desanv01/Flight-Controller-V1/firmware/README.md

# V1 firmware status

No demonstrated final firmware build for the published custom board is available in the inspected package. The historical resource matrix/parser work is in docs/development/records/03-interface-freeze and the development archive. It establishes candidate resource allocation, not a qualified executable firmware.

Use the final schematic/resource map for any board-specific port. V2 binaries and target files are not compatible substitutes. Runtime sensor, power/failsafe and motor-waveform qualification remain outstanding.
