desanv01/Flight-Controller-V1/docs/exports/README.md

# Readable design exports

Schematic, assembly and fabrication PDFs are generated from the exact neutral source. The physical-validation worksheet is blank and must be completed on actual hardware. CAD renders are not photographs.

- [Schematic](schematic.pdf)
- [Assembly](assembly.pdf)
- [Fabrication drawing](fabrication.pdf)
- [Physical worksheet](physical-validation.pdf)
