desanv01/Flight-Controller-V1/docs/overview.md

# Flight Controller V1

Custom STM32H743VIT6 controller developed through staged schematic capture, resource allocation, placement and a six-layer PCB routing rework. The repository preserves its engineering design, manufacturing data and development record.

Engineering prototype. Fabrication data is available; assembly sourcing, stack selection and physical validation remain outstanding. No final V1 firmware build is claimed.

[Contribution statement](../CONTRIBUTIONS.md) · [Source](../hardware/README.md) · [History](development/timeline.md).
