desanv01/Flight-Controller-V1/docs/portfolio/resume-bullets.md

# Resume-ready project wording

Project: **Flight Controller V1**. Contributor: Desan Vasu. Dates reflect technical records, not employment dates. Fabrication external. Select bullets for the intended role rather than using all of them.

- Designed and documented an STM32H743 flight-controller prototype through resource allocation, schematic capture and six-layer PCB implementation.
- Reworked a constrained placement/routing study into an approximately 104 mm board, documenting reference-plane, DNP-isolation and schematic-parity corrections.
- Prepared source-associated manufacturing packages and reviewed native ERC/DRC results with explicit warning and DNP exceptions.

Do not add flight performance, deployment, production reliability or successful powered sensor tests without measured evidence. Original upstream and reference-library work remains separately credited.
