desanv01/Flight-Controller-V1/fabrication/jlcpcb/fabrication/drill-report.txt

Drill report for FC_REV_A.kicad_pcb
Created on 2026-10-14T18:23:01

Copper Layer Stackup:
    =============================================================
    L1 :  F.Cu                      front
    L2 :  GND                       in1
    L3 :  SIGNAL_1                  in2
    L4 :  SIGNAL_2                  in3
    L5 :  POWER                     in4
    L6 :  B.Cu                      back

Drill file 'FC_REV_A-PTH.drl' contains
    plated through holes:
    =============================================================
    T1  0.200mm  0.0079"  (7 holes))
    T2  0.250mm  0.0098"  (524 holes))
    T3  0.600mm  0.0236"  (4 holes)  (with 4 slots)
    T4  1.020mm  0.0402"  (4 holes))

    Total plated holes count 539

Drill file 'FC_REV_A-NPTH.drl' contains
    unplated through holes:
    =============================================================
    T1  0.650mm  0.0256"  (2 holes))
    T2  0.950mm  0.0374"  (2 holes))
    T3  1.020mm  0.0402"  (2 holes))
    T4  2.200mm  0.0866"  (4 holes))
    T5  3.000mm  0.1181"  (1 hole)

    Total unplated holes count 11
