desanv01/Flight-Controller-V1/docs/development/milestones/09-schematic-review.md

# Schematic, footprint and BOM review

Version: V1. Historical evidence period: 2026-09-10. Imported: 14 October 2026.

This milestone preserves technical records. Exact source recovery is recorded separately; document dates do not establish employment dates or physical test completion.

- [FC_REV_A_STAGE_08_CONTROL_REVIEW_2026-09-10.md](../records/09-schematic-review/FC_REV_A_STAGE_08_CONTROL_REVIEW_2026-09-10.md)
- [FC_REV_A_STAGE_08_SCHEMATIC_REVIEW_SYMBOLS_FOOTPRINTS_2026-09-10.md](../records/09-schematic-review/FC_REV_A_STAGE_08_SCHEMATIC_REVIEW_SYMBOLS_FOOTPRINTS_2026-09-10.md)
