desanv01/Flight-Controller-V1/CONTRIBUTIONS.md

# Contributions

**Desan Vasu** ([desanv01](https://github.com/desanv01)) confirmed on 14 October 2026 that the project activities, except physical fabrication, were performed by him. This includes requirements, design/adaptation, CAD review, firmware-related work, build activity, integration preparation, soldering and test activity. Original upstream authorship remains credited separately.

Documented development period: 26 August–14 September 2026. These dates are based on technical records and are not a confirmed employment period or job title.

The repository documents available artifacts and saved/repeated checks. Personal activity confirmation does not establish a particular measured test passed: powered-board, sensor, thermal and flight qualification remain unestablished in the provided evidence. Fabrication was external and is not claimed as personal manufacture.

V1 is the staged custom-controller project; third-party symbols, footprint geometry and source references retain their attribution.
