desanv01/Flight-Controller-V1/docs/development/timeline.md

# Development timeline

Historical dates below come from project records; new import commits use the actual publication date.

| Period | Milestone | Source status | Tag |
|---|---|---|---|
| 2026-08-26 to 2026-08-27 | [Research and architecture baseline](milestones/01-research.md) | Technical records; native fragment archive | `v1-01-research` |
| 2026-08-28 to 2026-09-07 | [Circuit selection and subsystem boundaries](milestones/02-selection.md) | Technical records; native fragment archive | `v1-02-selection` |
| 2026-09-07 | [MCU resource and interface freeze](milestones/03-interface-freeze.md) | Technical records; native fragment archive | `v1-03-interface-freeze` |
| 2026-09-07 | [KiCad foundation](milestones/04-foundation.md) | Technical records; native fragment archive | `v1-04-foundation` |
| 2026-09-07 to 2026-09-08 | [STM32H743 core capture](milestones/05-mcu-core.md) | Technical records; native fragment archive | `v1-05-mcu-core` |
| 2026-09-08 to 2026-09-09 | [Power tree and correction sequence](milestones/06-power.md) | Technical records; native fragment archive | `v1-06-power` |
| 2026-09-09 | [IMU and barometer capture](milestones/07-sensors.md) | Technical records; native fragment archive | `v1-07-sensors` |
| 2026-09-09 to 2026-09-10 | [External interfaces and correction closeout](milestones/08-interfaces.md) | Technical records; native fragment archive | `v1-08-interfaces` |
| 2026-09-10 | [Schematic, footprint and BOM review](milestones/09-schematic-review.md) | Technical records; native fragment archive | `v1-09-schematic-review` |
| 2026-09-10 | [Four-layer placement study](milestones/10-placement.md) | Technical records; native fragment archive | `v1-10-placement` |
| 2026-09-10 to 2026-09-11 | [Initial routing and blockers](milestones/11-routing.md) | Technical records; native fragment archive | `v1-11-routing` |

## Later milestones

V1 continues through six-layer floorplan/routing rework, plane-order and DNP corrections, required-link closeout, final Y2/parity correction and engineering vendor packages. See rework records and v1-parity-closeout.

Neutral naming, metadata reconciliation, source checks, regenerated exports and portfolio presentation are publication work on 14 October 2026. Original exact names/paths remain in private provenance; public hashes describe the transformed source. [Archive](../../archive/README.md).
