desanv01/Flight-Controller-V1/docs/development/records/01-research/FC_REV_A_DECISION_BASELINE_2026-08-27.md

> Historical technical record. Names and private workstation/session references were neutralized for publication. Dates and assertions describe the recorded stage, not current physical qualification. See the current validation-status page for later checks.

# Flight Controller Rev A — Decision Baseline and Interface Contract

Date: 2026-08-27

Revision note: this revision adds the Pixhawk-style modular connectivity decision and the external-port contract. The current addendum also fixes the companion-computer definition to Raspberry Pi Compute Module 5 (CM5), and adds the ESC, motor, LiPo/power, lidar and camera integration boundary.

## Authority and scope

The current user message is the controlling instruction set. The earlier research report is background/reference material; its section numbering, recommendations, and preliminary BOM are not fabrication instructions. This is a student prototype plan, not an aircraft-certification or ready-to-fly approval.

## Decisions now treated as fixed

- The flight controller must be a custom PCB containing a bare MCU chip and the surrounding components. No ready-made MCU/FC development board is the final flight controller.
- The first design should clone/adapt a proven open DIY/reference design wherever practical, because the implementation window is less than one month.
- The FC, ESC/motor board, transmitter/receiver, camera attachment, and lidar attachment are separate team workstreams and must be joined through an explicit interface contract.
- Raspberry Pi Compute Module 5 (CM5) is the optional companion computer. A standard Raspberry Pi 5 SBC is not the selected airborne form factor. CM5 must be mounted on a separate CM5IO/custom carrier board; it must not be soldered directly onto the FC PCB and must not be required for the FC's basic stabilization or RC-loss response.
- The FC shall use a Pixhawk-style, system-level modular architecture: ESCs, receiver, telemetry, CM5 carrier, GNSS/compass, CAN peripherals, and applicable lidar/auxiliary sensors connect through keyed external ports rather than being permanently soldered to the FC assembly.
- Rev A shall use a hybrid sensor boundary: the primary high-rate IMU and barometer stay on the FC PCB; the compass/GNSS and other replaceable or noise-sensitive peripherals are external. A remote IMU/barometer is a future sensor-node option, not a raw long-cable Rev A connection.
- The FC is a logic-and-sensing board, not the propulsion power-distribution board: the FC receives regulated 5 V and measurement signals, while battery current, motor phases, ESC switching heat and high-current copper remain on the separate ESC/power assembly.
- The preferred low-current external connector family is a keyed/latching JST-GH 1.25 mm family or an electrically equivalent locking family. This is a project-level recommendation; the board is called Pixhawk-inspired until the exact Pixhawk standard revision and pinout are deliberately followed and verified.
- The perception split is fixed for Rev A: camera data and scanning/3-D lidar data are processed on CM5; only validated, time-bounded results or high-level setpoints cross to the FC. A downward scalar rangefinder may connect directly to the FC when its voltage/protocol/driver are verified.
- The first flight milestone is a controlled bench/rig demonstration. Propeller-off tests, current limiting, inspection, and instructor/team approval are required before any powered flight test.

## Working hardware baseline — provisional until parts are frozen

Use the H7/Shirley architecture as the closest starting point, with OpenFC and Betaflight layout rules as cross-checks:

- STM32H743VIT6, bare LQFP MCU, with USB, SWD, boot/reset, debug test points, and enough UART/SPI/I2C/CAN resources.
- ICM-42688-P as the primary high-rate IMU on SPI, with its own low-noise sensor supply and a dedicated chip-select/interrupt connection.
- BMP390 on I2C; external magnetometer/GNSS preferred so the magnetic sensor is physically separated from switching power and motor wiring.
- Four motor outputs required for the quad; reserve a clean eight-output-capable timer map only if it does not compromise the first board.
- Regulated 5 V input from the power/ESC side for Rev A, USB-C as a protected bench/debug input, and separate digital/sensor regulation. Do not route motor current through the FC.
- External flash or microSD logging only if it can be implemented without delaying the minimum FC bring-up.

These parts remain recommendations, not purchase authorization. Exact MPN, package, footprint, availability, voltage, current, and firmware support must be checked before the schematic is released.

## Modularity decision

### What “Pixhawk-style modular” means for this project

The project should copy the *system principle* of Pixhawk: a small real-time flight-control core with standardized, labeled, replaceable external interfaces. It does not mean that every sensor IC must be physically outside the FC, and it does not automatically make the custom board electrically compatible with a Pixhawk. The official Pixhawk standards cover pinouts, architecture, PCB guidance, and connector specifications; exact compatibility requires following the selected standard revision rather than merely using the same connector family.

The practical Rev A boundary is:

```text
ON THE FC PCB                         EXTERNAL / REPLACEABLE MODULES
----------------                      -----------------------------
STM32H743 + power                    ESC / motor board
Primary ICM-42688-P IMU              RC receiver
BMP390 barometer                     GNSS + external compass
USB-C / SWD / boot                   Telemetry radio
CAN transceiver(s)                   Raspberry Pi CM5 + carrier
ADC protection                       Downward or simple lidar
                                     Scanning lidar and camera via CM5
```

This is “externally modular, internally deterministic.” It satisfies the team’s modular connection requirement while keeping the sensor data used by the fastest stabilization loop on short, controlled PCB traces.

### Architecture options considered

| Option | FC-board contents | Advantages | Main risks/costs | Rev A decision |
|---|---|---|---|---|
| Fully modular raw-sensor FC | MCU and power only; IMU, barometer, compass, GNSS and other sensors are all external | Maximum replaceability, easy physical separation, very visible modularity | Remote SPI/I2C wiring, cable capacitance/EMI, connector failure, extra latency and timestamp uncertainty, sensor-frame/alignment work, more firmware, no local sensor for reliable boot/bring-up | **Reject for Rev A** |
| Hybrid Pixhawk-style FC | MCU, primary IMU and barometer on board; ESC, receiver, GNSS/compass, CM5, telemetry, CAN and suitable lidar external | Good control-loop integrity, external compass placement, serviceable team interfaces, realistic firmware and PCB scope | More connectors and protection than a compact FPV FC; still requires precise port and firmware definition | **Adopt for Rev A** |
| Mostly onboard FC | MCU and most sensors on board; only ESC, receiver and CM5 external | Lowest connector count and simplest harness | Compass is closer to switching/motor fields; less serviceable; conflicts with the separate sensor workstreams | **Not the selected architecture** |

### Why the primary IMU stays onboard

The rate loop depends on frequent, time-consistent gyro/accelerometer samples. A local SPI IMU gives short traces, a controlled return path, a known mechanical relationship to the FC, and a predictable interrupt/timestamp path. A remote IMU is possible, but it should be a complete smart sensor node with its own MCU, timestamping, calibration and CAN/DroneCAN interface. It should not be a bare IMU hanging from a long unbuffered SPI or I2C cable.

The onboard IMU is therefore a reliability and schedule decision, not a rejection of modular design. A future Rev B may add a second onboard IMU or a remote CAN IMU node if the firmware and validation plan justify it.

### Why the barometer stays onboard for Rev A

The BMP390 is low-rate compared with the IMU, but an onboard device avoids a second remote sensor protocol and connector. It must be placed under a protected vent, away from direct prop wash and pressure disturbances. If the airframe requires a physically remote pressure location, use a dedicated external sensor node with a documented pressure inlet and CAN/UART interface; do not simply extend a raw I2C cable without checking bus capacitance and rise time.

### Why the compass/GNSS is external

The compass benefits from being physically separated from battery conductors, motor phases, ESC switching currents, inductors and ferromagnetic hardware. GNSS also needs antenna placement and sky visibility that the FC PCB cannot guarantee. The preferred module is an external GPS/compass unit connected by UART plus I2C, or by DroneCAN where a compatible node is available. Its mounting orientation and position relative to the FC must be documented for firmware calibration and frame transforms.

## Modular bus and connector strategy

### Bus selection

| Bus/interface | Rev A use | Cable rule | Design decision |
|---|---|---|---|
| SPI | Primary onboard IMU, memory, SD, and other local devices | Keep on the PCB or on a very short, mechanically retained daughterboard; route over a continuous return path | Do not expose the high-rate IMU SPI bus as a general long harness |
| I2C | Onboard BMP390 and short external compass/low-speed accessory port | Treat as a short, low-speed bus; calculate total pull-up/cable/connector capacitance; make pull-ups selectable | Suitable for GPS/compass only when the cable and loading are verified |
| UART | RC receiver, GNSS, telemetry radio, simple lidar, and FC↔CM5 MAVLink/data link | Point-to-point; signal level must be compatible; include a ground return | Use dedicated labeled UART ports rather than one ambiguous expansion header |
| CAN / DroneCAN | Remote sensor nodes, external GNSS/compass, lidar nodes, and CAN-capable ESC/power modules | Differential pair, line topology, short stubs, 120 Ω termination only at the two bus ends | Preferred robust path for future smart external sensors |
| PWM/DShot | FC to the external ESC board | One defined signal and ground return per output; no motor current on this harness | Four outputs required; bidirectional DShot telemetry only if the selected firmware/ESC path supports it |
| USB/CSI-2/Ethernet | Camera and high-volume data on CM5 | Camera stays on CM5; do not route camera frames through the FC | FC gets only trigger/status or processed measurements when required |

NXP’s I2C specification treats wire, connector and pin capacitance as part of the bus capacitance and gives a 400 pF limit for the common Standard/Fast modes. TI’s long-cable guidance describes buffers/extenders for cases that exceed the normal bus loading. This is why an external compass on a short harness is reasonable, while a remote raw IMU on an arbitrary cable is not a good Rev A assumption. CAN is better suited to remote nodes: the CAN in Automation guidance calls for a line topology and 120 Ω termination at the two bus ends.

### Proposed logical port map

The names below are the design contract. The final connector family, pin order and MPN remain to be frozen after the ESC, receiver, GNSS/compass, lidar and power-board teams provide their exact requirements.

| Port label | Signals | Intended module | Important boundary |
|---|---|---|---|
| `POWER1` | Regulated 5 V, GND, scaled battery-voltage sense, protected current-sense input; optional power-status signal | ESC/power board or external power module | Logic/measurement only; motor and battery current paths do not pass through the FC PCB |
| `ESC_OUT` | `M1..M4` signal, signal grounds; optional telemetry returns or CANH/CANL on a separate CAN port | External ESC board | Use the exact PWM/DShot/CAN choice agreed with the ESC workstream; define reset/disable state |
| `RC_IN` | Module supply, GND, receiver UART RX; optional TX/telemetry | External transmitter/receiver assembly | Protocol and voltage must be frozen; FC owns RC timeout and arming/failsafe response |
| `GPS1` | Module supply, GND, GNSS UART TX/RX, PPS; optional I2C SDA/SCL for compass | External GNSS + compass module | A Pixhawk-compatible GPS port requires the exact selected Pixhawk pinout, not just a JST-GH connector |
| `GPS2/AUX_I2C` | Supply, GND, SDA/SCL, optional interrupt | Second GNSS/compass or short low-speed accessory | Pull-ups must be selectable; no assumption of unlimited cable length or hot-plugging |
| `CAN1`, `CAN2` | Supply, GND, CANH, CANL; optional shield/drain strategy | DroneCAN GPS/compass, lidar, power node or CAN ESC | Add switchable 120 Ω termination; use a bus backbone, not an uncontrolled star |
| `TELEM1` | UART TX/RX/GND; optional CTS/RTS | Ground telemetry radio or serial peripheral | 3.3 V logic; protect external signals; no high-current supply requirement |
| `COMPANION` | UART TX/RX/GND and optional CTS/RTS; optional Ethernet/USB only if separately designed | Raspberry Pi CM5 on a separate carrier | Data connector is not the CM5 power source; the carrier gets a separate filtered 5 V supply sized for the CM5 workload |
| `LIDAR_FC` | UART, I2C or CAN as selected, supply and GND | Downward scalar rangefinder or low-latency lidar | Direct FC connection is preferred for altitude/landing data when the flight stack supports the sensor |
| `AUX_UART` | UART TX/RX/GND, optional interrupt/status | Future rangefinder or sensor | One logical function per labeled port; do not silently share with receiver/GNSS |
| `AUX_SPI` | Short local SPI plus chip-select/interrupt/GND | Engineering daughterboard or future local sensor | Not a general long flight harness; use a local smart node for remote high-rate sensors |
| `SWD/DEBUG` | SWDIO, SWCLK, NRST, 3V3 reference, GND; BOOT0 test access | ST-LINK/debugger | Keep accessible even when all external modules are connected |
| `USB-C` | USB D+/D−, VBUS sensing/protected input, GND | Bench flashing/configuration/logging | USB power mux/protection must not create an uncontrolled back-power path |

### Connector rules

1. Use keyed, locking, vibration-tolerant connectors with a documented mating cable. Do not use loose Dupont jumpers for the flight harness.
2. Put at least one ground return beside fast or noise-sensitive signal groups. Keep CANH/CANL as a differential pair and keep their untwisted connector section short.
3. Print the port name, pin 1/index and signal names on the silkscreen or in an accompanying wiring drawing. “UART1” alone is not enough; label the function as `RC_IN`, `GPS1`, `COMPANION`, etc.
4. Separate power pins from signal groups and specify each port’s allowed voltage/current. A port’s accessory supply is not automatically a safe source for another team’s board.
5. Add ESD/overvoltage protection where the risk justifies it, especially on long external UART, CAN, USB and exposed power inputs. Keep protection placement close to the connector and verify its capacitance against the signal rate.
6. Make external-module power switching/current limiting a deliberate decision. Rev A does not assume safe hot-plugging; power down before changing a module unless that port is specifically designed and tested for hot-swap.
7. Use a continuous ground plane and controlled return paths on the FC. Use twisted/shielded wiring and physical separation from motor phases and battery leads where the harness is exposed to switching noise.
8. Put selectable I2C pull-ups and CAN termination on the appropriate side of the interface. Avoid duplicate strong pull-ups or duplicate CAN termination from multiple modules.
9. Give every external sensor a documented voltage level, protocol, address/node ID, orientation, position relative to the FC, cable length and maximum update rate.
10. Provide test points and a bench loopback/test cable for each critical external interface. The modular design must be testable without attaching the complete vehicle.
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
