desanv01/Flight-Controller-V1/docs/development/records/01-research/FC_REV_A_MASTER_RESEARCH_AND_DECISION_RECORD_2026-08-27.md

> Historical technical record. Names and private workstation/session references were neutralized for publication. Dates and assertions describe the recorded stage, not current physical qualification. See the current validation-status page for later checks.

# Flight Controller Rev A — Master Research, Architecture, Interface & Implementation Record
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
