desanv01/Flight-Controller-V1/fabrication/jlcpcb/assembly/FC_REV_A-BOM.csv

Refs | Value | Footprint | MPN | Manufacturer | LCSC | Description | Status | Specification | Datasheet | Qty | DNP
C1-C5,C9,C11,C13,C14 | 100n | FC_REV_A_Local:Capacitor_SMD__C_0603_1608Metric |  |  |  |  | DECISION - generic capacitor; production MPN OPEN | Ceramic 100 nF; one per VDD/VSS pair; voltage >=6.3 V; effective capacitance review Stage 08,Ceramic; local decoupling; >=6.3 V; production MPN/footprint OPEN,NRST protection 100 nF; rely on internal pull-up; no button/supervisor |  | 9
C6 | 4.7u | FC_REV_A_Local:Capacitor_SMD__C_0603_1608Metric |  |  |  |  | DECISION - generic capacitor; production MPN OPEN | Ceramic; effective package bulk >=4.7 uF at 3.3 V; voltage >=6.3 V |  | 1
C7,C8 | 2.2u | FC_REV_A_Local:Capacitor_SMD__C_0603_1608Metric |  |  |  |  | DECISION - generic capacitor; production MPN OPEN | Ceramic; 2.2 uF effective +/-20%; ESR <100 mOhm; >=6.3 V; place at pin 48,Ceramic; 2.2 uF effective +/-20%; ESR <100 mOhm; >=6.3 V; place at pin 73 |  | 2
C10,C12 | 1u | FC_REV_A_Local:Capacitor_SMD__C_0603_1608Metric |  |  |  |  | DECISION - generic capacitor; production MPN OPEN | Ceramic; local decoupling; >=6.3 V; production MPN/footprint OPEN |  | 2
C15,C16 | 24p | FC_REV_A_Local:Capacitor_SMD__C_0603_1608Metric |  |  |  |  | RECOMMENDATION - calculated HSE load | RECOMMENDATION C0G/NP0 1%; C=2*(18pF-6pF)=24pF; Cs=6pF ASSUMPTION, 5..7pF bound; verify layout/startup/drive |  | 2
C17,C18 | TBD DNP | FC_REV_A_Local:Capacitor_SMD__C_0603_1608Metric |  |  |  |  | DNP - value OPEN |  |  | 2 | DNP
C19,C20,C27-C29,C38,C42 | 100n | FC_REV_A_Local:Capacitor_SMD__C_1206_3216Metric | C1206C104J5GACTU | KEMET |  |  | RECOMMENDATION - R18; OPEN UNTESTED | 50V C0G 5%; +/-6% total timing/edge budget | http[LOCAL_SOURCE] | 7
C21,C23-C25,C30-C34,C40,C41,C47-C50,C100 | 22u | FC_REV_A_Local:Capacitor_SMD__C_1210_3225Metric | GRM32ER71E226KE15L | Murata |  |  | RECOMMENDATION - R18; OPEN UNTESTED,RECOMMENDATION - Stage07; OPEN UNTESTED | 25V X7R 10%; assumed effective 10..28u at <=5.5V incl bias/temp/aging; verify lot/model | http[LOCAL_SOURCE] | 16
C22,C26,C35,C39,C43-C46,C51,C54-C57,C62-C99,C101 | 100n | FC_REV_A_Local:Capacitor_SMD__C_0603_1608Metric | GRM188R71H104KA93D | Murata |  |  | RECOMMENDATION - R18; OPEN UNTESTED,RECOMMENDATION - Stage06; OPEN UNTESTED,RECOMMENDATION - Stage07; OPEN UNTESTED | 50V X7R +/-10%; bypass,50V X7R 10%; noncritical local bypass | http[LOCAL_SOURCE] | 52 | DNP
C36,C52 | 2.2u | FC_REV_A_Local:Capacitor_SMD__C_1206_3216Metric | GRM31CR71H225KA88L | Murata |  |  | RECOMMENDATION - R18; OPEN UNTESTED,RECOMMENDATION - Stage06; OPEN UNTESTED | 50V X7R +/-10%; effective 1.5..2.7u assumption, validate bias/temp/aging,50V X7R 10%; effective compensation 1.5..2.7u ASSUMPTION | http[LOCAL_SOURCE] | 2
C37 | 4.7n | FC_REV_A_Local:Capacitor_SMD__C_0603_1608Metric | C0603C472J5GACTU | KEMET |  |  | RECOMMENDATION - R18; OPEN UNTESTED | 50V C0G 5%; +/-6% total | http[LOCAL_SOURCE] | 1
C53 | 10n | FC_REV_A_Local:Capacitor_SMD__C_0603_1608Metric | GRM188R71H103KA01D | Murata |  |  | RECOMMENDATION - Stage06; OPEN UNTESTED | 50V X7R +/-10%; TDK VDDIO bypass | http[LOCAL_SOURCE] | 1
C58,C60,C61 | 1u | FC_REV_A_Local:Capacitor_SMD__C_1206_3216Metric | GRM31CR71H105KA61L | Murata |  |  | RECOMMENDATION - Stage06; OPEN UNTESTED | 50V X7R +/-10%; effective 0.5..1.2u assumption | http[LOCAL_SOURCE] | 3
C59 | 22n | FC_REV_A_Local:Capacitor_SMD__C_1206_3216Metric | C1206C223J5GACTU | KEMET |  |  | RECOMMENDATION - Stage06; OPEN UNTESTED | 50V C0G +/-5%; slew timing; total +/-6% engineering allowance | http[LOCAL_SOURCE] | 1
D1 | GREEN optional | FC_REV_A_Local:LED_SMD__LED_0603_1608Metric | APT1608LZGCK | Kingbright |  |  | RECOMMENDATION - Stage07; OPEN UNTESTED | DNP prototype option; verify Vf/bin at later BOM gate | http[LOCAL_SOURCE] | 1 | DNP
FB1 | 600R@100MHz | FC_REV_A_Local:Inductor_SMD__L_0603_1608Metric | BLM18AG601SN1D | Murata |  |  | RECOMMENDATION - R18; OPEN UNTESTED | 600Ohm at100MHz; 0.38Ohm max DCR; 500mA; ANA50mA; damping/layout validation OPEN | http[LOCAL_SOURCE] | 1
J1 | ESC BENCH: positions 1/4 ABSENT |  | ESC_SPARSE_BENCH | Controlled custom bench interposer |  |  | RECOMMENDATION - Stage07; OPEN UNTESTED | Exact physical contact contract in Stage07 handoff; footprint recommendation only | Controlled Stage01 interposer drawing; OpenESC commit 1da7dbd046760160639fb9c3f470702250b4b2cb | 1
J2 | CURR contact J1-3: DNP |  | DNP_SERVICE_CONTACT |  |  |  | RECOMMENDATION - Stage07; OPEN UNTESTED | Single optional service termination; no one-position GH product claimed | Controlled optional CURR bench termination; not a catalogue connector | 1 | DNP
J3 | RC_IN | FC_REV_A_Local:Connector_JST__JST_GH_BM04B-GHS-TBT_1x04-1MP_P1.25mm_Vertical | BM04B-GHS-TBT(LF)(SN) | JST |  |  | RECOMMENDATION - Stage07; OPEN UNTESTED | Logical pin numbering from FC connector mating face; verify mechanical drawing before PCB | http[LOCAL_SOURCE] | 1
J4 | GPS1 | FC_REV_A_Local:Connector_JST__JST_GH_BM08B-GHS-TBT_1x08-1MP_P1.25mm_Vertical | BM08B-GHS-TBT(LF)(SN) | JST |  |  | RECOMMENDATION - Stage07; OPEN UNTESTED | Logical pin numbering from FC connector mating face; verify mechanical drawing before PCB | http[LOCAL_SOURCE] | 1
J5 | TELEM1 | FC_REV_A_Local:Connector_JST__JST_GH_BM06B-GHS-TBT_1x06-1MP_P1.25mm_Vertical | BM06B-GHS-TBT(LF)(SN) | JST |  |  | RECOMMENDATION - Stage07; OPEN UNTESTED | Logical pin numbering from FC connector mating face; verify mechanical drawing before PCB | http[LOCAL_SOURCE] | 1
J6 | COMPANION | FC_REV_A_Local:Connector_JST__JST_GH_BM06B-GHS-TBT_1x06-1MP_P1.25mm_Vertical | BM06B-GHS-TBT(LF)(SN) | JST |  |  | RECOMMENDATION - Stage07; OPEN UNTESTED | Logical pin numbering from FC connector mating face; verify mechanical drawing before PCB | http[LOCAL_SOURCE] | 1
J7 | CAN1 | FC_REV_A_Local:Connector_JST__JST_GH_BM04B-GHS-TBT_1x04-1MP_P1.25mm_Vertical | BM04B-GHS-TBT(LF)(SN) | JST |  |  | RECOMMENDATION - Stage07; OPEN UNTESTED | Logical pin numbering from FC connector mating face; verify mechanical drawing before PCB | http[LOCAL_SOURCE] | 1
J8 | CAN2_EVAL | FC_REV_A_Local:Connector_JST__JST_GH_BM04B-GHS-TBT_1x04-1MP_P1.25mm_Vertical | BM04B-GHS-TBT(LF)(SN) | JST |  |  | RECOMMENDATION - Stage07; OPEN UNTESTED | Logical pin numbering from FC connector mating face; verify mechanical drawing before PCB | http[LOCAL_SOURCE] | 1 | DNP
J9 | USB-C GCT USB4105 | FC_REV_A_Local:GCT_USB4105_GF_A_095_S1_S4 | USB4105-GF-A | GCT |  |  | RECOMMENDATION - Stage07; OPEN UNTESTED | Exact physical contact contract in Stage07 handoff; footprint recommendation only | http[LOCAL_SOURCE] | 1
J10 | SWD probe / target powered | FC_REV_A_Local:Connector_JST__JST_GH_BM06B-GHS-TBT_1x06-1MP_P1.25mm_Vertical | BM06B-GHS-TBT(LF)(SN) | JST |  |  | RECOMMENDATION - Stage07; OPEN UNTESTED | Logical pin numbering from FC connector mating face; verify mechanical drawing before PCB | http[LOCAL_SOURCE] | 1
J11 | BOOT service shunt DNP | FC_REV_A_Local:Connector_JST__JST_GH_BM02B-GHS-TBT_1x02-1MP_P1.25mm_Vertical | BM02B-GHS-TBT(LF)(SN) | JST |  |  | RECOMMENDATION - Stage07; OPEN UNTESTED | Logical pin numbering from FC connector mating face; verify mechanical drawing before PCB | http[LOCAL_SOURCE] | 1 | DNP
J12 | microSD GCT MEM2075 | FC_REV_A_Local:GCT_MEM2075_00_140_01_A | MEM2075-00-140-01-A | GCT |  |  | RECOMMENDATION - Stage07; OPEN UNTESTED | Exact physical contact contract in Stage07 handoff; footprint recommendation only | http[LOCAL_SOURCE] | 1
J_ESC_FC? | SM05B-SRSS-TB | FC_REV_A_Local:ESC_JST_SH_SM05B_SRSS_TB | SM05B-SRSS-TB | JST |  |  | RECOMMENDATION - Stage10; OPEN UNTESTED |  | http[LOCAL_SOURCE] | 1
J_POWER1 | 43045-0600 | FC_REV_A_Local:POWER1_Molex_43045_0600_4Electrical_2NPTH | 43045-0600 | Molex |  |  | RECOMMENDATION - Stage10; OPEN UNTESTED |  | http[LOCAL_SOURCE] | 1
L1 | 2.2u | FC_REV_A_Local:Inductor_SMD__L_Coilcraft_XAL4020-XXX | XAL4020-222MEC | Coilcraft |  |  | RECOMMENDATION - R18; OPEN UNTESTED | 2.2u +/-20%; DCR max38.7mOhm at25C; Isat5.6A (30% drop); Irms4A/20C rise | http[LOCAL_SOURCE] | 1
L2 | 6.8u | FC_REV_A_Local:Inductor_SMD__L_Coilcraft_XAL7070-XXX | XAL7070-682MEC | Coilcraft |  |  | RECOMMENDATION - R18; OPEN UNTESTED | 6.8u +/-20%; DCR max19.62mOhm; Isat12.8A at30% drop; Irms6.8A/20C rise; fault pulse qualification OPEN | http[LOCAL_SOURCE] | 1
R1 | 10k | FC_REV_A_Local:Resistor_SMD__R_0603_1608Metric |  |  |  |  | DECISION - topology/value; MPN/footprint OPEN | BOOT0 pulldown; generic resistor; 1% recommended |  | 1
R2 | 28.7k | FC_REV_A_Local:Resistor_SMD__R_0603_1608Metric | RT0603BRD0728K7L | Yageo |  |  | RECOMMENDATION - R18; OPEN UNTESTED | Thin film 0.1%, 25ppm/C; +/-0.5% TOTAL design budget; 0.1W; 50% power derating | http[LOCAL_SOURCE] | 1
R3,R5,R9,R12,R13,R15,R20,R22,R25,R32,R34,R37 | 10k | FC_REV_A_Local:Resistor_SMD__R_0603_1608Metric | RT0603BRD0710KL | Yageo |  |  | RECOMMENDATION - R18; OPEN UNTESTED | Thin film 0.1%, 25ppm/C; +/-0.5% TOTAL design budget; 0.1W; 50% power derating | http[LOCAL_SOURCE] | 12
R4 | 37.4k | FC_REV_A_Local:Resistor_SMD__R_0603_1608Metric | RT0603BRD0737K4L | Yageo |  |  | RECOMMENDATION - R18; OPEN UNTESTED | Thin film 0.1%, 25ppm/C; +/-0.5% TOTAL design budget; 0.1W; 50% power derating | http[LOCAL_SOURCE] | 1
R6 | 732 | FC_REV_A_Local:Resistor_SMD__R_0603_1608Metric | RT0603BRD07732RL | Yageo |  |  | RECOMMENDATION - R18; OPEN UNTESTED | Thin film 0.1%, 25ppm/C; +/-0.5% TOTAL design budget; 0.1W; 50% power derating | http[LOCAL_SOURCE] | 1
R7 | 100 | FC_REV_A_Local:Resistor_SMD__R_0603_1608Metric | RT0603BRD07100RL | Yageo |  |  | RECOMMENDATION - R18; OPEN UNTESTED | Thin film 0.1%, 25ppm/C; +/-0.5% TOTAL design budget; 0.1W; 50% power derating | http[LOCAL_SOURCE] | 1
R8,R10,R28,R31,R33,R36 | 100k | FC_REV_A_Local:Resistor_SMD__R_0603_1608Metric | RT0603BRD07100KL | Yageo |  |  | RECOMMENDATION - R18; OPEN UNTESTED | Thin film 0.1%, 25ppm/C; +/-0.5% TOTAL design budget; 0.1W; 50% power derating | http[LOCAL_SOURCE] | 6
R11 | 31.2k | FC_REV_A_Local:Resistor_SMD__R_0603_1608Metric | RT0603BRD0731K2L | Yageo |  |  | RECOMMENDATION - R18; OPEN UNTESTED | Thin film 0.1%, 25ppm/C; +/-0.5% TOTAL design budget; 0.1W; 50% power derating | http[LOCAL_SOURCE] | 1
R14 | 31.6k | FC_REV_A_Local:Resistor_SMD__R_0603_1608Metric | RT0603BRD0731K6L | Yageo |  |  | RECOMMENDATION - R18; OPEN UNTESTED | Thin film 0.1%, 25ppm/C; +/-0.5% TOTAL design budget; 0.1W; 50% power derating | http[LOCAL_SOURCE] | 1
R16,R30 | 49.9k | FC_REV_A_Local:Resistor_SMD__R_0603_1608Metric | RT0603BRD0749K9L | Yageo |  |  | RECOMMENDATION - R18; OPEN UNTESTED | Thin film 0.1%, 25ppm/C; +/-0.5% TOTAL design budget; 0.1W; 50% power derating | http[LOCAL_SOURCE] | 2
R17 | 680 | FC_REV_A_Local:Resistor_SMD__R_0603_1608Metric | RT0603BRD07680RL | Yageo |  |  | RECOMMENDATION - R18; OPEN UNTESTED | Thin film 0.1%, 25ppm/C; +/-0.5% TOTAL design budget; 0.1W; 50% power derating | http[LOCAL_SOURCE] | 1
R18 | 71.5k | FC_REV_A_Local:Resistor_SMD__R_0603_1608Metric | RT0603BRD0771K5L | Yageo |  |  | RECOMMENDATION - R18; OPEN UNTESTED | Thin film 0.1%, 25ppm/C; +/-0.5% TOTAL design budget; 0.1W; 50% power derating | http[LOCAL_SOURCE] | 1
R19,R24 | 34.8k | FC_REV_A_Local:Resistor_SMD__R_0603_1608Metric | RT0603BRD0734K8L | Yageo |  |  | RECOMMENDATION - R18; OPEN UNTESTED | Thin film 0.1%, 25ppm/C; +/-0.5% TOTAL design budget; 0.1W; 50% power derating | http[LOCAL_SOURCE] | 2
R21 | 45.3k | FC_REV_A_Local:Resistor_SMD__R_0603_1608Metric | RT0603BRD0745K3L | Yageo |  |  | RECOMMENDATION - R18; OPEN UNTESTED | Thin film 0.1%, 25ppm/C; +/-0.5% TOTAL design budget; 0.1W; 50% power derating | http[LOCAL_SOURCE] | 1
R23 | 1k | FC_REV_A_Local:Resistor_SMD__R_0603_1608Metric | RT0603BRD071KL | Yageo |  |  | RECOMMENDATION - R18; OPEN UNTESTED | Thin film 0.1%, 25ppm/C; +/-0.5% TOTAL design budget; 0.1W; 50% power derating | http[LOCAL_SOURCE] | 1
R26,R35 | 220k | FC_REV_A_Local:Resistor_SMD__R_0603_1608Metric | RT0603BRD07220KL | Yageo |  |  | RECOMMENDATION - R18; OPEN UNTESTED | Thin film 0.1%, 25ppm/C; +/-0.5% TOTAL design budget; 0.1W; 50% power derating | http[LOCAL_SOURCE] | 2
R27,R58,R61,R64,R67,R101,R102,R105,R106,R113,R114,R119,R121,R123,R125,R127 | 0 | FC_REV_A_Local:Resistor_SMD__R_0603_1608Metric | RC0603JR-070RL | Yageo |  |  | RECOMMENDATION - R18; OPEN UNTESTED,RECOMMENDATION - Stage07; OPEN UNTESTED | Thick film 1% (0R jumper 5% family); total +/-3% design allowance; 0.1W; 50% power derating,Thin film 0.1%, 25ppm/C; +/-0.5% TOTAL design budget; 0.1W; 50% power derating | http[LOCAL_SOURCE] | 16 | DNP
R29 | 137k | FC_REV_A_Local:Resistor_SMD__R_0603_1608Metric | RT0603BRD07137KL | Yageo |  |  | RECOMMENDATION - R18; OPEN UNTESTED | Thin film 0.1%, 25ppm/C; +/-0.5% TOTAL design budget; 0.1W; 50% power derating | http[LOCAL_SOURCE] | 1
R38,R42-R46,R48,R69 | 100k | FC_REV_A_Local:Resistor_SMD__R_0603_1608Metric | RC0603FR-07100KL | Yageo |  |  | RECOMMENDATION - Stage06; OPEN UNTESTED,RECOMMENDATION - Stage07; OPEN UNTESTED | Thick film 1% (0R jumper 5% family); total +/-3% design allowance; 0.1W; 50% power derating,Thick film 1%; total +/-3% design allowance incl temperature; 0.1W; 50% power derating | http[LOCAL_SOURCE] | 8 | DNP
R39,R40,R53 | 1.5M | FC_REV_A_Local:Resistor_SMD__R_0603_1608Metric | RC0603FR-071M5L | Yageo |  |  | RECOMMENDATION - Stage06; OPEN UNTESTED | Thick film 1%; total +/-3% design allowance incl temperature; 0.1W; 50% power derating | http[LOCAL_SOURCE] | 3
R41 | 300 | FC_REV_A_Local:Resistor_SMD__R_0603_1608Metric | RC0603FR-07300RL | Yageo |  |  | RECOMMENDATION - Stage06; OPEN UNTESTED | Thick film 1%; total +/-3% design allowance incl temperature; 0.1W; 50% power derating | http[LOCAL_SOURCE] | 1
R47,R117 | 680 | FC_REV_A_Local:Resistor_SMD__R_0603_1608Metric | RC0603FR-07680RL | Yageo |  |  | RECOMMENDATION - Stage06; OPEN UNTESTED,RECOMMENDATION - Stage07; OPEN UNTESTED | Thick film 1% (0R jumper 5% family); total +/-3% design allowance; 0.1W; 50% power derating,Thick film 1%; total +/-3% design allowance incl temperature; 0.1W; 50% power derating | http[LOCAL_SOURCE] | 2
R49 | 910 | FC_REV_A_Local:Resistor_SMD__R_0603_1608Metric | RC0603FR-07910RL | Yageo |  |  | RECOMMENDATION - Stage06; OPEN UNTESTED | Thick film 1%; total +/-3% design allowance incl temperature; 0.1W; 50% power derating | http[LOCAL_SOURCE] | 1
R50,R51 | 4.7k | FC_REV_A_Local:Resistor_SMD__R_0603_1608Metric | RC0603FR-074K7L | Yageo |  |  | RECOMMENDATION - Stage06; OPEN UNTESTED | Thick film 1%; total +/-3% design allowance incl temperature; 0.1W; 50% power derating | http[LOCAL_SOURCE] | 2
R52,R54-R56,R70,R75,R79,R83,R87,R91,R95,R98,R110 | 22k | FC_REV_A_Local:Resistor_SMD__R_0603_1608Metric | RC0603FR-0722KL | Yageo |  |  | RECOMMENDATION - Stage06; OPEN UNTESTED,RECOMMENDATION - Stage07; OPEN UNTESTED | Thick film 1% (0R jumper 5% family); total +/-3% design allowance; 0.1W; 50% power derating,Thick film 1%; total +/-3% design allowance incl temperature; 0.1W; 50% power derating | http[LOCAL_SOURCE] | 13 | DNP
R57,R59,R60,R62,R63,R65,R66,R68,R72,R74,R76,R78,R80,R82,R84,R86,R88,R90,R92,R94,R96,R97,R109,R120,R122,R124,R126,R128,R129 | 47k | FC_REV_A_Local:Resistor_SMD__R_0603_1608Metric | RC0603FR-0747KL | Yageo |  |  | RECOMMENDATION - Stage07; OPEN UNTESTED | Thick film 1% (0R jumper 5% family); total +/-3% design allowance; 0.1W; 50% power derating | http[LOCAL_SOURCE] | 29
R71,R108,R116,R130 | 1k | FC_REV_A_Local:Resistor_SMD__R_0603_1608Metric | RC0603FR-071KL | Yageo |  |  | RECOMMENDATION - Stage07; OPEN UNTESTED | Thick film 1% (0R jumper 5% family); total +/-3% design allowance; 0.1W; 50% power derating | http[LOCAL_SOURCE] | 4 | DNP
R73,R77,R81,R85,R89,R93 | 47 | FC_REV_A_Local:Resistor_SMD__R_0603_1608Metric | RC0603FR-0747RL | Yageo |  |  | RECOMMENDATION - Stage07; OPEN UNTESTED | Thick film 1% (0R jumper 5% family); total +/-3% design allowance; 0.1W; 50% power derating | http[LOCAL_SOURCE] | 6
R99,R115 | 3.3k | FC_REV_A_Local:Resistor_SMD__R_0603_1608Metric | RC0603FR-073K3L | Yageo |  |  | RECOMMENDATION - Stage07; OPEN UNTESTED | Thick film 1% (0R jumper 5% family); total +/-3% design allowance; 0.1W; 50% power derating | http[LOCAL_SOURCE] | 2
R100,R104 | 10k | FC_REV_A_Local:Resistor_SMD__R_0603_1608Metric | RC0603FR-0710KL | Yageo |  |  | RECOMMENDATION - Stage07; OPEN UNTESTED | Thick film 1% (0R jumper 5% family); total +/-3% design allowance; 0.1W; 50% power derating | http[LOCAL_SOURCE] | 2 | DNP
R103,R107 | 120 | FC_REV_A_Local:Resistor_SMD__R_2010_5025Metric | RC2010FK-07120RL | Yageo |  |  | RECOMMENDATION - Stage07; OPEN UNTESTED | 120R termination: 0.75W, 1%, 50% derating; <=5V differential design case | http[LOCAL_SOURCE] | 2 | DNP
R111,R112 | 5.1k | FC_REV_A_Local:Resistor_SMD__R_0603_1608Metric | RC0603FR-075K1L | Yageo |  |  | RECOMMENDATION - Stage07; OPEN UNTESTED | Thick film 1% (0R jumper 5% family); total +/-3% design allowance; 0.1W; 50% power derating | http[LOCAL_SOURCE] | 2
R118 | 22 | FC_REV_A_Local:Resistor_SMD__R_0603_1608Metric | RC0603FR-0722RL | Yageo |  |  | RECOMMENDATION - Stage07; OPEN UNTESTED | Thick film 1% (0R jumper 5% family); total +/-3% design allowance; 0.1W; 50% power derating | http[LOCAL_SOURCE] | 1
TP1 | NRST | FC_REV_A_Local:TestPoint__TestPoint_Pad_D1.0mm |  |  |  |  | DECISION - required access; pad/fixture geometry OPEN | Physical geometry/accessibility Stage 08/09 |  | 1
TP2 | BOOT0 | FC_REV_A_Local:TestPoint__TestPoint_Pad_D1.0mm |  |  |  |  | DECISION - required access; pad/fixture geometry OPEN | Physical geometry/accessibility Stage 08/09 |  | 1
TP3 | SWDIO | FC_REV_A_Local:TestPoint__TestPoint_Pad_D1.0mm |  |  |  |  | DECISION - required access; pad/fixture geometry OPEN | Physical geometry/accessibility Stage 08/09 |  | 1
TP4 | SWCLK | FC_REV_A_Local:TestPoint__TestPoint_Pad_D1.0mm |  |  |  |  | DECISION - required access; pad/fixture geometry OPEN | Physical geometry/accessibility Stage 08/09 |  | 1
TP5 | SWO | FC_REV_A_Local:TestPoint__TestPoint_Pad_D1.0mm |  |  |  |  | DNP - optional physical SWO access | Physical geometry/accessibility Stage 08/09 |  | 1 | DNP
TP6 | GND | FC_REV_A_Local:TestPoint__TestPoint_Pad_D1.0mm |  |  |  |  | DECISION - required access; pad/fixture geometry OPEN | Physical geometry/accessibility Stage 08/09 |  | 1
TP7 | 3V3_REF | FC_REV_A_Local:TestPoint__TestPoint_Pad_D1.0mm |  |  |  |  | DECISION - required access; pad/fixture geometry OPEN | Sense/reference only <=10 mA; no target power injection |  | 1
TP8 | 5V_FC_IN | FC_REV_A_Local:TestPoint__TestPoint_Pad_D1.0mm | PCB_TEST_PAD |  |  |  | RECOMMENDATION - R18; OPEN UNTESTED | Required rail access; pad/fixture geometry RECOMMENDATION Stage08/09 |  | 1
TP9 | 5V_FC_PROTECTED | FC_REV_A_Local:TestPoint__TestPoint_Pad_D1.0mm | PCB_TEST_PAD |  |  |  | RECOMMENDATION - R18; OPEN UNTESTED | Required rail access; pad/fixture geometry RECOMMENDATION Stage08/09 |  | 1
TP10 | 5V_AUX | FC_REV_A_Local:TestPoint__TestPoint_Pad_D1.0mm | PCB_TEST_PAD |  |  |  | RECOMMENDATION - R18; OPEN UNTESTED | Required rail access; pad/fixture geometry RECOMMENDATION Stage08/09 |  | 1
TP11 | 3V3_MAIN | FC_REV_A_Local:TestPoint__TestPoint_Pad_D1.0mm | PCB_TEST_PAD |  |  |  | RECOMMENDATION - R18; OPEN UNTESTED | Required rail access; pad/fixture geometry RECOMMENDATION Stage08/09 |  | 1
TP12 | 3V3_SENS | FC_REV_A_Local:TestPoint__TestPoint_Pad_D1.0mm | PCB_TEST_PAD |  |  |  | RECOMMENDATION - R18; OPEN UNTESTED | Required rail access; pad/fixture geometry RECOMMENDATION Stage08/09 |  | 1
TP13 | 3V3_ANA | FC_REV_A_Local:TestPoint__TestPoint_Pad_D1.0mm | PCB_TEST_PAD |  |  |  | RECOMMENDATION - R18; OPEN UNTESTED | Required rail access; pad/fixture geometry RECOMMENDATION Stage08/09 |  | 1
TP14 | PWR_STATUS | FC_REV_A_Local:TestPoint__TestPoint_Pad_D1.0mm | PCB_TEST_PAD |  |  |  | RECOMMENDATION - R18; OPEN UNTESTED | Required rail access; pad/fixture geometry RECOMMENDATION Stage08/09 |  | 1
TP15 | GND | FC_REV_A_Local:TestPoint__TestPoint_Pad_D1.0mm | PCB_TEST_PAD |  |  |  | RECOMMENDATION - R18; OPEN UNTESTED | Required rail access; pad/fixture geometry RECOMMENDATION Stage08/09 |  | 1
U1 | STM32H743VIT6 | FC_REV_A_Local:Package_QFP__LQFP-100_14x14mm_P0.5mm |  |  |  |  | DECISION - topology/value; MPN/footprint OPEN |  | http[LOCAL_SOURCE] | 1
U2 | TPS259470LRPWR | FC_REV_A_Local:TI_RPW0010_HotRod_2x2 | TPS259470LRPWR | Texas Instruments | C3662793 |  | RECOMMENDATION - R18; OPEN UNTESTED |  | http[LOCAL_SOURCE] | 1
U3,U11 | TPS3808G01DBVR | FC_REV_A_Local:Package_TO_SOT_SMD__SOT-23-6 | TPS3808G01DBVR | Texas Instruments | C19653 |  | RECOMMENDATION - R18; OPEN UNTESTED |  | http[LOCAL_SOURCE] | 2
U4 | TPS62130ARGTR | FC_REV_A_Local:Package_DFN_QFN__VQFN-16-1EP_3x3mm_P0.5mm_EP1.68x1.68mm | TPS62130ARGTR | Texas Instruments | C337502 |  | RECOMMENDATION - R18; OPEN UNTESTED |  | http[LOCAL_SOURCE] | 1
U5 | TPS552892RYQR | FC_REV_A_Local:TI_RYQ0021_HotRod_5x3 | TPS552892RYQR | Texas Instruments | C19272254 |  | RECOMMENDATION - R18; OPEN UNTESTED |  | http[LOCAL_SOURCE] | 1
U6 | TPS25940LRVCR | FC_REV_A_Local:Package_DFN_QFN__Texas_RVC0020A_WQFN-20-1EP_3x4mm_P0.5mm_EP1.6x2.6mm | TPS25940LRVCR | Texas Instruments | C2867756 |  | RECOMMENDATION - R18; OPEN UNTESTED |  | http[LOCAL_SOURCE] | 1
U7 | TPS73633DBVR | FC_REV_A_Local:Package_TO_SOT_SMD__SOT-23-5 | TPS73633DBVR | Texas Instruments | C28038 |  | RECOMMENDATION - R18; OPEN UNTESTED |  | http[LOCAL_SOURCE] | 1
U8 | SN74HCS11DR | FC_REV_A_Local:Package_SO__SOIC-14_3.9x8.7mm_P1.27mm | SN74HCS11DR | Texas Instruments | C2869822 |  | RECOMMENDATION - R18; OPEN UNTESTED |  | http[LOCAL_SOURCE] | 1
U9,U10 | TPS3700DDCR | FC_REV_A_Local:Package_TO_SOT_SMD__SOT-23-6 | TPS3700DDCR | Texas Instruments | C33002 |  | RECOMMENDATION - R18; OPEN UNTESTED |  | http[LOCAL_SOURCE] | 2
U12 | ICM-42688-P | FC_REV_A_Local:TDK_ICM42688P_LGA14_3x2.5 | ICM-42688-P | TDK InvenSense |  |  | RECOMMENDATION - Stage06; OPEN UNTESTED |  | http[LOCAL_SOURCE] | 1
U13,U19 | SN74AXC4T774PWR | FC_REV_A_Local:Package_SO__TSSOP-16_4.4x5mm_P0.65mm | SN74AXC4T774PWR | Texas Instruments |  |  | RECOMMENDATION - Stage06; OPEN UNTESTED |  | http[LOCAL_SOURCE] | 2
U14 | SN74AUP3G17DCUR | FC_REV_A_Local:Package_SO__VSSOP-8_2.3x2mm_P0.5mm | SN74AUP3G17DCUR | Texas Instruments |  |  | RECOMMENDATION - Stage06; OPEN UNTESTED |  | http[LOCAL_SOURCE] | 1
U15 | TPS22918DBVR | FC_REV_A_Local:Package_TO_SOT_SMD__SOT-23-6 | TPS22918DBVR | Texas Instruments |  |  | RECOMMENDATION - Stage06; OPEN UNTESTED |  | http[LOCAL_SOURCE] | 1
U16 | BMP390 | FC_REV_A_Local:Bosch_BMP390_LGA10_2x2 | BMP390 | Bosch Sensortec |  |  | RECOMMENDATION - Stage06; OPEN UNTESTED |  | http[LOCAL_SOURCE] | 1
U17 | TCA9416DDFR | FC_REV_A_Local:TI_DDF0008_SOT23THIN_8 | TCA9416DDFR | Texas Instruments |  |  | RECOMMENDATION - Stage06; OPEN UNTESTED |  | http[LOCAL_SOURCE] | 1
U18 | SN74AXC1T45DBVR | FC_REV_A_Local:Package_TO_SOT_SMD__SOT-23-6 | SN74AXC1T45DBVR | Texas Instruments |  |  | RECOMMENDATION - Stage06; OPEN UNTESTED |  | http[LOCAL_SOURCE] | 1
U20,U22,U42,U54,U57 | TMUX1511PWR | FC_REV_A_Local:Package_SO__TSSOP-14_4.4x5mm_P0.65mm | TMUX1511PWR | Texas Instruments | C2866750 |  | RECOMMENDATION - Stage07; OPEN UNTESTED |  | http[LOCAL_SOURCE] | 5 | DNP
U21,U23,U26,U29,U32,U35,U43,U53,U58,U61,U62 | TPD4E05U06DQAR | FC_REV_A_Local:Package_SON__USON-10_2.5x1.0mm_P0.5mm | TPD4E05U06DQAR | Texas Instruments | C138714 |  | RECOMMENDATION - Stage07; OPEN UNTESTED |  | http[LOCAL_SOURCE] | 11 | DNP
U24,U27,U30,U33 | SN74LVC2G07DBVR | FC_REV_A_Local:Package_TO_SOT_SMD__SOT-23-6 | SN74LVC2G07DBVR | Texas Instruments | C37708 |  | RECOMMENDATION - Stage07; OPEN UNTESTED |  | http[LOCAL_SOURCE] | 4
U25,U28,U31,U34,U44,U55 | SN74LVC2G34DBVR | FC_REV_A_Local:Package_TO_SOT_SMD__SOT-23-6 | SN74LVC2G34DBVR | Texas Instruments | C347589 |  | RECOMMENDATION - Stage07; OPEN UNTESTED |  | http[LOCAL_SOURCE] | 6 | DNP
U36-U38,U45,U48,U51,U59 | LM66100DCKR | FC_REV_A_Local:Package_TO_SOT_SMD__SOT-363_SC-70-6 | LM66100DCKR | Texas Instruments | C2869734 |  | RECOMMENDATION - Stage07; OPEN UNTESTED |  | http[LOCAL_SOURCE] | 7 | DNP
U39-U41,U46,U49,U52,U56,U60 | TPD1E05U06DYAR | FC_REV_A_Local:TI_DYA0002_SOD523 | TPD1E05U06DYAR | Texas Instruments |  |  | RECOMMENDATION - Stage07; OPEN UNTESTED |  | http[LOCAL_SOURCE] | 8 | DNP
U47,U50 | TCAN332DCNR | FC_REV_A_Local:Package_TO_SOT_SMD__SOT-23-8 | TCAN332DCNR | Texas Instruments | C544741 |  | RECOMMENDATION - Stage07; OPEN UNTESTED |  | http[LOCAL_SOURCE] | 2 | DNP
Y1 | 8.000MHz | FC_REV_A_Local:Crystal__Crystal_SMD_Abracon_ABM3B-4Pin_5.0x3.2mm |  |  |  |  | RECOMMENDATION - crystal and calculated load capacitors require review | CL=18 pF; ESR<=200 Ohm; C0<=7 pF; drive<=100 uW; -20 to +70 C; tolerance +/-20 ppm; stability +/-50 ppm | http[LOCAL_SOURCE] | 1
Y2 | 32.768kHz DNP | FC_REV_A_Local:Crystal_SMD_1610-2Pin_1.6x1.0mm |  |  |  |  | DNP - MPN/load capacitance OPEN; PC14/PC15 reserved |  |  | 1 | DNP
