desanv01/Flight-Controller-V1/fabrication/jlcpcb/exports/board.step

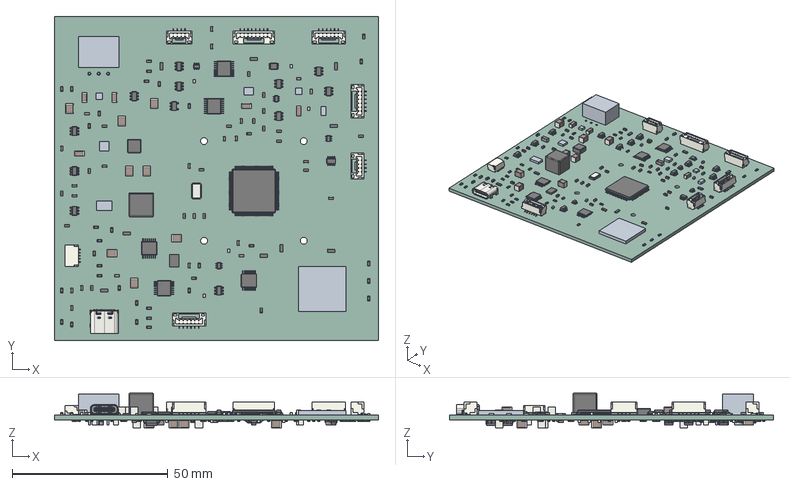
[picture p3: CAD file, 2026-10-14]
fabrication/jlcpcb/exports/board.step
104.0 x 104.0 x 11.2 mm
C_0603_1608Metric x 61
R_0603_1608Metric x 117
JST_BM06B_GHS_TBT x 3
VSSOP-8_2.3x2mm_P0.5mm
SOT-23-6 x 15
USON_10_25x10mm_Pitch05mm x 10
Crystal_SMD_Abracon_ABM3B-4Pin_5.0x3.2mm
C_1210_3225Metric x 16
C_1206_3216Metric x 13
SOT-363_SC-70-6 x 4
USB_C_Receptacle_16P_TopMnt_Horizontal_GCT_USB4105-xx-A
LQFP-100_14x14mm_P0.5mm
SOT-23-8
JST_SH_SM05B-SRSS-TB_1x05-1MP_P1.00mm_Horizontal
TSSOP-16_4.4x5mm_P0.65mm x 2
TSSOP-14_4.4x5mm_P0.65mm x 4
JST_BM08B_GHS_TBT
L_0603_1608Metric
JST_BM04B_GHS_TBT x 2
L_Coilcraft_XAL7070-XXX
Texas_RVC0020A_WQFN-20-1EP_3x4mm_P0.5mm_EP1.6x2.6mm
L_Coilcraft_XAL4020-XXX
SOT-23-5
SOIC-14_3.9x8.7mm_P1.27mm
FC_REV_A_PCB
