desanv01/Flight-Controller-V1/(list of files, cad)

Other CAD files:
fabrication/pcbway/exports/board.step
