desanv01/Flight-Controller-V1/fabrication/README.md

# Manufacturing data

Select [JLCPCB](jlcpcb/README.md) or [PCBWay](pcbway/README.md) as a coherent engineering package. Each includes exact public source, its source manifest, assembly files, fresh verification and export outputs. The original names were neutralized and descriptive metadata reconciled; new public hashes are authoritative for these downloads.

Both V1 vendor sources share the same final board geometry. Assembly part sourcing and stack selection remain outstanding.

No fabrication order is placed by this publication and physical qualification remains pending. Confirm supplier CAM/DFM, sourcing, rotations, dimensions and board quantities before manufacture. [Engineering downloads](https://github.com/desanv01/Flight-Controller-V1/releases/tag/v1-portfolio-publication).
