desanv01/Flight-Controller-V1/docs/manufacturing.md

# Manufacturing navigation

Use the [vendor-selection page](../fabrication/README.md) and its source-associated engineering downloads. Preserve source hashes and manifests with the files sent to a supplier. Never infer a package is current from the word FINAL alone.
