desanv01/Flight-Controller-V1/fabrication/jlcpcb/documents/CHANGE_MANIFEST.md

# FC FC_REV_A EVT1 change manifest

Status: **fabrication package completed after local prefab checks; assembly part selection and flight validation outstanding.**

<table class=""><tr><th>Area</th><th>EVT1 implementation</th></tr><tr><td>Floorplan</td><td>Rigid 1.60x scale of the Stage-09 arrangement; 65 x 65 mm to 104.05 x 104.05 mm. Component utilisation 95.3% -> 25.6% front.</td></tr><tr><td>Routing</td><td>Full re-route on six layers. 3974 track segments, 9134.5 mm, 531 through vias. Required open links 79 -> 0.</td></tr><tr><td>Stack</td><td>POWER and SIGNAL_2 exchanged so every signal layer is adjacent to a solid plane. Gerber .g3 is SIGNAL_2 and .g4 is POWER.</td></tr><tr><td>Layer names</td><td>Inner layers are GND, SIGNAL_1, SIGNAL_2, POWER - not the generic In1.Cu..In4.Cu.</td></tr><tr><td>Power delivery</td><td>GND and POWER are solid pours with zero signal tracks.</td></tr><tr><td>Via floor</td><td>min_via_diameter 0.45 -> 0.40 mm and min_through_hole_diameter 0.25 -> 0.20 mm. Seven vias use 0.40/0.20.</td></tr><tr><td>Section 4.5</td><td>72 copper items that had been routed onto nets whose pads are all do-not-populate were removed. 16 DNP-only islands are correctly left open.</td></tr><tr><td>Title block</td><td>Stamped revision A, dated, company set. The inherited schematic comment 'NOT FOR FABRICATION' was replaced.</td></tr><tr><td>Assembly data</td><td>BOM rebuilt from the PCB footprints, because the schematic symbols carry no MPN/LCSC fields.</td></tr></table>
