desanv01/Flight-Controller-V1/fabrication/jlcpcb/SHA256SUMS.csv

path | bytes | sha256
assembly/FC_REV_A-BOM-JLCPCB.csv | 5548 | b48f4202d0d21f3a595f05a9e6b1550d847db546a6cd7ab55838c92ffcb62cf0
assembly/FC_REV_A-BOM.csv | 25435 | cca19ad0d4fee0f988615aeab15c395e71a919a26cba8df1f69f95a4f0385e69
assembly/FC_REV_A-CPL-JLCPCB.csv | 18550 | 9cf3046384c46d54f4b64e86202ecd87468becf479a7af7c3f7a1101c99e081e
assembly/FC_REV_A-JLCPCB-TO-SELECT.csv | 2165 | b3476628996ee204a13ef32403977df0166828172b3b629f9a3f2b4d31d55ea4
assembly/reference/FC_REV_A-CPL-KiCad.csv | 23632 | 1129e720ecfcbdd76411e4f0523657e5e10cdd3950dbb111d5ad5dddbc058881
documents/CHANGE_MANIFEST.md | 1507 | 7b926f2e63dbd5ba5092f5093dd8db36cc46d72349ab49f916d78bf3bb0ae96e
documents/ESC_ADAPTER_CABLE.md | 4584 | 090aa915600ebfa86d010e9401da0f811ec939eb917ebd6349672cdc782d1939
documents/JLCPCB_IMPEDANCE_RECORD.md | 1489 | 8776e17e2b7932c827ce5ef3e9bba80c03003a35794040e530a78dd5e7bec33c
documents/JLCPCB_ORDER_SETTINGS.txt | 1634 | d9371e4cfb23137c4d6a514a0ea1b9932f276cf2157ba829caf9beb41752f398
documents/JLCPCB_UPLOAD_GUIDE.md | 13004 | e3124b7eb3f1ce81d9b1d66fbae94ae731815c97af2effbc65037d10374554ee
documents/MECHANICAL_RELEASE_NOTE.md | 1040 | 7a8a0d8338397d7f0b38f3ca6e289c8f59c16c186f0c6f20c0b71e97b5b25933
documents/PCBWAY_FALLBACK_NOTES.md | 748 | 0f8fca2e30e52dccd05f80340985ef3c1d3682ab129880990e504d59ef3502c9
exports/assembly.pdf | 312665 | 0f0866af76e08a7da6dc385ec6505d16dbb6ed1d5481b9f4a3c432b422a14669
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
source/hardware/libraries/FC_REV_A_Local.3dshapes/Connector_JST__JST_GH_BM06B-GHS-TBT_1x06-1MP_P1.25mm_Vertical.step | 404400 | 4b87523f1774db7043fc36653a9b4f34e35ab6821dfeec8b40f7d0056931b6b5
source/hardware/libraries/FC_REV_A_Local.3dshapes/Connector_JST__JST_GH_BM08B-GHS-TBT_1x08-1MP_P1.25mm_Vertical.step | 508924 | a7e6a89c3a8de9071102dbf65cb1a30536fd35925768a116de7c0cb76ae161e9
source/hardware/libraries/FC_REV_A_Local.3dshapes/Connector_USB__USB_C_Receptacle_GCT_USB4105-xx-A_16P_TopMnt_Horizontal.step | 1059856 | 6338ce740fa231c2d3dcc6384e0576994a47240a312a21413cb85d76990a69a0
source/hardware/libraries/FC_REV_A_Local.3dshapes/Crystal__Crystal_SMD_Abracon_ABM3B-4Pin_5.0x3.2mm.step | 102456 | 6ef4449fbb182987b6329eb0eead618ddedfb08a533d431f277596d9d4944e0b
source/hardware/libraries/FC_REV_A_Local.3dshapes/ESC_JST_SH_SM05B_SRSS_TB.step | 80559 | 4c29844e2d9b11ef1675df49f2721391945ba3764a3b04c72c2f20a5215c0e0c
source/hardware/libraries/FC_REV_A_Local.3dshapes/GCT_MEM2075_00_140_01_A_ENVELOPE.step | 15543 | 3875e22a6aaf0e8820f29c071ba07de64dc19dc1a2501ffdbed6e3ce439885bf
source/hardware/libraries/FC_REV_A_Local.3dshapes/Inductor_SMD__L_0603_1608Metric.step | 43450 | b0136ad7160588d2f5dac8c85da84a35646db656b5bc54bbb873b6b548eedbb3
source/hardware/libraries/FC_REV_A_Local.3dshapes/Inductor_SMD__L_Coilcraft_XAL4020-XXX.step | 32254 | ccccee60d1c700cb295b890024e8da4e4d7507b6b69039c751b6dcc3e91bd3ee
source/hardware/libraries/FC_REV_A_Local.3dshapes/Inductor_SMD__L_Coilcraft_XAL7070-XXX.step | 32143 | 5e7dc37afe061c360cdf2609f506edb1b16befaa5bfbcd9b75b26649c42d1df4
source/hardware/libraries/FC_REV_A_Local.3dshapes/LED_SMD__LED_0603_1608Metric.step | 77068 | 98343205ec260ec165026ba2d44329a23096779ac36c553ea84aa7b370242e6d
source/hardware/libraries/FC_REV_A_Local.3dshapes/Package_DFN_QFN__Texas_RVC0020A_WQFN-20-1EP_3x4mm_P0.5mm_EP1.6x2.6mm.step | 52822 | f257536c2c62c3b774a8d2e72792a5e607e79f19c56edb5e8211258bed260d6c
source/hardware/libraries/FC_REV_A_Local.3dshapes/Package_QFP__LQFP-100_14x14mm_P0.5mm.step | 1335919 | 51720097260ffba41c3062f85f67623721102fa535901c47cb555a1f444feeb3
source/hardware/libraries/FC_REV_A_Local.3dshapes/Package_SO__SOIC-14_3.9x8.7mm_P1.27mm.step | 199321 | 3b9a775da256c8afcc28dcddfbc2eb3f266107fe61ce8446d96f2c52b6f44a70
source/hardware/libraries/FC_REV_A_Local.3dshapes/Package_SO__TSSOP-14_4.4x5mm_P0.65mm.step | 198789 | 3ee5786aae56190997aa793ba3cfc003fd616782770e29719b4562f012982245
source/hardware/libraries/FC_REV_A_Local.3dshapes/Package_SO__TSSOP-16_4.4x5mm_P0.65mm.step | 210031 | 6ad5e98224d02a427d9a6b929a28dbc158b9925fba5adec12db05079f1016948
source/hardware/libraries/FC_REV_A_Local.3dshapes/Package_SO__VSSOP-8_2.3x2mm_P0.5mm.step | 124982 | 353552981eef35cb93635057d4aeb89aef22648c77af6fd095e328bfe6b834bd
source/hardware/libraries/FC_REV_A_Local.3dshapes/Package_SON__USON-10_2.5x1.0mm_P0.5mm.step | 112123 | d9d0628ead2ac2bab888344afbd0ef8b0f5a4ba37641ccc66dcbe300e3a74ac0
source/hardware/libraries/FC_REV_A_Local.3dshapes/Package_TO_SOT_SMD__SOT-23-5.step | 87532 | 720a6eab0024069bbee68e7cb4c3ff1149468a34611225cdc852662c5d0ec2b7
source/hardware/libraries/FC_REV_A_Local.3dshapes/Package_TO_SOT_SMD__SOT-23-6.step | 99639 | c9fe686b4d1b56927a41fa84a9bc1efb61d8a45a123a3db43bcaa05c2891d635
source/hardware/libraries/FC_REV_A_Local.3dshapes/Package_TO_SOT_SMD__SOT-23-8.step | 125704 | b9dc5b435d49868df7491668d5322debfe5d699dbb41c2ad93a41518ec9b5007
source/hardware/libraries/FC_REV_A_Local.3dshapes/Package_TO_SOT_SMD__SOT-363_SC-70-6.step | 101545 | 045cc95e18ee7a13d1623c3ce6604fc833049bdb4f952f68c26e3c5767d122e4
source/hardware/libraries/FC_REV_A_Local.3dshapes/POWER1_Molex_43045_0600_4Electrical_2NPTH.step | 112672 | 7d1da332a32f75ab1edbfa244d0c98cb391409f39de2c6db2fdfb0008169fd59
source/hardware/libraries/FC_REV_A_Local.3dshapes/Resistor_SMD__R_0603_1608Metric.step | 40618 | 1875571c326d0d9e96f36b4efeb8094068ef7619f0a449c781caf0b49c2e5861
source/hardware/libraries/FC_REV_A_Local.3dshapes/Resistor_SMD__R_2010_5025Metric.step | 40345 | 6f990878f55f2458c0263e55075c72360fd33db78dbf5aa5c5ba731c9bca560b
source/hardware/libraries/FC_REV_A_Local.3dshapes/TDK_ICM42688P_LGA14_3x2.5_ENVELOPE.step | 15505 | 2fa1fc010da23bf7cdd428c71bd069473247f4c6a03876595cb2f5ac9c47843d
source/hardware/libraries/FC_REV_A_Local.3dshapes/TI_DDF0008_SOT23THIN_8_ENVELOPE.step | 15496 | ed2b08183e877b0336cd2726da1e40193fcf18d3c65231ec6fc9222018398975
source/hardware/libraries/FC_REV_A_Local.3dshapes/TI_DYA0002_SOD523_ENVELOPE.step | 15483 | 2a096f945444a7b1b0d836dc44fe9cf6f5c37e73b39c5c6faac0f2050d58b146
source/hardware/libraries/FC_REV_A_Local.3dshapes/TI_RGT0016_3x3_ENVELOPE.step | 15449 | f429e773585556a09b5da8de5acb20a373390ef3facf5579dc8ded3ed22d58a2
source/hardware/libraries/FC_REV_A_Local.3dshapes/TI_RPW0010_HotRod_2x2_ENVELOPE.step | 15397 | 2fc7031eda10b527cf4439ba5ec65130599c17911dd3735be9afd798a91cf336
source/hardware/libraries/FC_REV_A_Local.3dshapes/TI_RYQ0021_HotRod_5x3_ENVELOPE.step | 15449 | 09e23facb5c5fe3f66c036304bace1eedf2a7ecd6677046034149bdd89e3d92a
source/hardware/libraries/FC_REV_A_Local.kicad_sym | 136005 | d2cf9d264a9feb385385a7f3c977451cea8e1f06ffd565f541b6f2f6b2f43f6f
source/hardware/libraries/FC_REV_A_Local.pretty/Bosch_BMP390_LGA10_2x2.kicad_mod | 2123 | a47494b9c135c3fde7788800b05d02844b7a00f416f099db626aa2613e84481b
source/hardware/libraries/FC_REV_A_Local.pretty/Capacitor_SMD__C_0603_1608Metric.kicad_mod | 1958 | f663e82ee466c7a977578dad71e3d34062784fca0d08b2b3f28fb2d420c6a573
source/hardware/libraries/FC_REV_A_Local.pretty/Capacitor_SMD__C_1206_3216Metric.kicad_mod | 1968 | e2e68d1ada87aadfd13c9e646af02ad5ef567e2e188fd0833631810f3d4a95fb
source/hardware/libraries/FC_REV_A_Local.pretty/Capacitor_SMD__C_1210_3225Metric.kicad_mod | 1966 | 2582eab4e22271b5d7afbf5f9115d281cf62116c2dab1f8082b42c901424161d
source/hardware/libraries/FC_REV_A_Local.pretty/Connector_JST__JST_GH_BM02B-GHS-TBT_1x02-1MP_P1.25mm_Vertical.kicad_mod | 5248 | e1031512dfec7d2490158d8e7b183bbf6398c1ad801fb58da4060907b10231c8
source/hardware/libraries/FC_REV_A_Local.pretty/Connector_JST__JST_GH_BM04B-GHS-TBT_1x04-1MP_P1.25mm_Vertical.kicad_mod | 5751 | a4de9162911d36483e3abcaafed448b21b46b29b5b5674ca7560eb7e9c471cfe
source/hardware/libraries/FC_REV_A_Local.pretty/Connector_JST__JST_GH_BM06B-GHS-TBT_1x06-1MP_P1.25mm_Vertical.kicad_mod | 6254 | e3cf33e48b085e80ec4bf75461a272406daf8eb1fe3d09403f3d758231afe7c4
source/hardware/libraries/FC_REV_A_Local.pretty/Connector_JST__JST_GH_BM08B-GHS-TBT_1x08-1MP_P1.25mm_Vertical.kicad_mod | 6757 | c214c78ff3100c56bdb3a6c1a5c86a30064b02d67227560be4b1e7eeb25069f8
source/hardware/libraries/FC_REV_A_Local.pretty/Crystal__Crystal_SMD_Abracon_ABM3B-4Pin_5.0x3.2mm.kicad_mod | 2786 | cb6af2e5e51a52fc9b5298a5634e9722abff0975fbf698313104eac421778f10
source/hardware/libraries/FC_REV_A_Local.pretty/Crystal_SMD_1610-2Pin_1.6x1.0mm.kicad_mod | 2347 | 770b7f6fd8a9e71ef4c2a41e218ff5007963280eed20abe5f7d6ab9a11d6f709
source/hardware/libraries/FC_REV_A_Local.pretty/ESC_JST_SH_SM05B_SRSS_TB.kicad_mod | 7480 | a64614b512551c24e4f4a345783e81b0f2e772192f946654c025c9a40cd684cf
source/hardware/libraries/FC_REV_A_Local.pretty/GCT_MEM2075_00_140_01_A.kicad_mod | 2670 | 526541d89c5ef99143159167a48a2c89e3a7f0912d38eaaadfbef052858f5cb8
source/hardware/libraries/FC_REV_A_Local.pretty/GCT_USB4105_GF_A_095_S1_S4.kicad_mod | 6846 | a3ba7837901da9b3afd16bebc872581def6868b629dc9801d9603eac6555293a
source/hardware/libraries/FC_REV_A_Local.pretty/Inductor_SMD__L_0603_1608Metric.kicad_mod | 1925 | 852842112bfc4c569a814dec5825d6209f128790395e2575eefdedfc5283adfd
source/hardware/libraries/FC_REV_A_Local.pretty/Inductor_SMD__L_Coilcraft_XAL4020-XXX.kicad_mod | 2097 | a3493e3d018b7afee3d565b2d7c5b334076565b2224bc5d1765b6139587acc7c
source/hardware/libraries/FC_REV_A_Local.pretty/Inductor_SMD__L_Coilcraft_XAL7070-XXX.kicad_mod | 2101 | 00d2990127fba7444d914c2ce8d824dee66fbdc03cb252e6042f3e148dc19301
source/hardware/libraries/FC_REV_A_Local.pretty/LED_SMD__LED_0603_1608Metric.kicad_mod | 2461 | f55251c3343d031ac4e82f1133e27d23b92c7ed40082e8c4e02c6f7bcf848e0f
source/hardware/libraries/FC_REV_A_Local.pretty/Package_DFN_QFN__Texas_RVC0020A_WQFN-20-1EP_3x4mm_P0.5mm_EP1.6x2.6mm.kicad_mod | 10714 | 6f4daa0fe397104db21f1d655cef495d86ede386f27affedcfe277b04d3aa10f
source/hardware/libraries/FC_REV_A_Local.pretty/Package_DFN_QFN__VQFN-16-1EP_3x3mm_P0.5mm_EP1.68x1.68mm.kicad_mod | 10405 | 629ff5a8feceaa30dae1e5b084c14c383bef5e8675041f5ef63bbc9f5bb3eb09
source/hardware/libraries/FC_REV_A_Local.pretty/Package_QFP__LQFP-100_14x14mm_P0.5mm.kicad_mod | 17184 | 6cb5563707083007888d9917c0c3ac6ce74e664faeae10b9bcf4ca20e0dcda76
source/hardware/libraries/FC_REV_A_Local.pretty/Package_SO__SOIC-14_3.9x8.7mm_P1.27mm.kicad_mod | 5383 | c2e21284c96fcd991da88ed8055667880694f2c7cce2ed1f292540582069ffab
source/hardware/libraries/FC_REV_A_Local.pretty/Package_SO__TSSOP-14_4.4x5mm_P0.65mm.kicad_mod | 5407 | ac2b16270a65b026db112b6b5c745610c7d7eb2190ad7b83cfab4319eae69bc0
source/hardware/libraries/FC_REV_A_Local.pretty/Package_SO__TSSOP-16_4.4x5mm_P0.65mm.kicad_mod | 5295 | 857d37f3c5d93d6c1f0f5132cc68fd7802c97acad452ce4211accf721c2e8a4d
source/hardware/libraries/FC_REV_A_Local.pretty/Package_SO__VSSOP-8_2.3x2mm_P0.5mm.kicad_mod | 4106 | b066540b537231e86fa5d7091dc4dba61637d07030a8e4eaebb223af4ffffb86
source/hardware/libraries/FC_REV_A_Local.pretty/Package_SON__USON-10_2.5x1.0mm_P0.5mm.kicad_mod | 5311 | 64711fe778f4725dd0651f19c40d5313a211f08ac059e652cb8254ac891ccad8
source/hardware/libraries/FC_REV_A_Local.pretty/Package_TO_SOT_SMD__SOT-23-5.kicad_mod | 4780 | 140c604de358e0a1f81f52c90235b8080e69571a314cb861f5c3c2443eb66bb8
source/hardware/libraries/FC_REV_A_Local.pretty/Package_TO_SOT_SMD__SOT-23-6.kicad_mod | 4315 | 5d7d8e858f59bc89f2c32a7e12d031af4d9d84a15b9d224c0aeb411db57aced6
source/hardware/libraries/FC_REV_A_Local.pretty/Package_TO_SOT_SMD__SOT-23-8.kicad_mod | 4608 | 0987de8e4d8b3293f344d7f22b41f9dac6e8c984e6144227f30f6f77d181a7e5
source/hardware/libraries/FC_REV_A_Local.pretty/Package_TO_SOT_SMD__SOT-363_SC-70-6.kicad_mod | 4485 | 330f6bd82862c23d1afc1d5a3e73a4c72d84d6c9a123dc6a1682e9e809a72207
source/hardware/libraries/FC_REV_A_Local.pretty/POWER1_Molex_43045_0600_4Electrical_2NPTH.kicad_mod | 6602 | 897b72c1f3abff465983ec6e63c68a7d9629605045ce101535406c48923dc172
source/hardware/libraries/FC_REV_A_Local.pretty/Resistor_SMD__R_0603_1608Metric.kicad_mod | 1972 | 569b41843bd592c834078c3319df87b487ea8d332237d2e4f80878acf02ce537
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
verification/publication-corrections.json | 247 | 276ae7b1c06b9d0c70c67fcf61435797cc1e8f92a915473a5ae739c494482498
verification/summary.json | 3673 | 9bd62052ec99757b0b0d4136350dde8f2440fa31efc3f9e5a403b0d8d0b0ceca
