desanv01/Flight-Controller-V1/verification/README.md

# Verification evidence

`latest` contains fresh KiCad reports and exact-source correction/geometry assertions. Historical records are in the development/archive material and are not silently promoted to current results. Vendor source checks are in their corresponding fabrication directories. See docs/validation-status.md.
