desanv01/Flight-Controller-V1/CHANGELOG.md

# Changelog

## 14 October 2026 â€” public engineering archive

- Imported documented stages with actual publication-date commits and historical-date timeline.
- Recovered source snapshots and indexed unique CAD experiments/scripts.
- Applied neutral identity to public source, paths, documentation and derived assets.
- Reconciled schematic/PCB descriptive metadata with geometry assertions.
- Repeated native source checks with warnings, ignored-check settings and DNP exceptions visible.
- Prepared coherent vendor packages and portfolio documentation.
- Physical qualification remains pending; fabrication was external.

See the [development timeline](docs/development/timeline.md) for original engineering milestones and source tags.

## 14 October 2026 — publication naming correction

Removed former reference-project identifiers from public documents, historical source paths and records, target comments and downloadable archives. Historical milestone chronology is retained; imported Git objects and one baseline tag were renamed. Updated source-associated PDF/hash manifests without changing current electrical geometry or built FCV2 firmware behavior.
