desanv01/Flight-Controller-V1/docs/exports/assembly.pdf

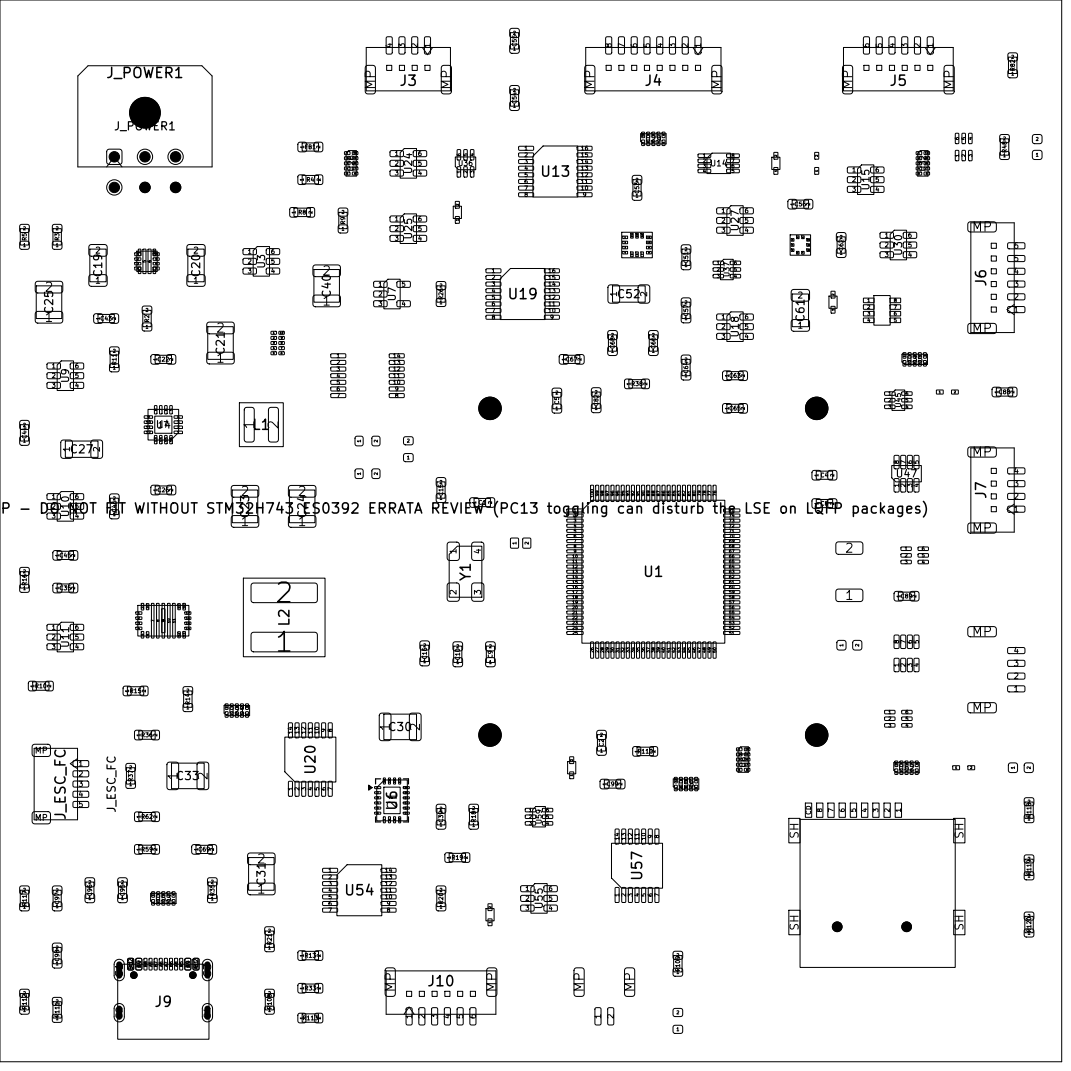
[picture p4: page 1]

Y2 LSE DNP - DO NOT FIT WITHOUT STM32H743 ES0392 ERRATA REVIEW (PC13 toggling can disturb the LSE on LQFP packages)

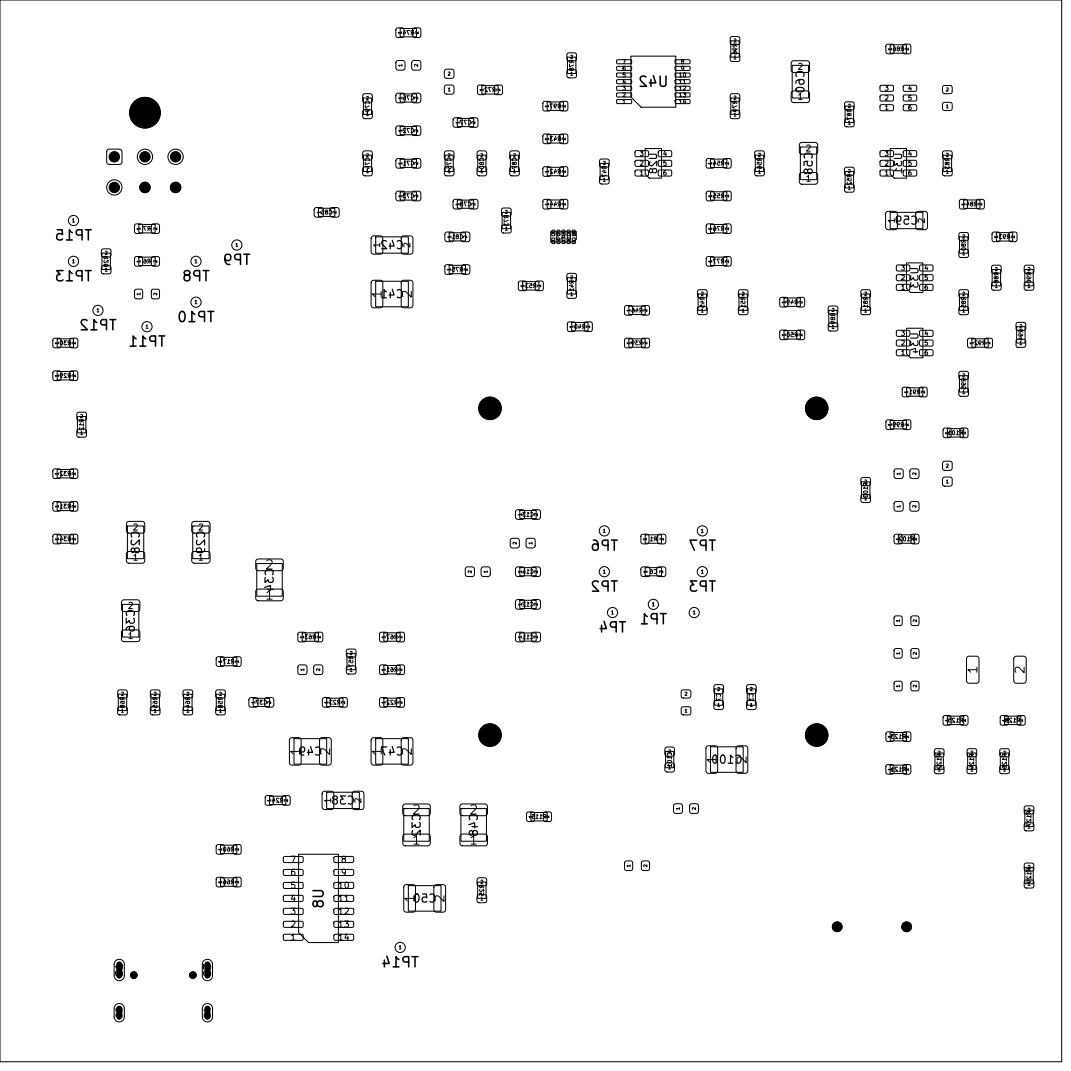
[picture p5: page 2]
