desanv01/Flight-Controller-V1/docs/exports/schematic.pdf

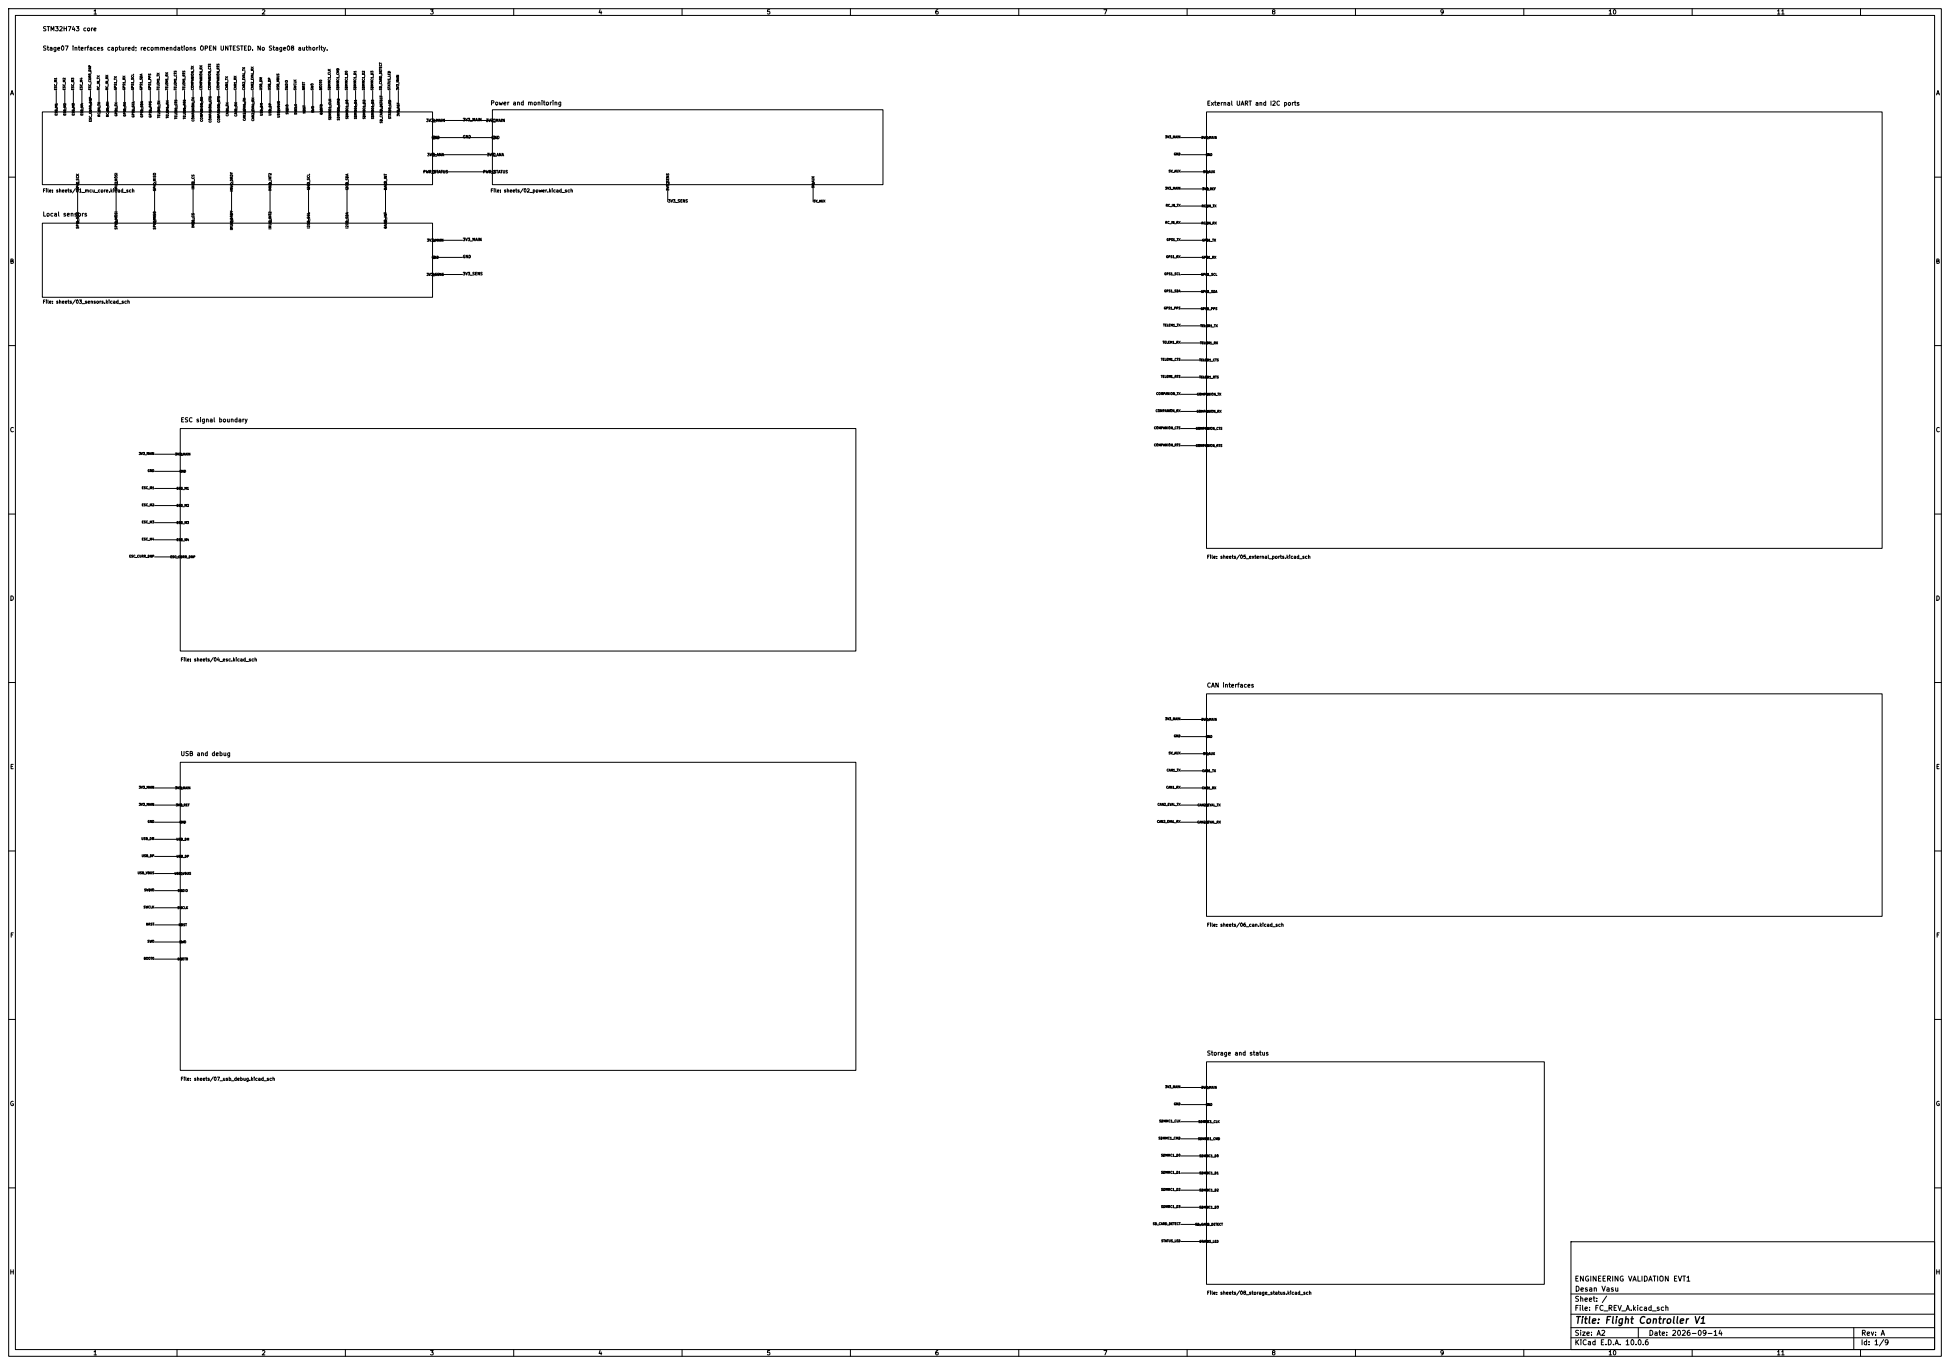
[picture p6: page 1]

GND Stage07 interfaces captured; recommendations OPEN UNTESTED. No Stage08 authority.

External UART and I2C ports

Size: A2 | Rev: A
KiCad E.D.A. 10.0.6 | Id: 1/9

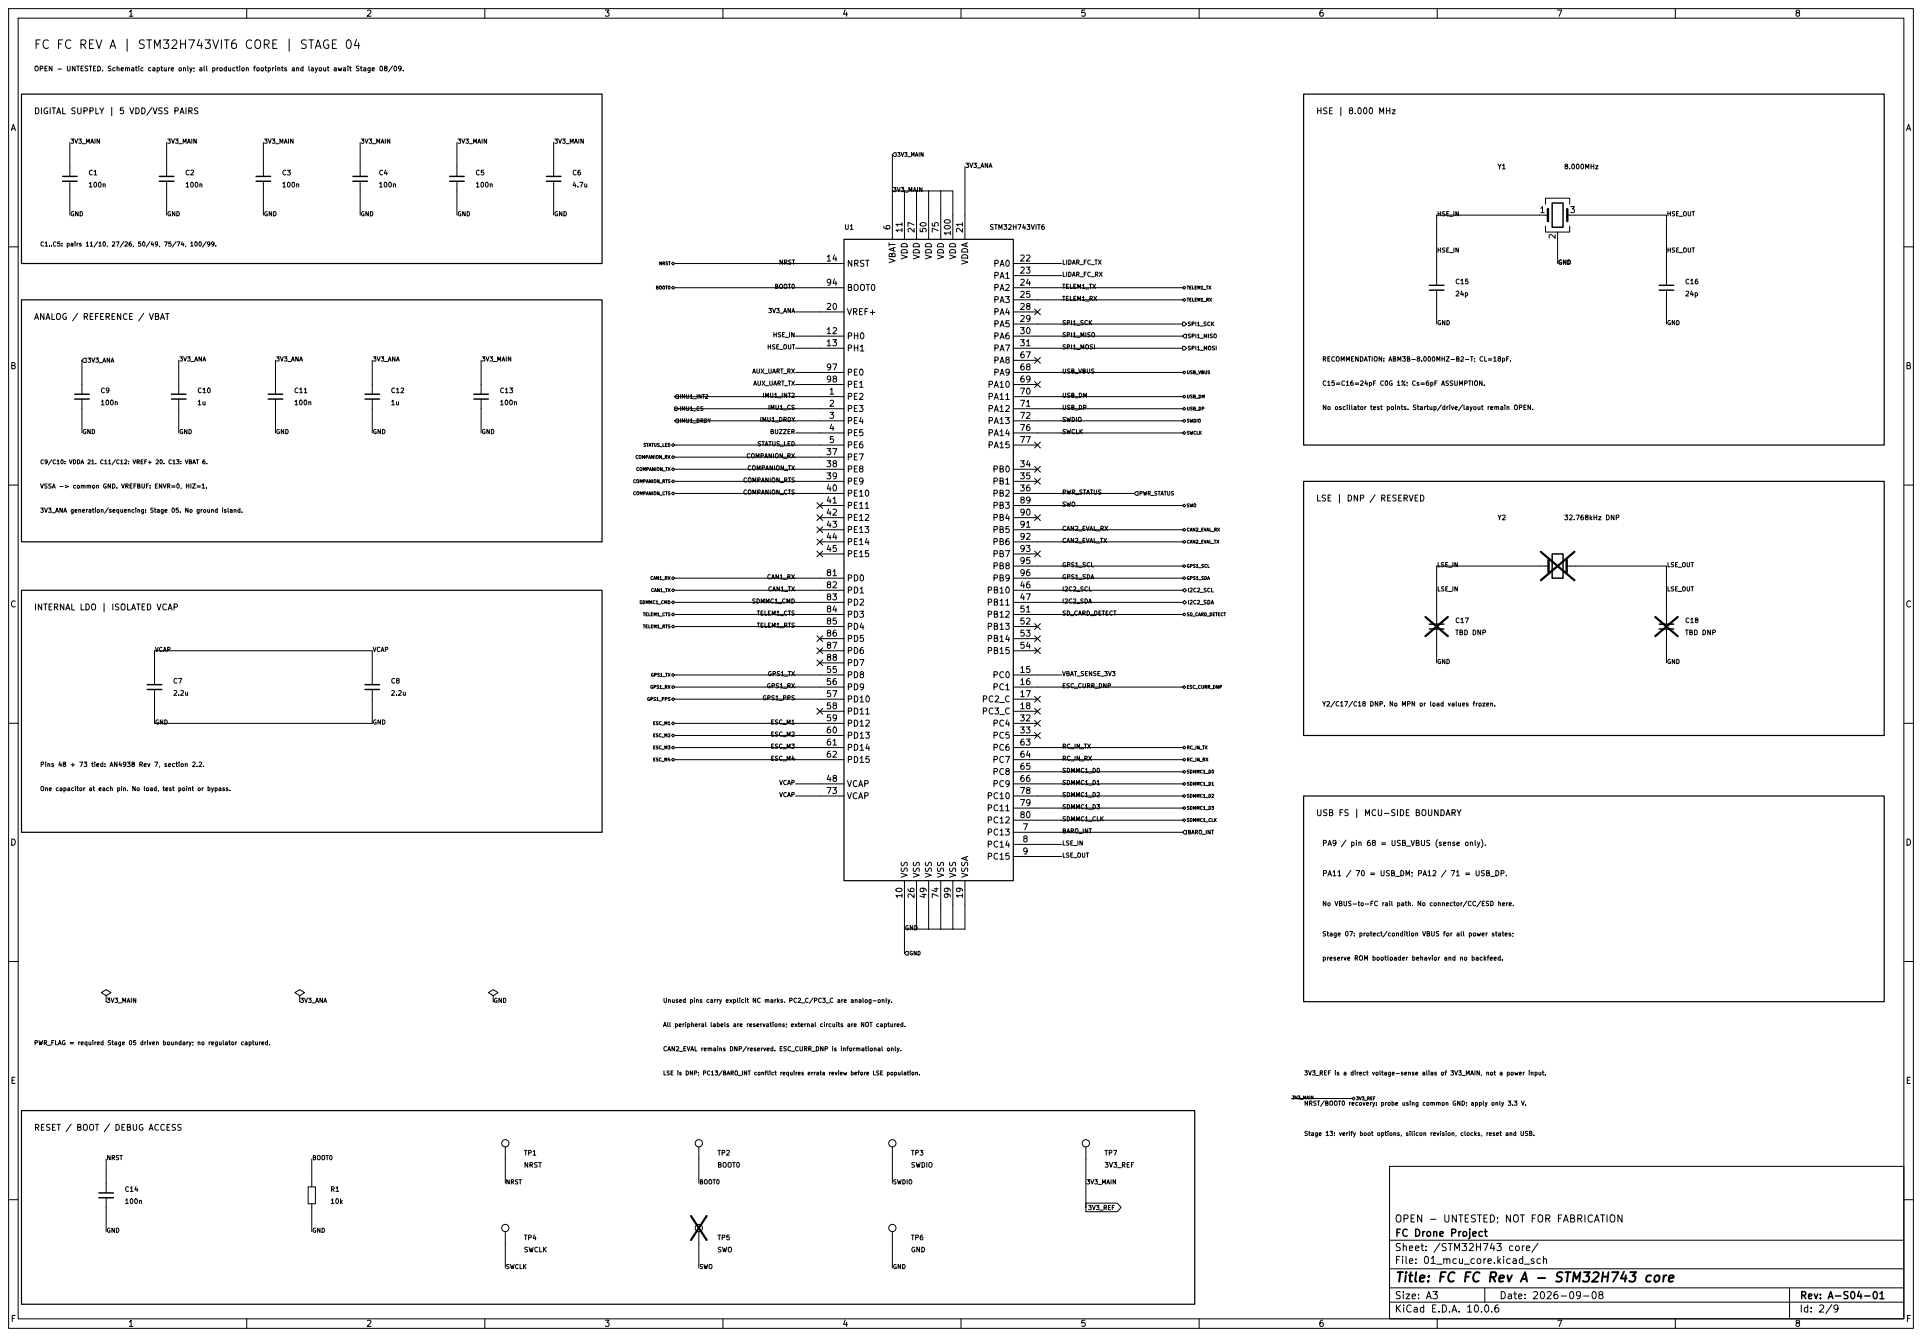
[picture p7: page 2]

HSE_IN No oscillator test points. Startup/drive/layout remain OPEN. LSE | DNP / RESERVED FC FC REV A | STM32H743VIT6 CORE | STAGE 04

OPEN - UNTESTED. Schematic capture only; all production footprints and layout await Stage 08/09.

DIGITAL SUPPLY | 5 VDD/VSS PAIRS

3V3_ANA generation/sequencing: Stage 05. No ground island. VSSA -> common GND. VREFBUF: ENVR=0, HIZ=1. C9/C10: VDDA 21. C11/C12: VREF+ 20. C13: VBAT 6.

preserve ROM bootloader behavior and no backfeed. Pins 48 + 73 tied: AN4938 Rev 7, section 2.2. INTERNAL LDO | ISOLATED VCAP

Y2/C17/C18 DNP. No MPN or load values frozen. USB FS | MCU-SIDE BOUNDARY PA9 / pin 68 = USB_VBUS (sense only). PA11 / 70 = USB_DM; PA12 / 71 = USB_DP.

PWR_FLAG = required Stage 05 driven boundary; no regulator captured. One capacitor at each pin. No load, test point or bypass.

No VBUS-to-FC rail path. No connector/CC/ESD here. NRST/BOOT0 recovery: probe using common GND; apply only 3.3 V.

Stage 07: protect/condition VBUS for all power states; All peripheral labels are reservations; external circuits are NOT captured.

Unused pins carry explicit NC marks. PC2_C/PC3_C are analog-only.

RESET / BOOT / DEBUG ACCESS

Stage 13: verify boot options, silicon revision, clocks, reset and USB.

OPEN - UNTESTED; NOT FOR FABRICATION
FC Drone Project
Sheet: /STM32H743 core/
File: 01_mcu_core.kicad_sch
Title: FC FC Rev A - STM32H743 core

Size: A3 | Rev: A-S04-01 | F Date: 2026-09-08

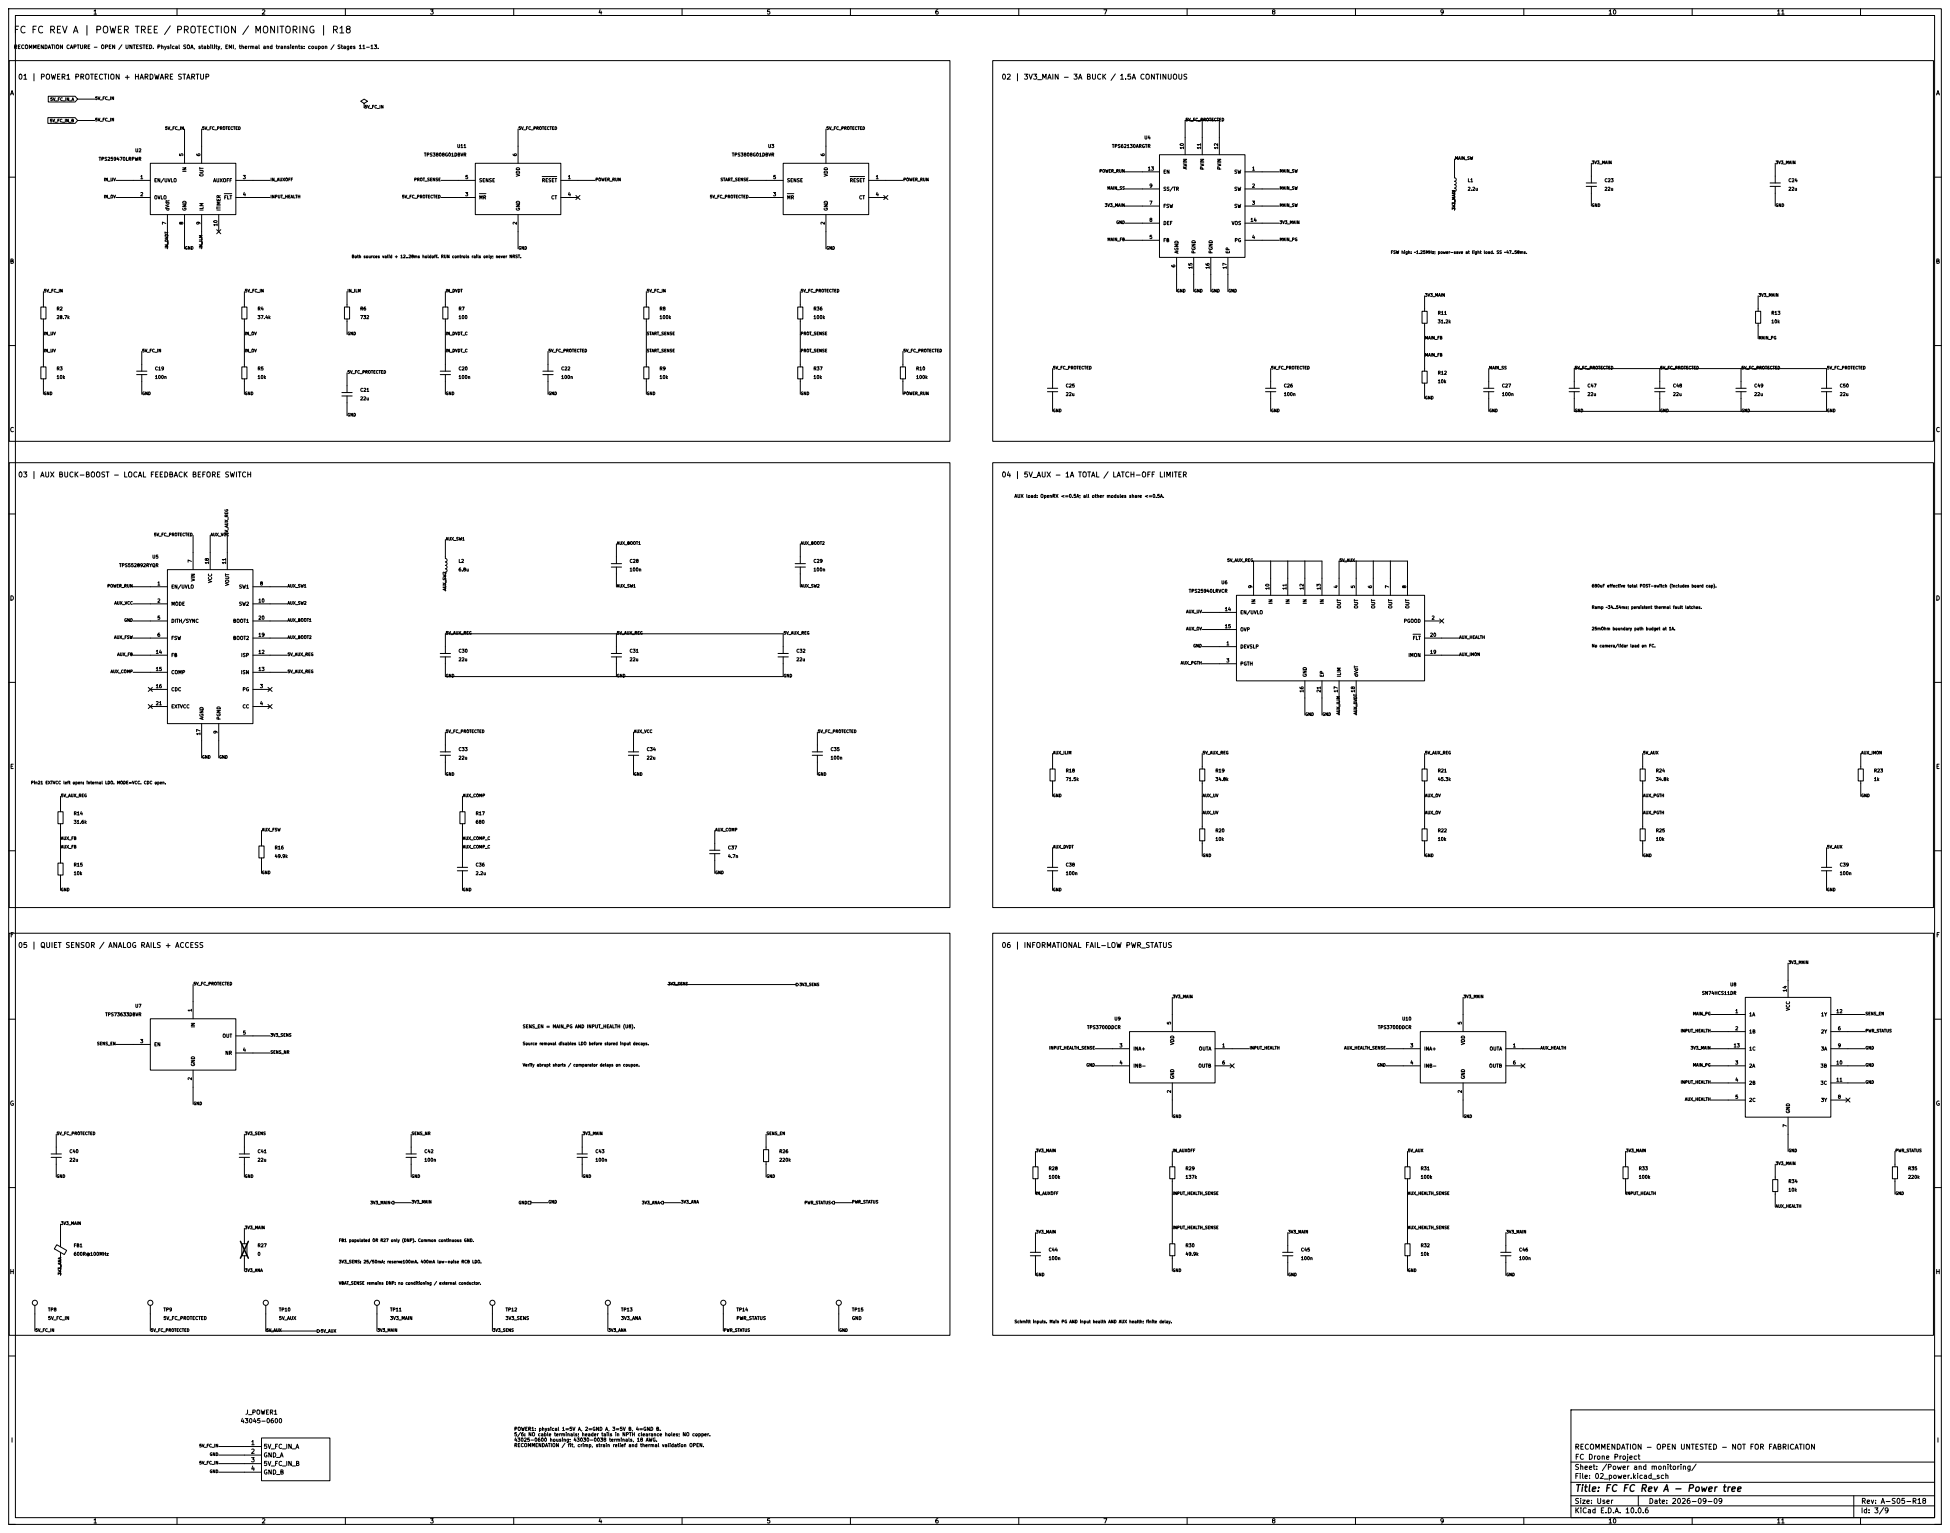
[picture p8: page 3]

FC FC REV A | POWER TREE / PROTECTION / MONITORING | R18

RECOMMENDATION CAPTURE - OPEN / UNTESTED. Physical SOA, stability, EMI, thermal and transients: coupon / Stages 11-13.

FSW high: ~1.25MHz; power-save at light load. SS ~47..58ms. 03 | AUX BUCK-BOOST - LOCAL FEEDBACK BEFORE SWITCH

Both sources valid + 12..28ms holdoff. RUN controls rails only; never NRST.

04 | 5V_AUX - 1A TOTAL / LATCH-OFF LIMITER

Pin21 EXTVCC left open: internal LDO. MODE=VCC. CDC open.

FGH
05 | QUIET SENSOR / ANALOG RAILS + ACCESS

VBAT_SENSE remains DNP: no conditioning / external conductor.

POWER1: physical 1=5V A, 2=GND A, 3=5V B, 4=GND B. 5/6: NO cable terminals; header tails in NPTH clearance holes; NO copper. 43025-0600 housing; 43030-0038 terminals, 18 AWG. RECOMMENDATION / fit, crimp, strain relief and thermal validation OPEN.

RECOMMENDATION - OPEN UNTESTED - NOT FOR FABRICATION
FC Drone Project

Sheet: /Power and monitoring/
File: 02_power.kicad_sch
Title: FC FC Rev A - Power tree

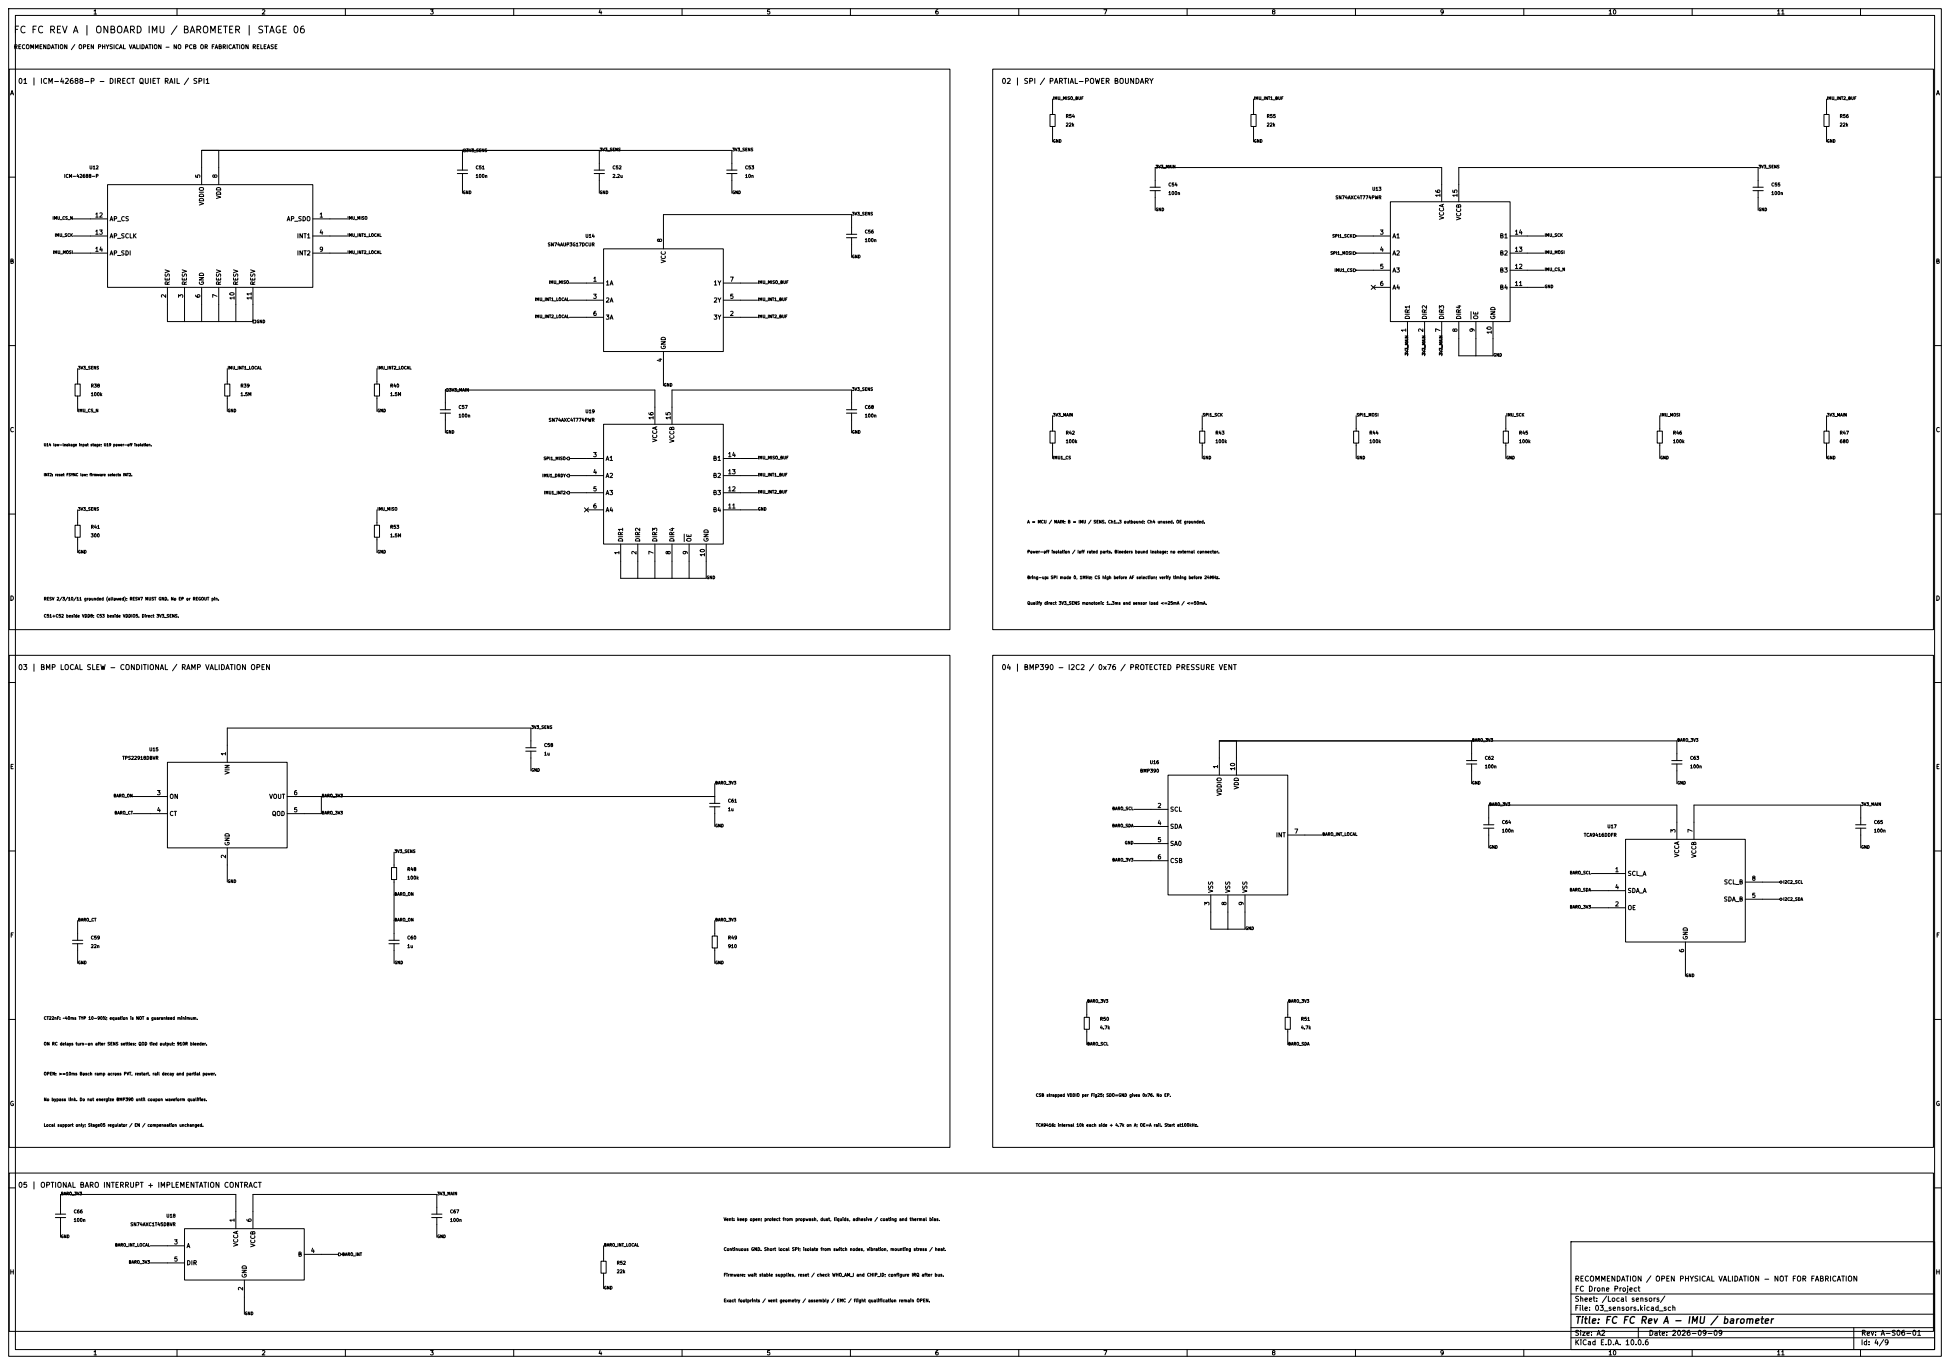
[picture p9: page 4]

FC FC REV A | ONBOARD IMU / BAROMETER | STAGE 06

RECOMMENDATION / OPEN PHYSICAL VALIDATION - NO PCB OR FABRICATION RELEASE 01 | ICM-42688-P - DIRECT QUIET RAIL / SPI1

02 | SPI / PARTIAL-POWER BOUNDARY

8 OE 9 GND 10 B4 11 B3 12 B2 13 B1 14 VCCB 15 VCCA 16U19

U14 low-leakage input stage; U19 power-off isolation.

INT2: reset FSYNC low; firmware selects INT2.

03 | BMP LOCAL SLEW - CONDITIONAL / RAMP VALIDATION OPEN

CSB strapped VDDIO per Fig25; SDO=GND gives 0x76. No EP.

TCA9416: internal 10k each side + 4.7k on A; OE=A rail. Start at100kHz.

05 | OPTIONAL BARO INTERRUPT + IMPLEMENTATION CONTRACT

Vent: keep open; protect from propwash, dust, liquids, adhesive / coating and thermal bias. Continuous GND. Short local SPI; isolate from switch nodes, vibration, mounting stress / heat. Firmware: wait stable supplies, reset / check WHO_AM_I and CHIP_ID; configure IRQ after bus.

RECOMMENDATION / OPEN PHYSICAL VALIDATION - NOT FOR FABRICATION

Sheet: /Local sensors/
File: 03_sensors.kicad_sch
Title: FC FC Rev A - IMU / barometer

AB

C

D

AB

C

D

R60
47k R61
0 | GND
2 | M1
5 | M2
6 | M3
7 | M4

8

J1

ESC BENCH: positions 1/4 ABSENT R62

# 47k SEL1

C69

100n | R57
47k R59

47k

# J2CURR contact J1-3: DNPSEL1

1

S1 2 | D1 | 3 SEL2

4

S2 5 | D2 | 6 GND

7 D3 8

S3 9 | SEL3 10 | D4 | 11 S4 12 | SEL4 13 | VDD 14

U20

TMUX1511PWR

R58

0 | R67
0R68

47k R63
47k R64

0R65

47k | R66
| 47k

D1+

1 | D1-
2 | GND

3 D2+

4 D2-

5 NC

6 NC

7 GND

8 NC

9 NC

10

U21

TPD4E05U06DQAR | GND
1 | M1
2 | M2
3 | M3
4 | M4
5

## J_ESC_FC SM05B-SRSS-TB

# ESC_M1_PORT ESC_M1_PORT

ESC_M1_PORT 3V3_MAIN

ESC_M2_ISO

GND

ESC_M2 | GND

ESC_M4

GND

GND

ESC_M1

ESC_M2_PORT

GND

GND

GND

GND

ESC_M1_ISO

ESC_M2_PORT

GND

ESC_M1

# ESC_M3 GND

ESC_M2

ESC_M3_ISO

ESC_M3_PORT 3V3_MAIN

GND

ESC_M3_PORT ESC_M3 | GND

ESC_M4

ESC_M4_ISO

ESC_M4_PORT ESC_M4_PORT | ESC_M2_PORT ESC_M1_ISO | ESC_M3_PORT ESC_M4_PORT ESC_M3_ISO

GND

ESC_M1_PORT ESC_M2_PORT ESC_M3_PORT ESC_M4_PORT ESC_M2_ISO

ESC_M1_PORT ESC_M2_PORT ESC_M3_PORT ESC_M4_PORT

ESC_M4_ISO

GND

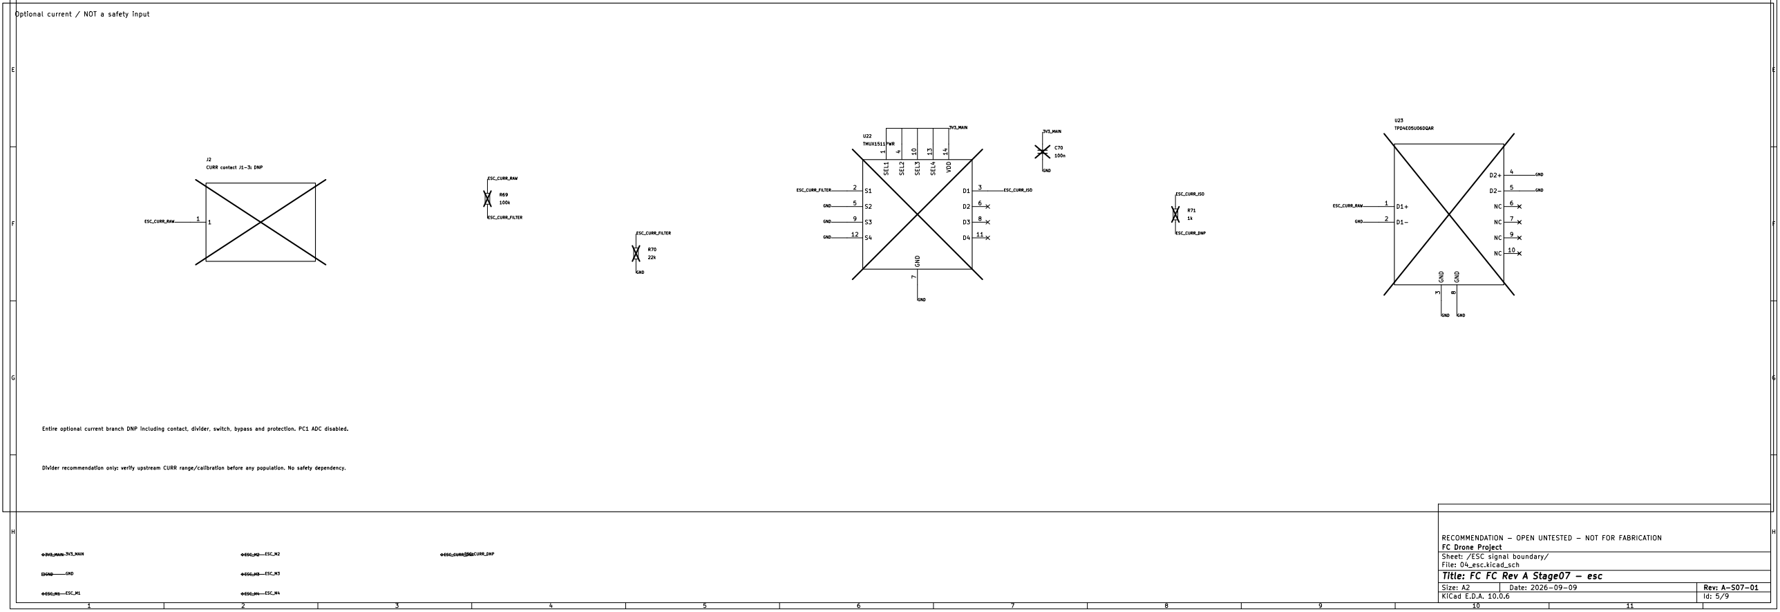
[picture p10: figure]
FGH; FGH Date: 2026-09-09; Size: A2; Rev: A-S07-01; Title: FC FC Rev A Stage07 - esc; File: 04_esc.kicad_sch; Sheet: /ESC signal boundary/; 3 SEL2; 6 GND; SEL3 10; SEL4 13; VDD 14; TMUX1511PWR; GND; 7 GND; TPD4E05U06DQAR; ESC_CURR_DNP; ESC_M4; 3V3_MAIN; ESC_M3; ESC_M2; ESC_M1; ESC_CURR_RAW; ESC_CURR_FILTER; ESC_CURR_ISO

Entire optional current branch DNP including contact, divider, switch, bypass and protection. PC1 ADC disabled.

# ESC: sparse bench boundary - Stage07 recommendation / OPEN UNTESTED

Physical FC connector: 1=GND, 2=M1, 3=M2, 4=M3, 5=M4. Sparse logical J1 retained; J2 current-sense remains DNP / footprintless. NO ESC battery, power or current-sense conductor on this harness. RECOMMENDATION / unpowered continuity and powered bench validation OPEN. 0R series default; evaluate 22R only after bidirectional waveform test. Both sides 47k low. ESC firmware FT pulls OFF. J1 has ONLY 2,5,6,7,8. No 1/4 pins, pads, wires or nets. Controlled interposer <=150mm; flight harness OPEN. Optional current / NOT a safety input

## Motor signals / bidirectional DShot

Divider recommendation only: verify upstream CURR range/calibration before any population. No safety dependency.

3.3V logic. No external 5V direct to MCU. No PCB / footprint release / fabrication authority.

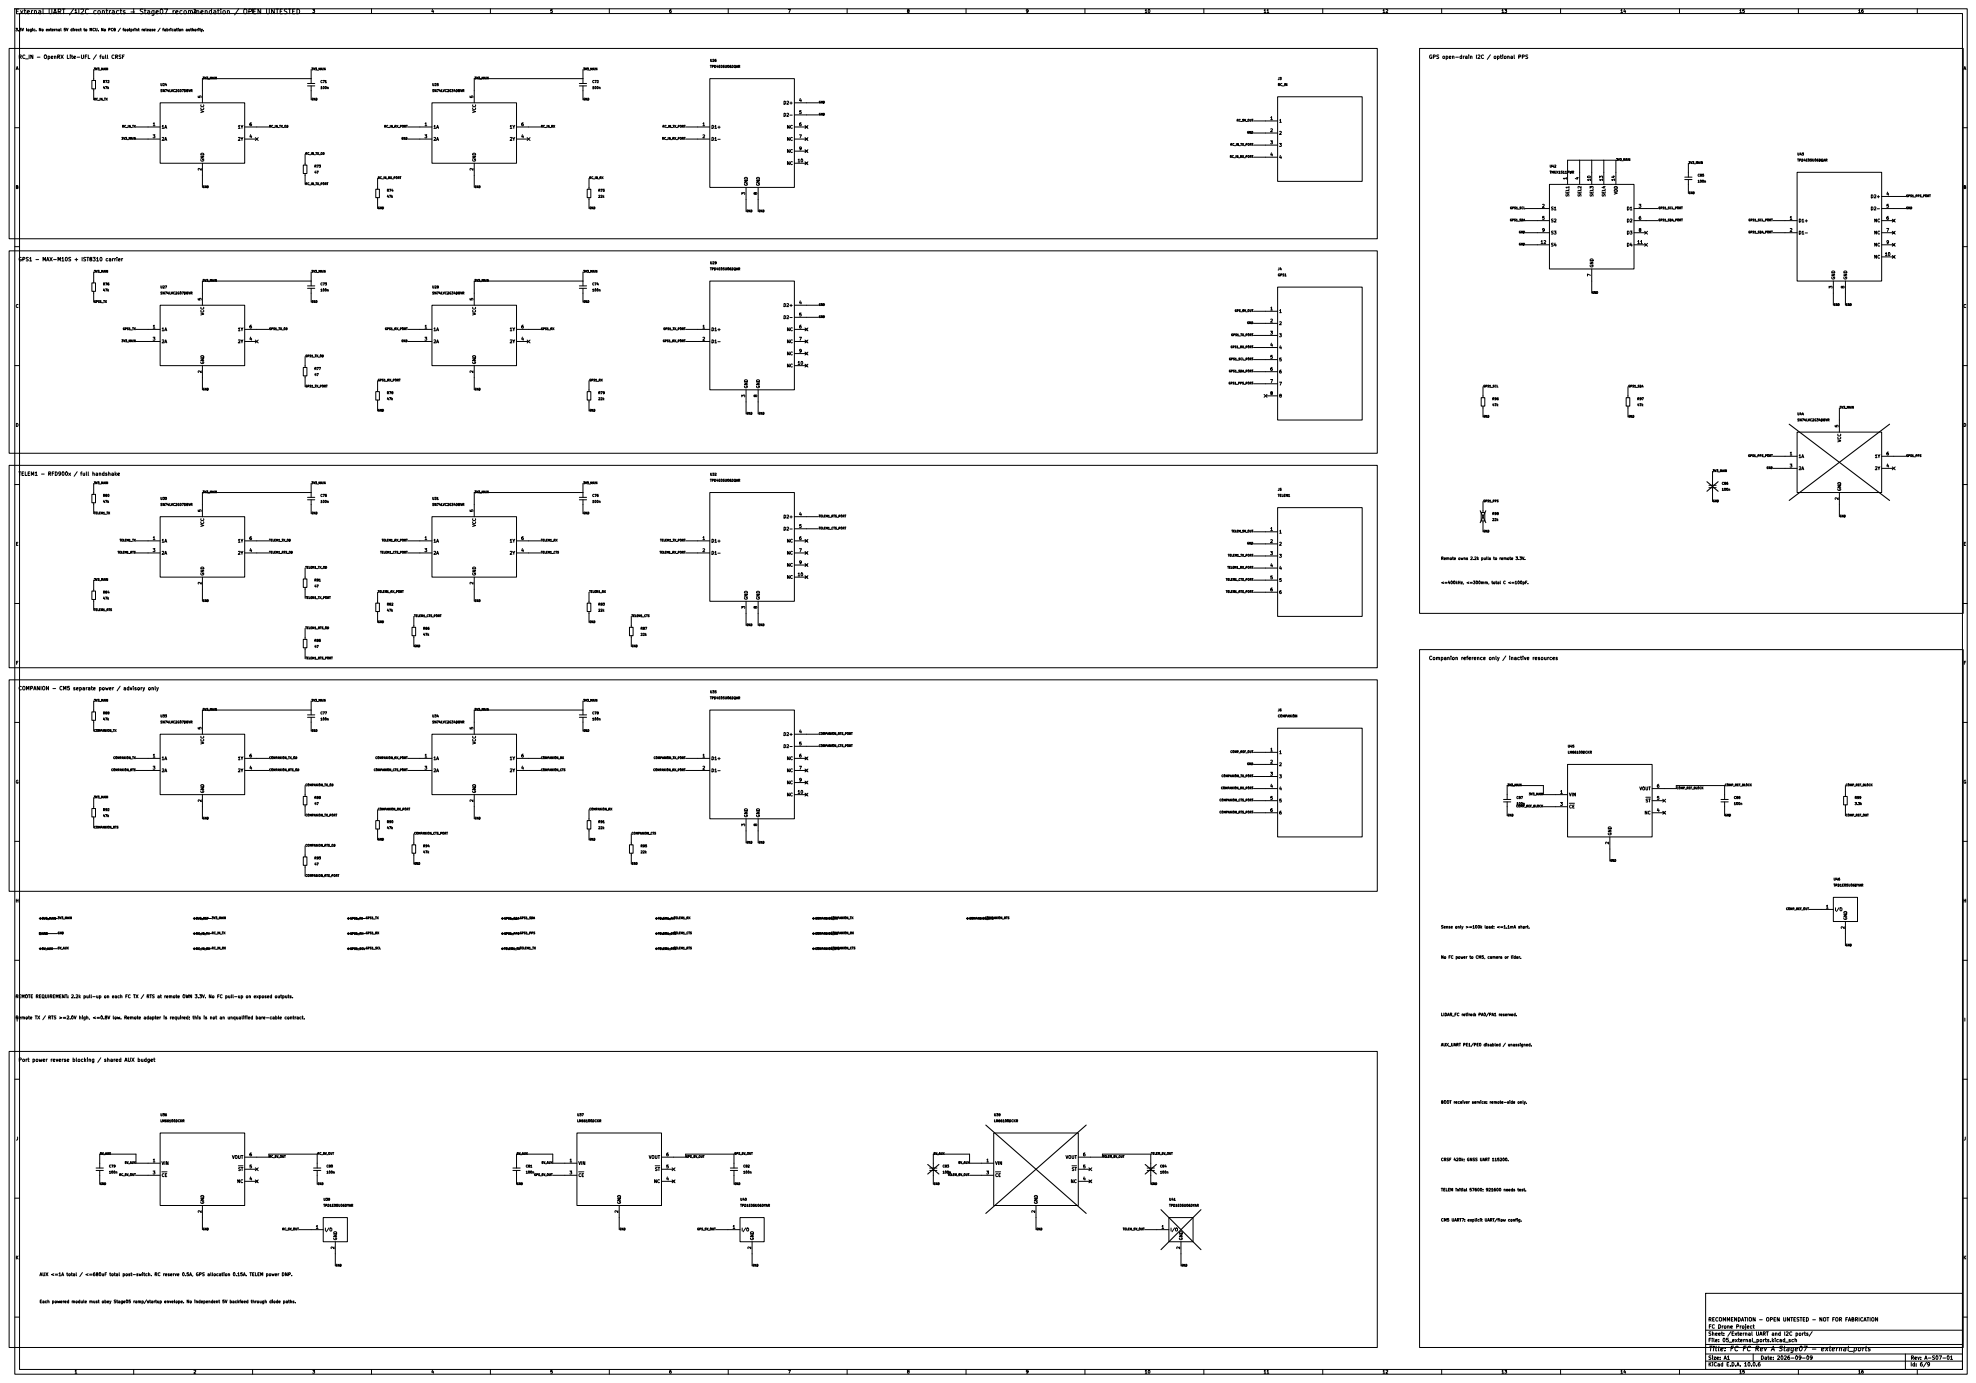
[picture p11: page 6]

External UART / I2C contracts - Stage07 recommendation / OPEN UNTESTED

RC_IN - OpenRX Lite-UFL / full CRSF

GPS open-drain I2C / optional PPS

Remote owns 2.2k pulls to remote 3.3V. <=400kHz, <=300mm, total C <=100pF.

Companion reference only / inactive resources

COMPANION - CM5 separate power / advisory only

Sense only >=100k load; <=1.1mA short.

REMOTE REQUIREMENT: 2.2k pull-up on each FC TX / RTS at remote OWN 3.3V. No FC pull-up on exposed outputs. Remote TX / RTS >=2.0V high, <=0.8V low. Remote adapter is required; this is not an unqualified bare-cable contract.

Port power reverse blocking / shared AUX budget AUX <=1A total / <=680uF total post-switch. RC reserve 0.5A, GPS allocation 0.15A. TELEM power DNP.

Sheet: /External UART and I2C ports/
File: 05_external_ports.kicad_sch
Title: FC FC Rev A Stage07 - external_ports

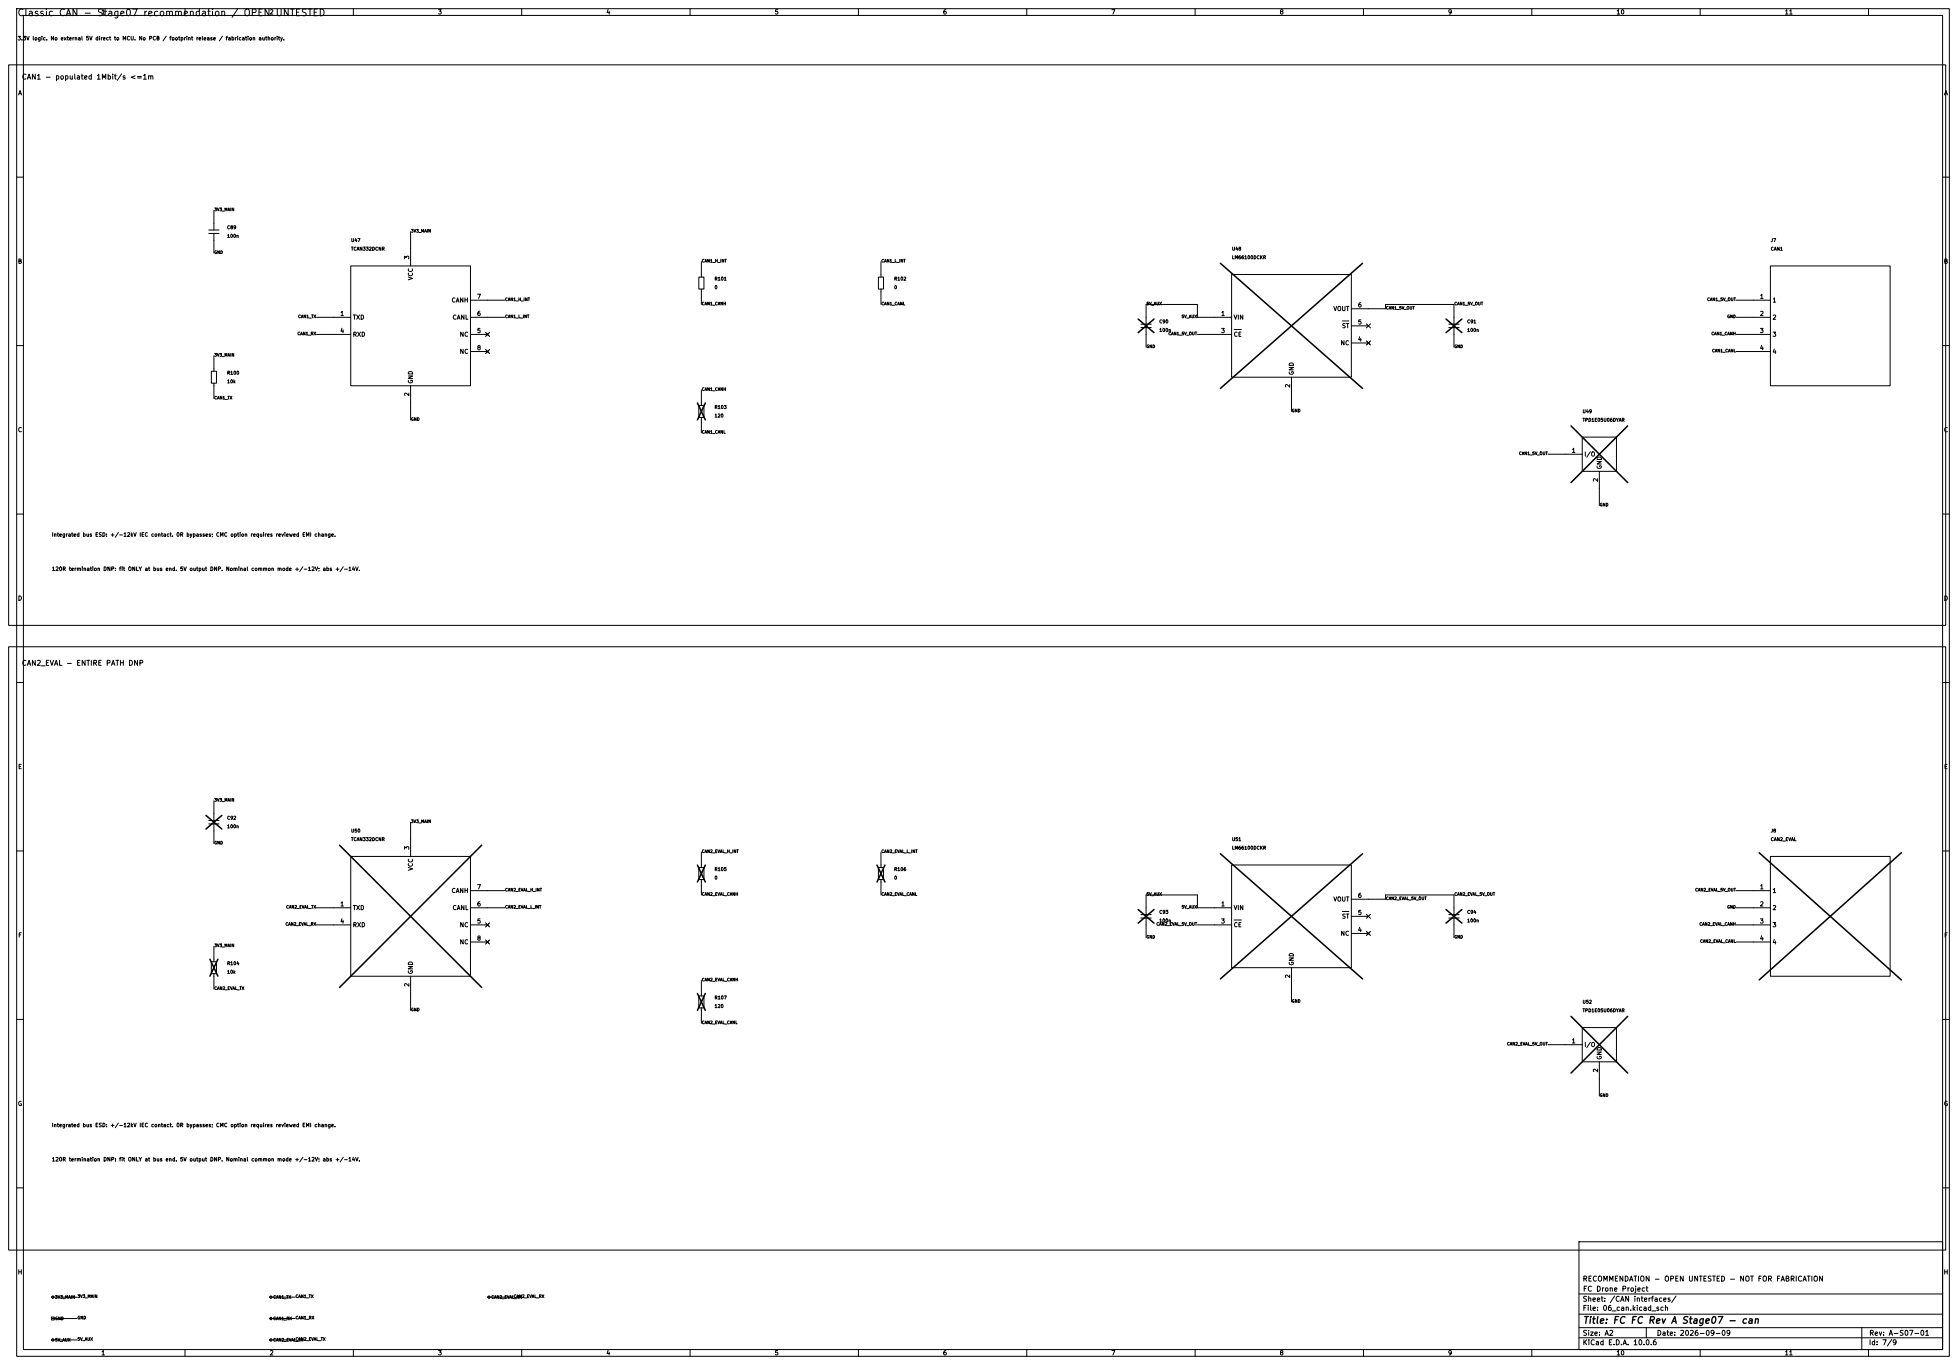
[picture p12: page 7]

Classic CAN - Stage07 recommendation / OPEN UNTESTED

3 RXD 4 NC 5 CANL 6 CANH 7 NC 8

Integrated bus ESD: +/-12kV IEC contact. 0R bypasses; CMC option requires reviewed EMI change.

120R termination DNP: fit ONLY at bus end. 5V output DNP. Nominal common mode +/-12V; abs +/-14V.

CAN2_EVAL_5V_OUT 120R termination DNP: fit ONLY at bus end. 5V output DNP. Nominal common mode +/-12V; abs +/-14V.

Sheet: /CAN interfaces/
File: 06_can.kicad_sch
Title: FC FC Rev A Stage07 - can

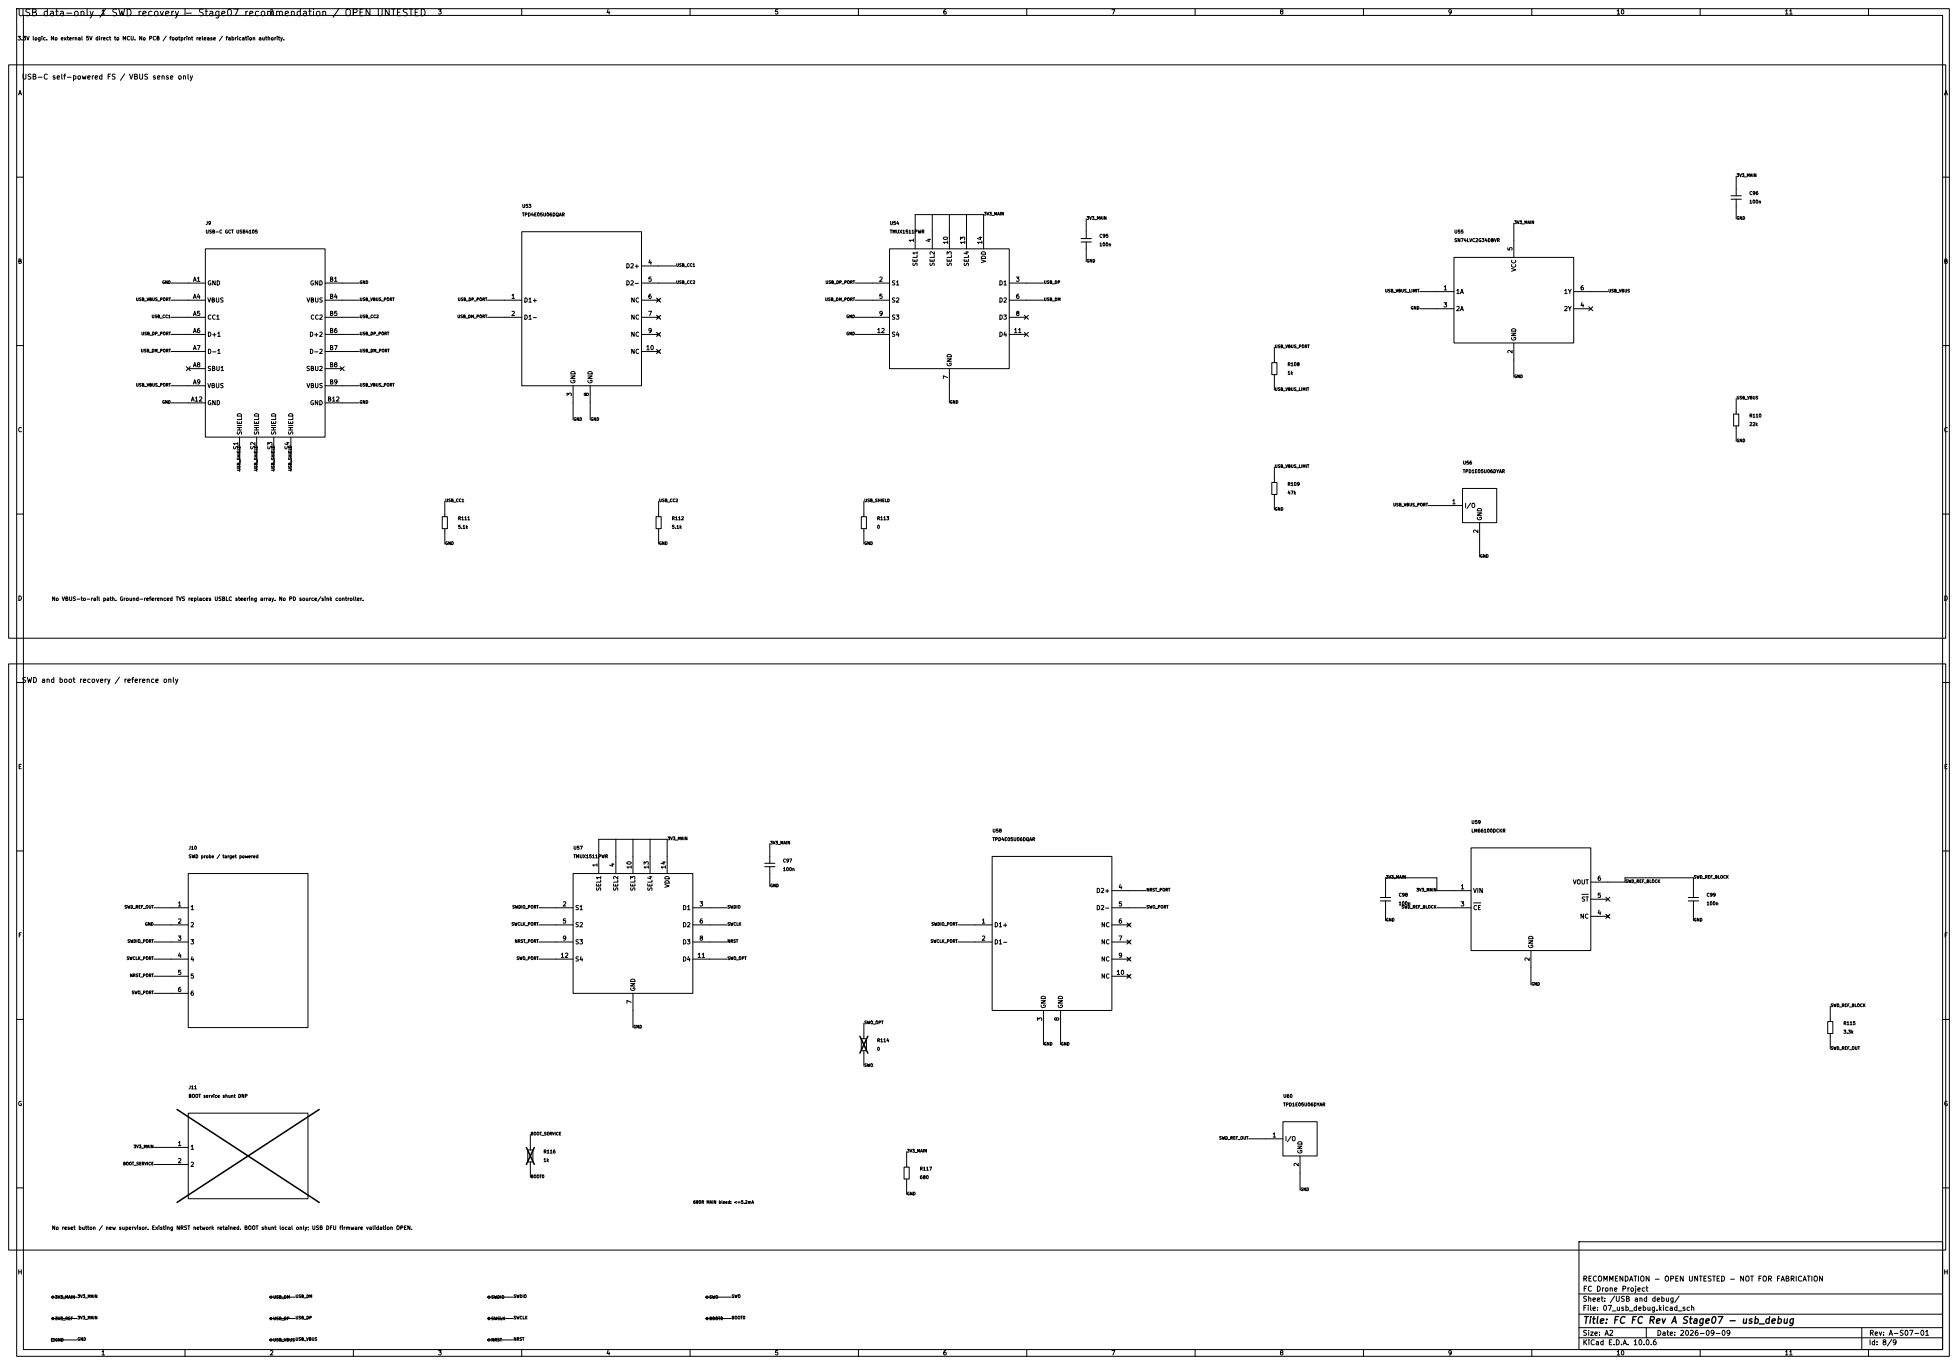
[picture p13: page 8]

USB-C self-powered FS / VBUS sense only

No VBUS-to-rail path. Ground-referenced TVS replaces USBLC steering array. No PD source/sink controller.

SWD probe / target powered

J11 BOOT service shunt DNP

No reset button / new supervisor. Existing NRST network retained. BOOT shunt local only; USB DFU firmware validation OPEN.

Sheet: /USB and debug/
File: 07_usb_debug.kicad_sch
Title: FC FC Rev A Stage07 - usb_debug

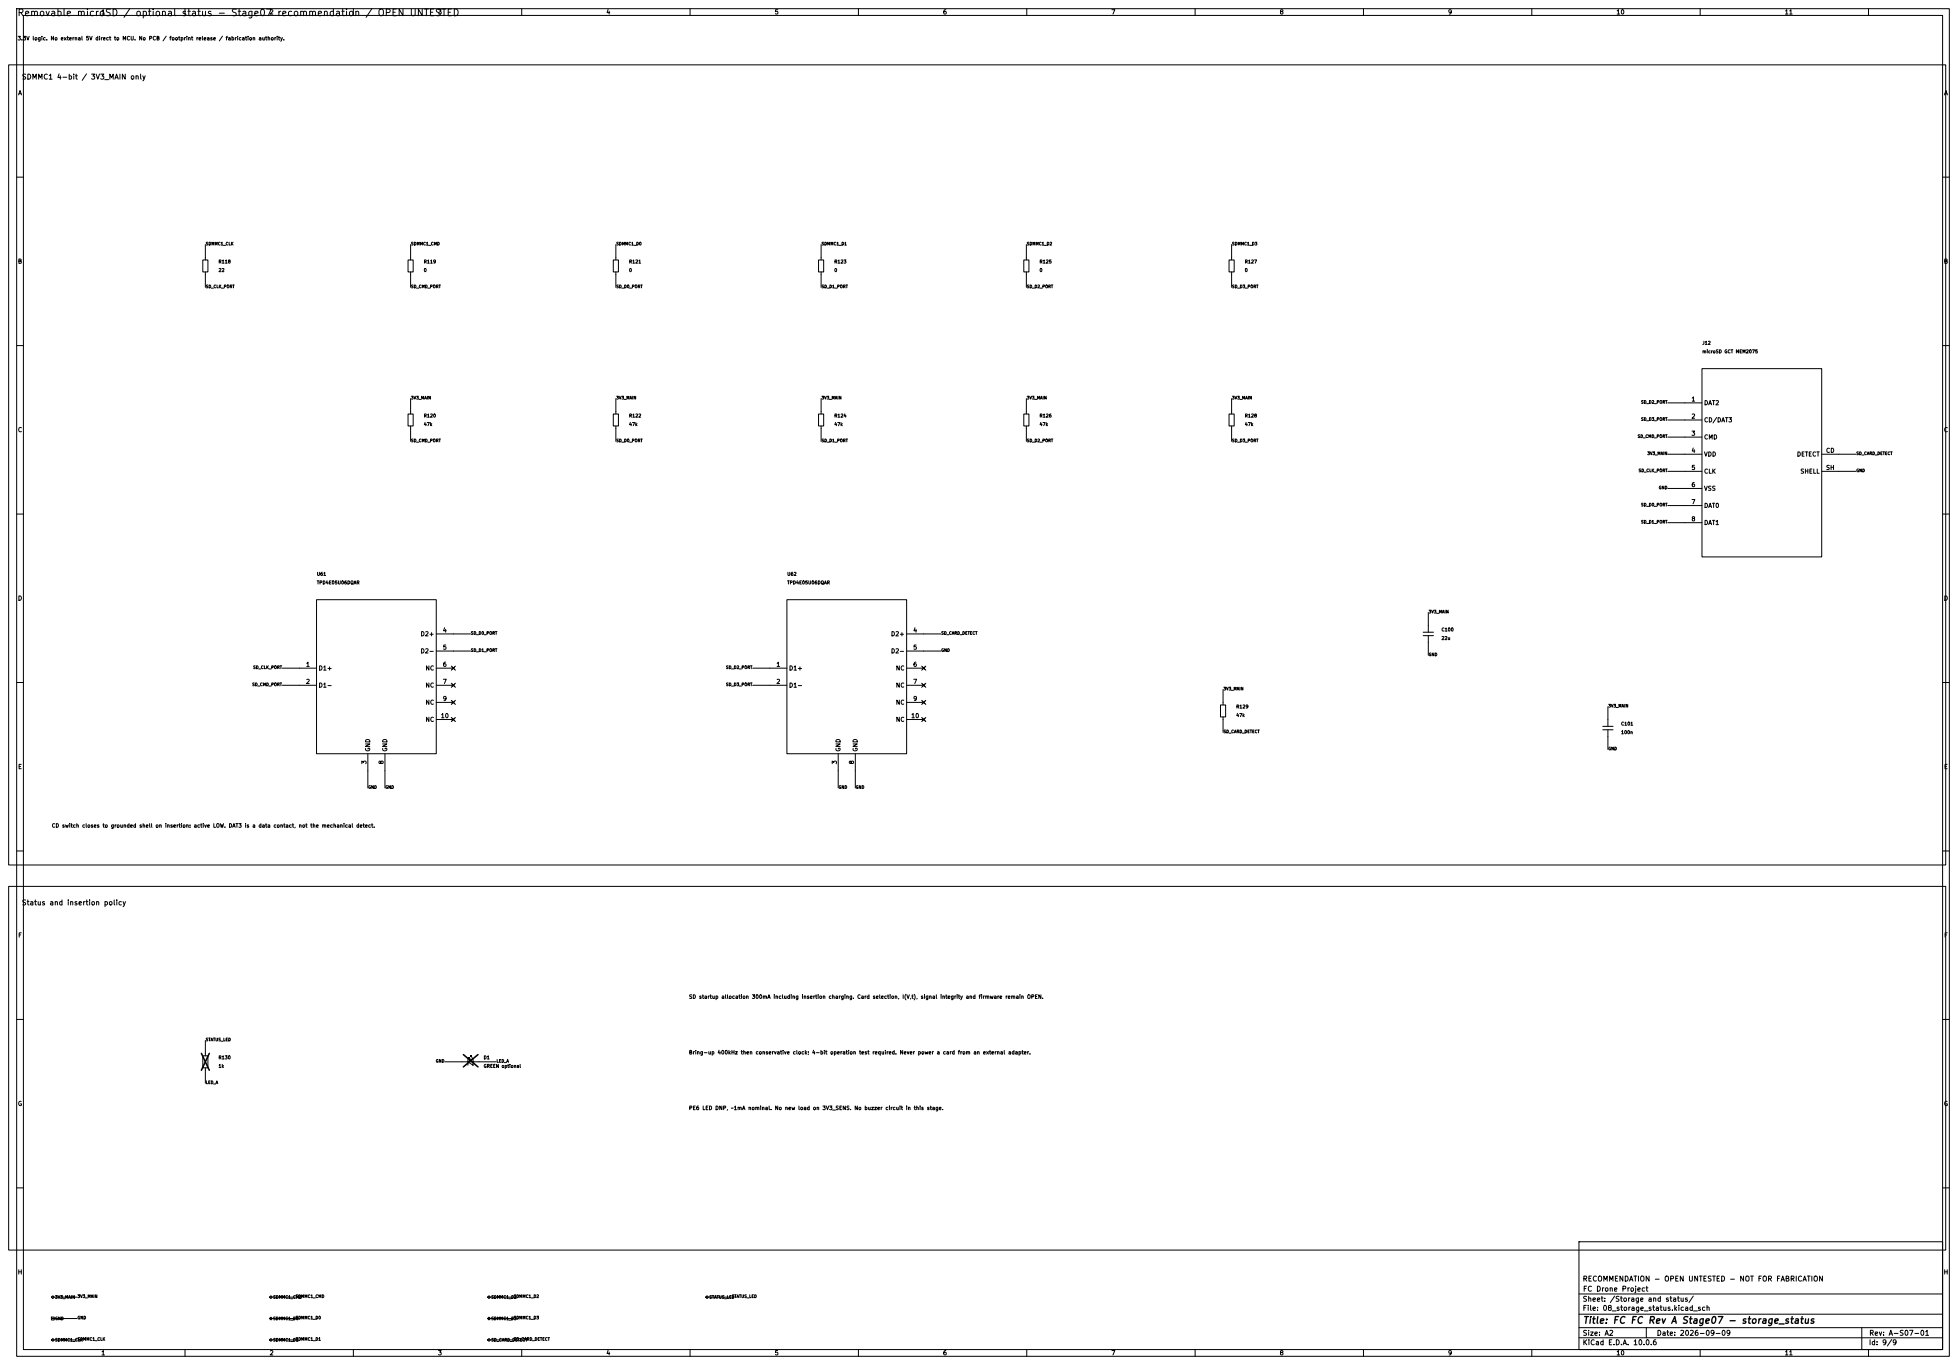
[picture p14: page 9]

Removable microSD / optional status - Stage07 recommendation / OPEN UNTESTED

CD switch closes to grounded shell on insertion: active LOW. DAT3 is a data contact, not the mechanical detect.

Status and insertion policy

SD startup allocation 300mA including insertion charging. Card selection, I(V,t), signal integrity and firmware remain OPEN. Bring-up 400kHz then conservative clock; 4-bit operation test required. Never power a card from an external adapter. PE6 LED DNP, ~1mA nominal. No new load on 3V3_SENS. No buzzer circuit in this stage.

Sheet: /Storage and status/
File: 08_storage_status.kicad_sch
Title: FC FC Rev A Stage07 - storage_status
