desanv01/Flight-Controller-V1/fabrication/jlcpcb/source/hardware/FC_REV_A.kicad_pcb

## KiCad design fabrication/jlcpcb/source/hardware/FC_REV_A.kicad_pcb (2026-10-14)

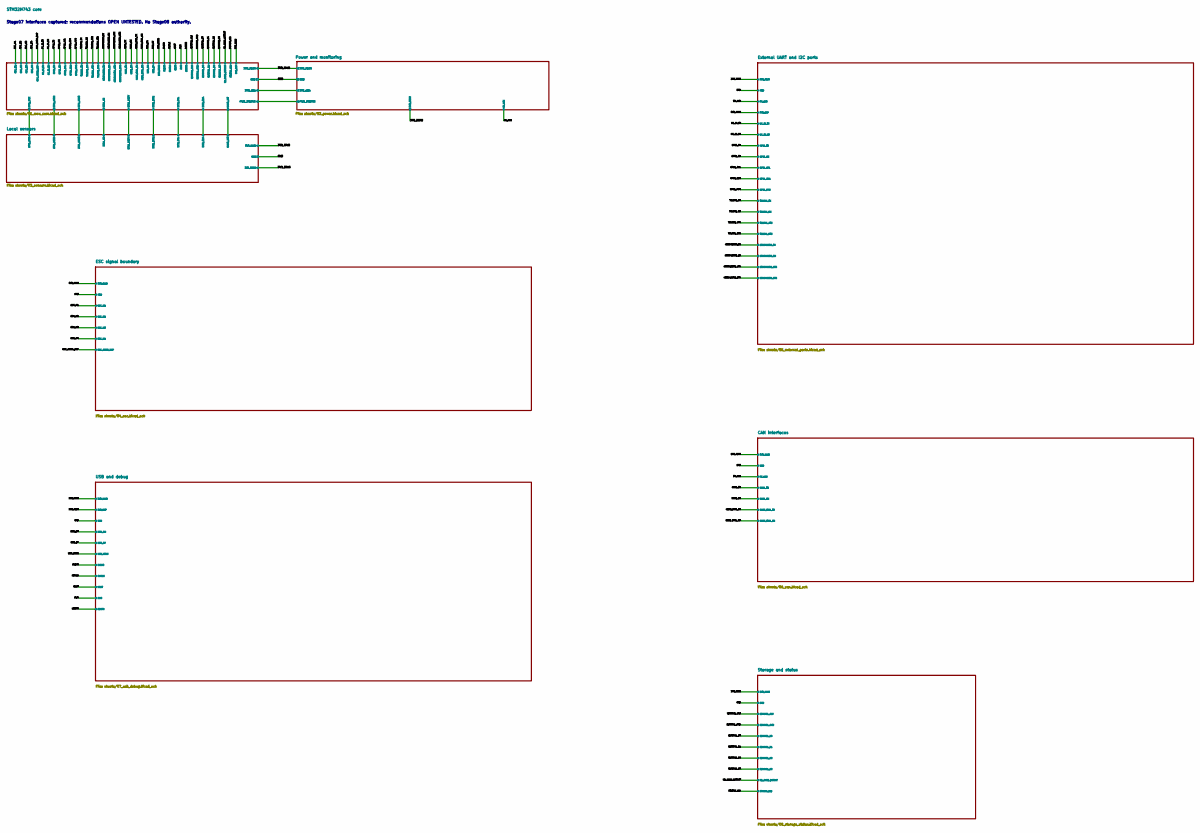
[picture p15: schematic FC_REV_A.kicad_sch, Flight Controller V1]

Notes on the sheet:
Stage07 interfaces captured; recommendations OPEN UNTESTED. No Stage08 authority.

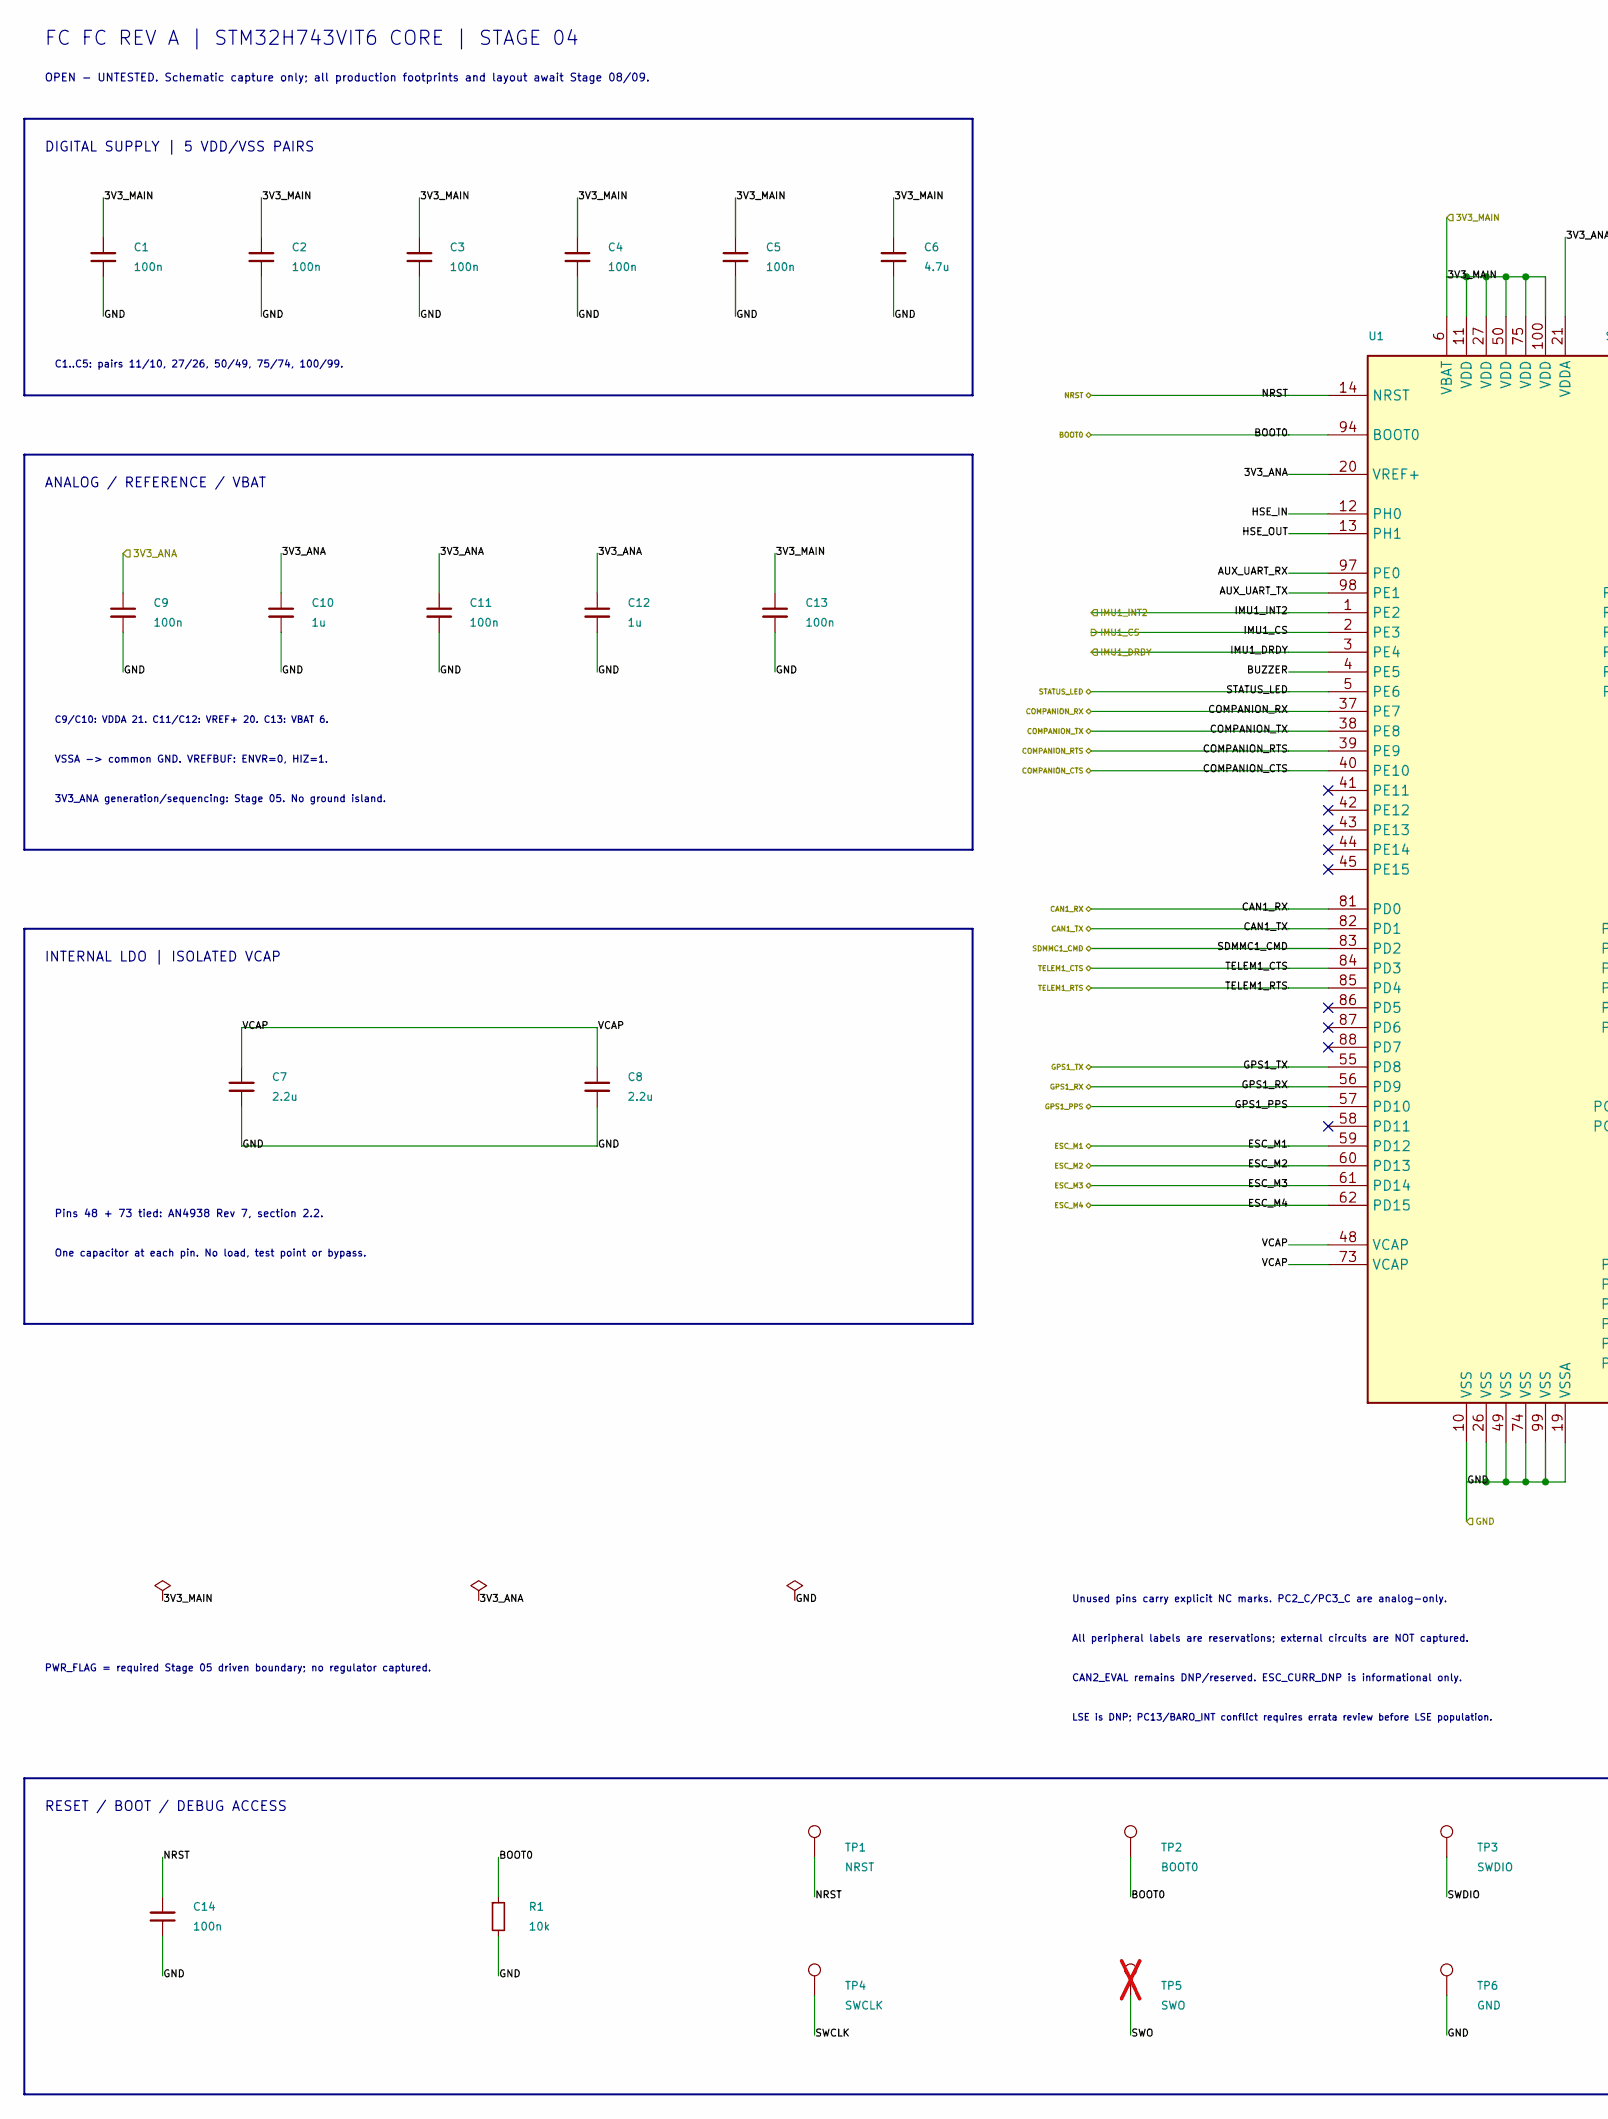
[picture p16: schematic 01_mcu_core.kicad_sch, FC FC Rev A - STM32H743 core, part in row 1, column 1]

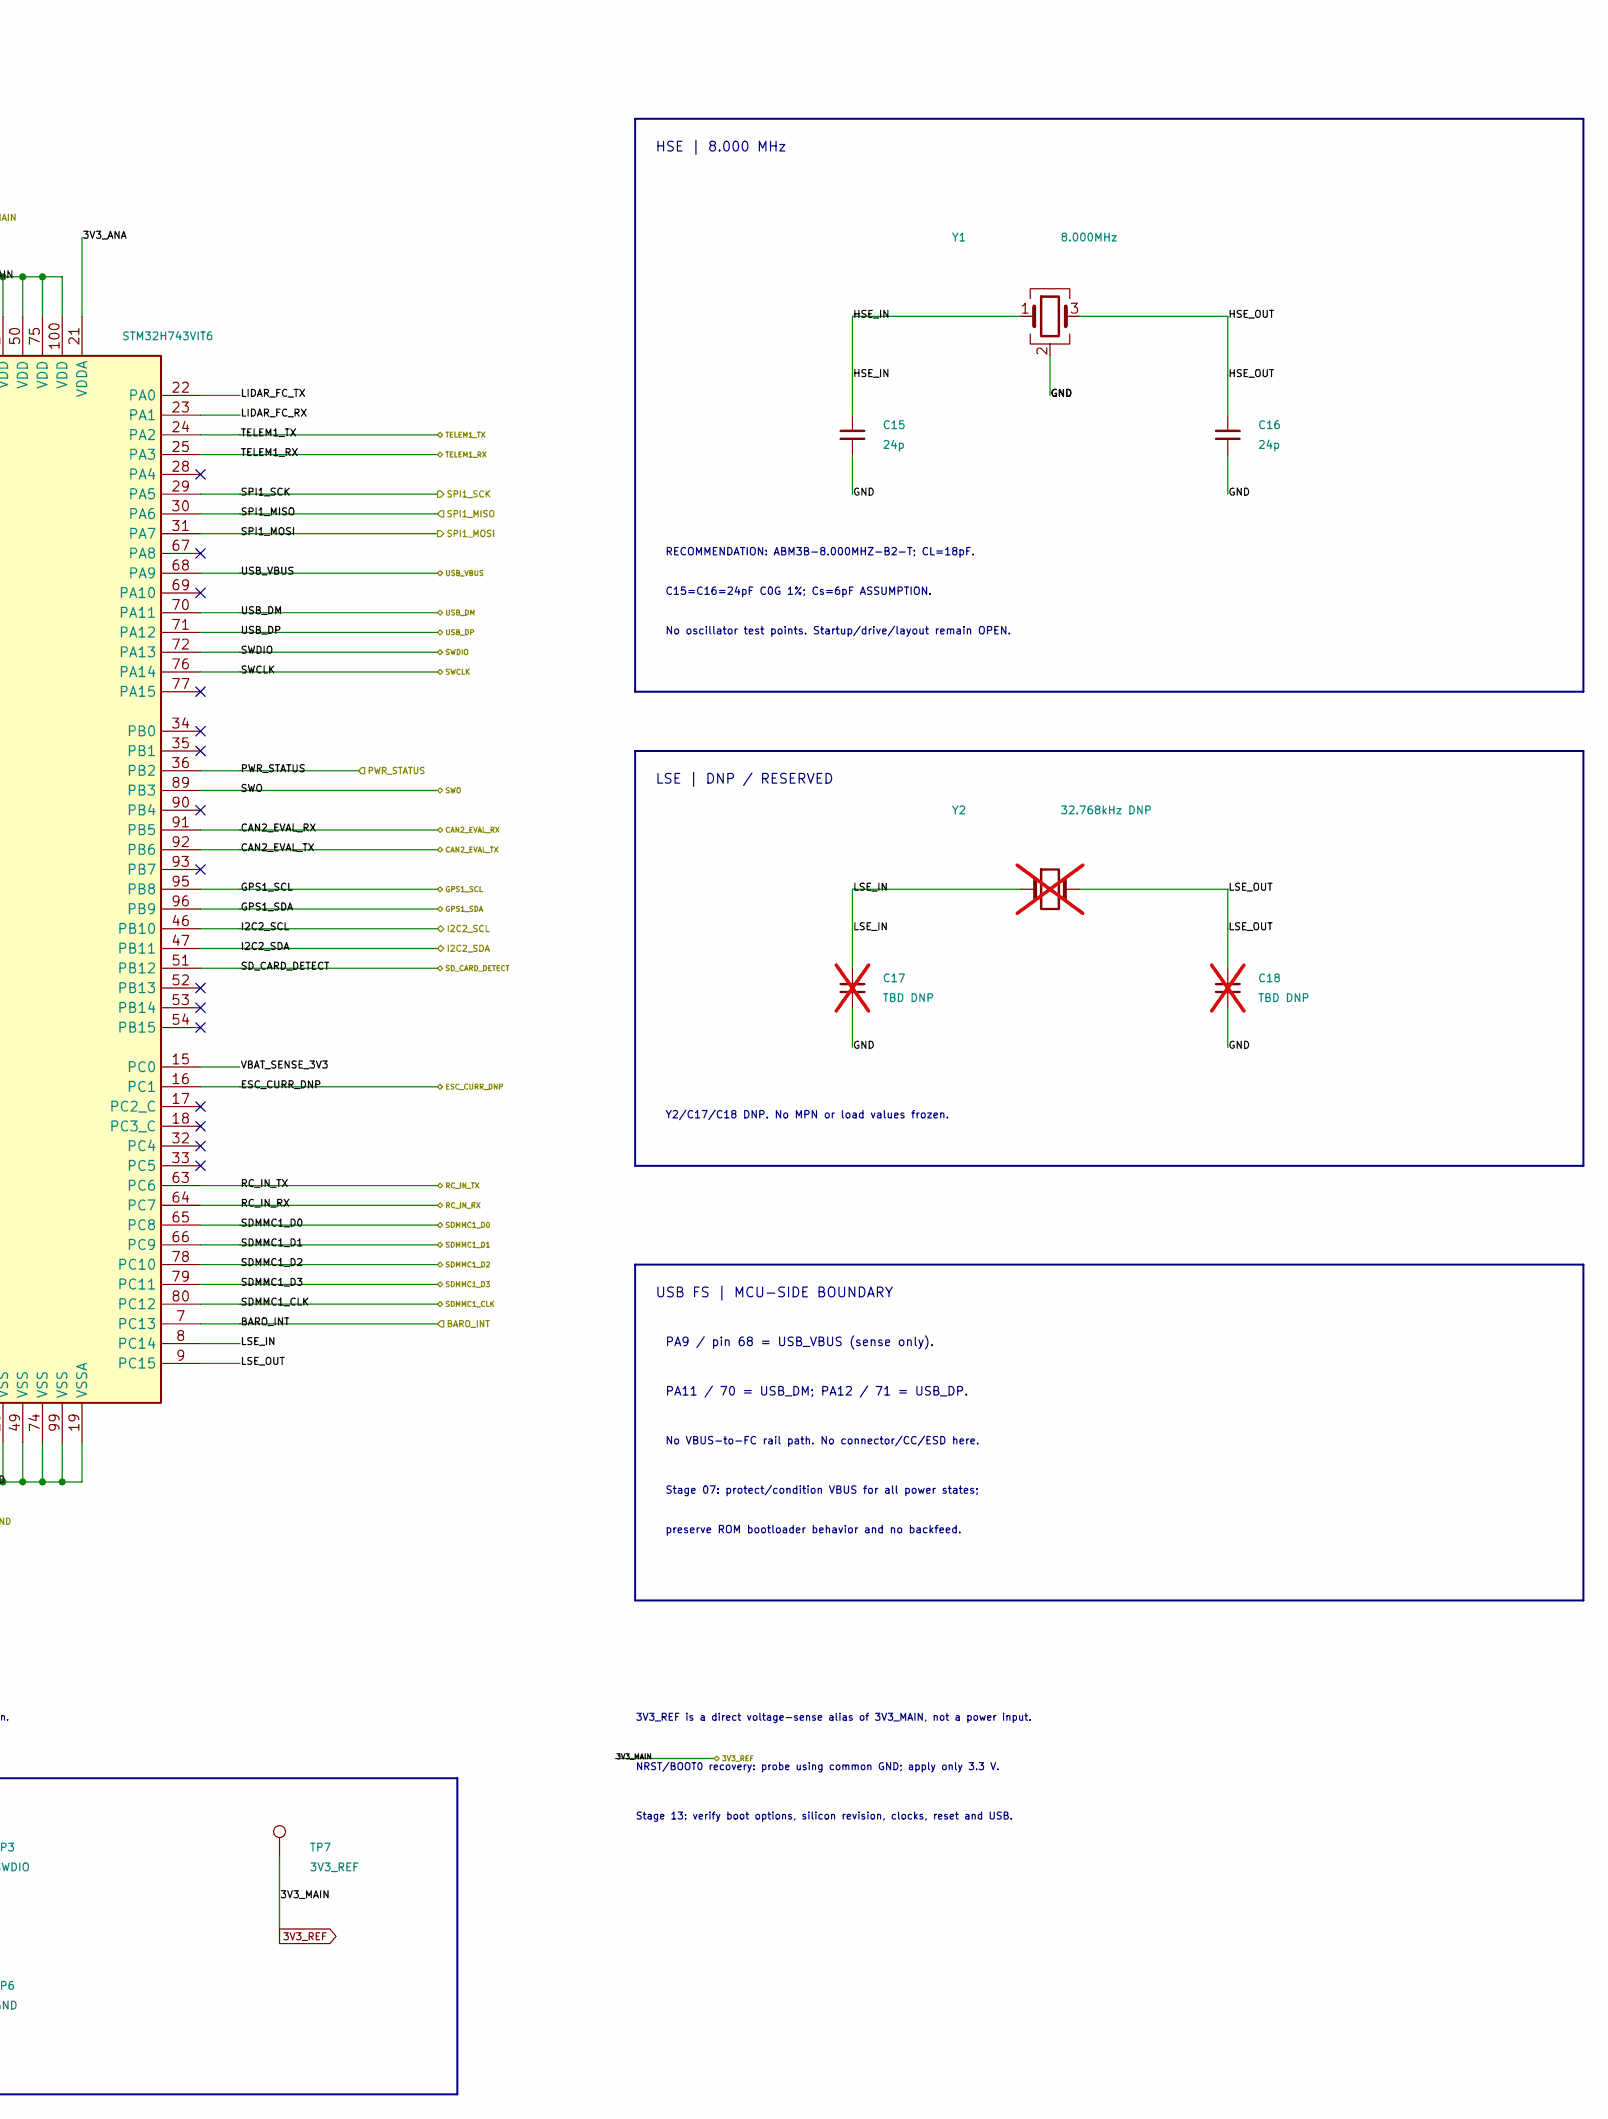
[picture p17: schematic 01_mcu_core.kicad_sch, FC FC Rev A - STM32H743 core, part in row 1, column 2]

Parts:
C1, C2, C3, C4, C5, C9, C11, C13, C14: 100n; Capacitor_SMD__C_0603_1608Metric
C6: 4.7u; Capacitor_SMD__C_0603_1608Metric
C7, C8: 2.2u; Capacitor_SMD__C_0603_1608Metric
C10, C12: 1u; Capacitor_SMD__C_0603_1608Metric
C15, C16: 24p; Capacitor_SMD__C_0603_1608Metric
C17, C18: TBD DNP; Capacitor_SMD__C_0603_1608Metric; not fitted
R1: 10k; Resistor_SMD__R_0603_1608Metric
TP1: NRST; TestPoint__TestPoint_Pad_D1.0mm
TP2: BOOT0; TestPoint__TestPoint_Pad_D1.0mm
TP3: SWDIO; TestPoint__TestPoint_Pad_D1.0mm
TP4: SWCLK; TestPoint__TestPoint_Pad_D1.0mm
TP5: SWO; TestPoint__TestPoint_Pad_D1.0mm; not fitted
TP6: GND; TestPoint__TestPoint_Pad_D1.0mm
TP7: 3V3_REF; TestPoint__TestPoint_Pad_D1.0mm
U1: STM32H743VIT6; Package_QFP__LQFP-100_14x14mm_P0.5mm
Y1: 8.000MHz; Crystal__Crystal_SMD_Abracon_ABM3B-4Pin_5.0x3.2mm
Y2: 32.768kHz DNP; Crystal_SMD_1610-2Pin_1.6x1.0mm; not fitted

Connections:
3V3_REF: C1.1, C2.1, C3.1, C4.1, C5.1, C6.1, C13.1, TP7.1, U1.6 (VBAT), U1.11 (VDD), U1.27 (VDD), U1.50 (VDD), U1.75 (VDD), U1.100 (VDD); also elsewhere on the board
/BOOT0: R1.1, TP2.1, U1.94 (BOOT0); also elsewhere on the board
/CAN1_RX: U1.81 (PD0); also elsewhere on the board
/CAN1_TX: U1.82 (PD1); also elsewhere on the board
/CAN2_EVAL_RX: U1.91 (PB5); also elsewhere on the board
/CAN2_EVAL_TX: U1.92 (PB6); also elsewhere on the board
/COMPANION_CTS: U1.40 (PE10); also elsewhere on the board
/COMPANION_RTS: U1.39 (PE9); also elsewhere on the board
/COMPANION_RX: U1.37 (PE7); also elsewhere on the board
/COMPANION_TX: U1.38 (PE8); also elsewhere on the board
/ESC_CURR_DNP: U1.16 (PC1); also elsewhere on the board
/ESC_M1: U1.59 (PD12); also elsewhere on the board
/ESC_M2: U1.60 (PD13); also elsewhere on the board
/ESC_M3: U1.61 (PD14); also elsewhere on the board
/ESC_M4: U1.62 (PD15); also elsewhere on the board
/GND: C1.2, C2.2, C3.2, C4.2, C5.2, C6.2, C7.2, C8.2, C9.2, C10.2, C11.2, C12.2, C13.2, C14.2, C15.2, C16.2, C17.2, C18.2, R1.2, TP6.1, U1.10 (VSS), U1.19 (VSSA), U1.26 (VSS), U1.49 (VSS), U1.74 (VSS), U1.99 (VSS), Y1.2 (G), Y1.4 (G); also elsewhere on the board
/GPS1_PPS: U1.57 (PD10); also elsewhere on the board
/GPS1_RX: U1.56 (PD9); also elsewhere on the board
/GPS1_SCL: U1.95 (PB8); also elsewhere on the board
/GPS1_SDA: U1.96 (PB9); also elsewhere on the board
/GPS1_TX: U1.55 (PD8); also elsewhere on the board
/Local sensors/IMU1_CS: U1.2 (PE3); also elsewhere on the board
/Local sensors/SPI1_MOSI: U1.31 (PA7); also elsewhere on the board
/Local sensors/SPI1_SCK: U1.29 (PA5); also elsewhere on the board
/NRST: C14.1, TP1.1, U1.14 (NRST); also elsewhere on the board
/Power and monitoring/3V3_ANA: C9.1, C10.1, C11.1, C12.1, U1.20 (VREF+), U1.21 (VDDA); also elsewhere on the board
/Power and monitoring/PWR_STATUS: U1.36 (PB2); also elsewhere on the board
/RC_IN_RX: U1.64 (PC7); also elsewhere on the board
/RC_IN_TX: U1.63 (PC6); also elsewhere on the board
/SDMMC1_CLK: U1.80 (PC12); also elsewhere on the board
/SDMMC1_CMD: U1.83 (PD2); also elsewhere on the board
/SDMMC1_D0: U1.65 (PC8); also elsewhere on the board
/SDMMC1_D1: U1.66 (PC9); also elsewhere on the board
/SDMMC1_D2: U1.78 (PC10); also elsewhere on the board
/SDMMC1_D3: U1.79 (PC11); also elsewhere on the board
/SD_CARD_DETECT: U1.51 (PB12); also elsewhere on the board
/STATUS_LED: U1.5 (PE6); also elsewhere on the board
/STM32H743 core/AUX_UART_RX: U1.97 (PE0)
/STM32H743 core/AUX_UART_TX: U1.98 (PE1)
/STM32H743 core/BARO_INT: U1.7 (PC13); also elsewhere on the board
/STM32H743 core/BUZZER: U1.4 (PE5)
/STM32H743 core/HSE_IN: C15.1, U1.12 (PH0), Y1.1
/STM32H743 core/HSE_OUT: C16.1, U1.13 (PH1), Y1.3
/STM32H743 core/I2C2_SCL: U1.46 (PB10); also elsewhere on the board
/STM32H743 core/I2C2_SDA: U1.47 (PB11); also elsewhere on the board
/STM32H743 core/IMU1_DRDY: U1.3 (PE4); also elsewhere on the board
/STM32H743 core/IMU1_INT2: U1.1 (PE2); also elsewhere on the board
/STM32H743 core/LIDAR_FC_RX: U1.23 (PA1)
/STM32H743 core/LIDAR_FC_TX: U1.22 (PA0)
/STM32H743 core/LSE_IN: C17.1, U1.8 (PC14), Y2.1
/STM32H743 core/LSE_OUT: C18.1, U1.9 (PC15), Y2.2
/STM32H743 core/SPI1_MISO: U1.30 (PA6); also elsewhere on the board
/STM32H743 core/VBAT_SENSE_3V3: U1.15 (PC0)
/STM32H743 core/VCAP: C7.1, C8.1, U1.48 (VCAP), U1.73 (VCAP)
/SWCLK: TP4.1, U1.76 (PA14); also elsewhere on the board
/SWDIO: TP3.1, U1.72 (PA13); also elsewhere on the board
/SWO: TP5.1, U1.89 (PB3); also elsewhere on the board
/TELEM1_CTS: U1.84 (PD3); also elsewhere on the board
/TELEM1_RTS: U1.85 (PD4); also elsewhere on the board
/TELEM1_RX: U1.25 (PA3); also elsewhere on the board
/TELEM1_TX: U1.24 (PA2); also elsewhere on the board
/USB_DM: U1.70 (PA11); also elsewhere on the board
/USB_DP: U1.71 (PA12); also elsewhere on the board
/USB_VBUS: U1.68 (PA9); also elsewhere on the board

Notes on the sheet:
FC FC REV A | STM32H743VIT6 CORE | STAGE 04
OPEN - UNTESTED. Schematic capture only; all production footprints and layout await Stage 08/09.
DIGITAL SUPPLY | 5 VDD/VSS PAIRS
C1..C5: pairs 11/10, 27/26, 50/49, 75/74, 100/99.
ANALOG / REFERENCE / VBAT
C9/C10: VDDA 21. C11/C12: VREF+ 20. C13: VBAT 6.
VSSA -> common GND. VREFBUF: ENVR=0, HIZ=1.
3V3_ANA generation/sequencing: Stage 05. No ground island.
INTERNAL LDO | ISOLATED VCAP
Pins 48 + 73 tied: AN4938 Rev 7, section 2.2.
One capacitor at each pin. No load, test point or bypass.
PWR_FLAG = required Stage 05 driven boundary; no regulator captured.
Unused pins carry explicit NC marks. PC2_C/PC3_C are analog-only.
All peripheral labels are reservations; external circuits are NOT captured.
CAN2_EVAL remains DNP/reserved. ESC_CURR_DNP is informational only.
LSE is DNP; PC13/BARO_INT conflict requires errata review before LSE population.
HSE | 8.000 MHz
RECOMMENDATION: ABM3B-8.000MHZ-B2-T; CL=18pF.
C15=C16=24pF C0G 1%; Cs=6pF ASSUMPTION.
No oscillator test points. Startup/drive/layout remain OPEN.
LSE | DNP / RESERVED
Y2/C17/C18 DNP. No MPN or load values frozen.
RESET / BOOT / DEBUG ACCESS
USB FS | MCU-SIDE BOUNDARY
PA9 / pin 68 = USB_VBUS (sense only).
PA11 / 70 = USB_DM; PA12 / 71 = USB_DP.
No VBUS-to-FC rail path. No connector/CC/ESD here.
Stage 07: protect/condition VBUS for all power states;
preserve ROM bootloader behavior and no backfeed.
3V3_REF is a direct voltage-sense alias of 3V3_MAIN, not a power input.
NRST/BOOT0 recovery: probe using common GND; apply only 3.3 V.
Stage 13: verify boot options, silicon revision, clocks, reset and USB.

Schematic: 02_power.kicad_sch, FC FC Rev A - Power tree

Parts:
C19, C20, C27, C28, C29, C38, C42: 100n; Capacitor_SMD__C_1206_3216Metric; MPN C1206C104J5GACTU
C21, C23, C24, C25, C30, C31, C32, C33, C34, C40, C41, C47, C48, C49, C50: 22u; Capacitor_SMD__C_1210_3225Metric; MPN GRM32ER71E226KE15L
C22, C26, C35, C39, C43, C44, C45, C46: 100n; Capacitor_SMD__C_0603_1608Metric; MPN GRM188R71H104KA93D
C36: 2.2u; Capacitor_SMD__C_1206_3216Metric; MPN GRM31CR71H225KA88L
C37: 4.7n; Capacitor_SMD__C_0603_1608Metric; MPN C0603C472J5GACTU
FB1: 600R@100MHz; Inductor_SMD__L_0603_1608Metric; MPN BLM18AG601SN1D
J_POWER1: 43045-0600; POWER1_Molex_43045_0600_4Electrical_2NPTH; MPN 43045-0600
L1: 2.2u; Inductor_SMD__L_Coilcraft_XAL4020-XXX; MPN XAL4020-222MEC
L2: 6.8u; Inductor_SMD__L_Coilcraft_XAL7070-XXX; MPN XAL7070-682MEC
R2: 28.7k; Resistor_SMD__R_0603_1608Metric; MPN RT0603BRD0728K7L
R3, R5, R9, R12, R13, R15, R20, R22, R25, R32, R34, R37: 10k; Resistor_SMD__R_0603_1608Metric; MPN RT0603BRD0710KL
R4: 37.4k; Resistor_SMD__R_0603_1608Metric; MPN RT0603BRD0737K4L
R6: 732; Resistor_SMD__R_0603_1608Metric; MPN RT0603BRD07732RL
R7: 100; Resistor_SMD__R_0603_1608Metric; MPN RT0603BRD07100RL
R8, R10, R28, R31, R33, R36: 100k; Resistor_SMD__R_0603_1608Metric; MPN RT0603BRD07100KL
R11: 31.2k; Resistor_SMD__R_0603_1608Metric; MPN RT0603BRD0731K2L
R14: 31.6k; Resistor_SMD__R_0603_1608Metric; MPN RT0603BRD0731K6L
R16, R30: 49.9k; Resistor_SMD__R_0603_1608Metric; MPN RT0603BRD0749K9L
R17: 680; Resistor_SMD__R_0603_1608Metric; MPN RT0603BRD07680RL
R18: 71.5k; Resistor_SMD__R_0603_1608Metric; MPN RT0603BRD0771K5L
R19, R24: 34.8k; Resistor_SMD__R_0603_1608Metric; MPN RT0603BRD0734K8L
R21: 45.3k; Resistor_SMD__R_0603_1608Metric; MPN RT0603BRD0745K3L
R23: 1k; Resistor_SMD__R_0603_1608Metric; MPN RT0603BRD071KL
R26, R35: 220k; Resistor_SMD__R_0603_1608Metric; MPN RT0603BRD07220KL
R27: 0; Resistor_SMD__R_0603_1608Metric; MPN RC0603JR-070RL; not fitted
R29: 137k; Resistor_SMD__R_0603_1608Metric; MPN RT0603BRD07137KL
TP8: 5V_FC_IN; TestPoint__TestPoint_Pad_D1.0mm; MPN PCB_TEST_PAD
TP9: 5V_FC_PROTECTED; TestPoint__TestPoint_Pad_D1.0mm; MPN PCB_TEST_PAD
TP10: 5V_AUX; TestPoint__TestPoint_Pad_D1.0mm; MPN PCB_TEST_PAD
TP11: 3V3_MAIN; TestPoint__TestPoint_Pad_D1.0mm; MPN PCB_TEST_PAD
TP12: 3V3_SENS; TestPoint__TestPoint_Pad_D1.0mm; MPN PCB_TEST_PAD
TP13: 3V3_ANA; TestPoint__TestPoint_Pad_D1.0mm; MPN PCB_TEST_PAD
TP14: PWR_STATUS; TestPoint__TestPoint_Pad_D1.0mm; MPN PCB_TEST_PAD
TP15: GND; TestPoint__TestPoint_Pad_D1.0mm; MPN PCB_TEST_PAD
U2: TPS259470LRPWR; TI_RPW0010_HotRod_2x2; MPN TPS259470LRPWR; LCSC C3662793
U3, U11: TPS3808G01DBVR; Package_TO_SOT_SMD__SOT-23-6; MPN TPS3808G01DBVR; LCSC C19653
U4: TPS62130ARGTR; Package_DFN_QFN__VQFN-16-1EP_3x3mm_P0.5mm_EP1.68x1.68mm; MPN TPS62130ARGTR; LCSC C337502
U5: TPS552892RYQR; TI_RYQ0021_HotRod_5x3; MPN TPS552892RYQR; LCSC C19272254
U6: TPS25940LRVCR; Package_DFN_QFN__Texas_RVC0020A_WQFN-20-1EP_3x4mm_P0.5mm_EP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; MPN TPS25940LRVCR; LCSC C2867756
U7: TPS73633DBVR; Package_TO_SOT_SMD__SOT-23-5; MPN TPS73633DBVR; LCSC C28038
U8: SN74HCS11DR; Package_SO__SOIC-14_3.9x8.7mm_P1.27mm; MPN SN74HCS11DR; LCSC C2869822
U9, U10: TPS3700DDCR; Package_TO_SOT_SMD__SOT-23-6; MPN TPS3700DDCR; LCSC C33002

Connections:
3V3_REF: C23.1, C24.1, C43.1, C44.1, C45.1, C46.1, FB1.1, L1.2, R11.1, R13.1, R27.1, R28.1, R33.1, R34.1, TP11.1, U4.7 (FSW), U4.14 (VOS), U8.13 (1C), U8.14 (VCC), U9.5 (VDD), U10.5 (VDD); also elsewhere on the board
5V_FC_IN_A: C19.1, J_POWER1.1 (5V_FC_IN_A), J_POWER1.3 (5V_FC_IN_B), R2.1, R4.1, R8.1, TP8.1, U2.5 (IN)
/3V3_SENS: C41.1, TP12.1, U7.5 (OUT); also elsewhere on the board
/5V_AUX: C39.1, R24.1, R31.1, TP10.1, U6.4 (OUT), U6.5 (OUT), U6.6 (OUT), U6.7 (OUT), U6.8 (OUT); also elsewhere on the board
/GND: C19.2, C20.2, C21.2, C22.2, C23.2, C24.2, C25.2, C26.2, C27.2, C30.2, C31.2, C32.2, C33.2, C34.2, C35.2, C36.2, C37.2, C38.2, C39.2, C40.2, C41.2, C42.2, C43.2, C44.2, C45.2, C46.2, C47.2, C48.2, C49.2, C50.2, J_POWER1.2 (GND_A), J_POWER1.4 (GND_B), R3.2, R5.2, R6.2, R9.2, R12.2, R15.2, R16.2, R18.2, R20.2, R22.2, R23.2, R25.2, R26.2, R30.2, R32.2, R35.2, R37.2, TP15.1, U2.8 (GND), U3.2 (GND), U4.6 (AGND), U4.8 (DEF), U4.15 (PGND), U4.16 (PGND), U4.17 (EP), U5.5 (DITH/SYNC), U5.9 (PGND), U5.17 (AGND), U6.1 (DEVSLP), U6.16 (GND), U6.21 (EP), U7.2 (GND), U8.7 (GND), U8.9 (3A), U8.10 (3B), U8.11 (3C), U9.2 (GND), U9.4 (INB-), U10.2 (GND), U10.4 (INB-), U11.2 (GND); also elsewhere on the board
/Power and monitoring/3V3_ANA: FB1.2, R27.2, TP13.1; also elsewhere on the board
/Power and monitoring/5V_AUX_REG: C30.1, C31.1, C32.1, R14.1, R19.1, R21.1, U5.11 (VOUT), U5.12 (ISP), U5.13 (ISN), U6.9 (IN), U6.10 (IN), U6.11 (IN), U6.12 (IN), U6.13 (IN)
/Power and monitoring/5V_FC_PROTECTED: C21.1, C22.1, C25.1, C26.1, C33.1, C35.1, C40.1, C47.1, C48.1, C49.1, C50.1, R10.1, R36.1, TP9.1, U2.6 (OUT), U3.3 (~MR), U3.6 (VDD), U4.10 (AVIN), U4.11 (PVIN), U4.12 (PVIN), U5.7 (VIN), U7.1 (IN), U11.3 (~MR), U11.6 (VDD)
/Power and monitoring/AUX_BOOT1: C28.1, U5.20 (BOOT1)
/Power and monitoring/AUX_BOOT2: C29.1, U5.19 (BOOT2)
/Power and monitoring/AUX_COMP: C37.1, R17.1, U5.15 (COMP)
/Power and monitoring/AUX_COMP_C: C36.1, R17.2
/Power and monitoring/AUX_DVDT: C38.1, U6.18 (dVdT)
/Power and monitoring/AUX_FB: R14.2, R15.1, U5.14 (FB)
/Power and monitoring/AUX_FSW: R16.1, U5.6 (FSW)
/Power and monitoring/AUX_HEALTH: R34.2, U6.20 (~FLT), U8.5 (2C), U10.1 (OUTA)
/Power and monitoring/AUX_HEALTH_SENSE: R31.2, R32.1, U10.3 (INA+)
/Power and monitoring/AUX_ILIM: R18.1, U6.17 (ILIM)
/Power and monitoring/AUX_IMON: R23.1, U6.19 (IMON)
/Power and monitoring/AUX_OV: R21.2, R22.1, U6.15 (OVP)
/Power and monitoring/AUX_PGTH: R24.2, R25.1, U6.3 (PGTH)
/Power and monitoring/AUX_SW1: C28.2, L2.1, U5.8 (SW1)
/Power and monitoring/AUX_SW2: C29.2, L2.2, U5.10 (SW2)
/Power and monitoring/AUX_UV: R19.2, R20.1, U6.14 (EN/UVLO)
/Power and monitoring/AUX_VCC: C34.1, U5.2 (MODE), U5.18 (VCC)
/Power and monitoring/INPUT_HEALTH: R33.2, U2.4 (~FLT), U8.2 (1B), U8.4 (2B), U9.1 (OUTA)
/Power and monitoring/INPUT_HEALTH_SENSE: R29.2, R30.1, U9.3 (INA+)
/Power and monitoring/IN_AUXOFF: R28.2, R29.1, U2.3 (AUXOFF)
/Power and monitoring/IN_DVDT: R7.1, U2.7 (dVdt)
/Power and monitoring/IN_DVDT_C: C20.1, R7.2
/Power and monitoring/IN_ILM: R6.1, U2.9 (ILM)
/Power and monitoring/IN_OV: R4.2, R5.1, U2.2 (OVLO)
/Power and monitoring/IN_UV: R2.2, R3.1, U2.1 (EN/UVLO)
/Power and monitoring/MAIN_FB: R11.2, R12.1, U4.5 (FB)
/Power and monitoring/MAIN_PG: R13.2, U4.4 (PG), U8.1 (1A), U8.3 (2A)
/Power and monitoring/MAIN_SS: C27.1, U4.9 (SS/TR)
/Power and monitoring/MAIN_SW: L1.1, U4.1 (SW), U4.2 (SW), U4.3 (SW)
/Power and monitoring/POWER_RUN: R10.2, U3.1 (~RESET), U4.13 (EN), U5.1 (EN/UVLO), U11.1 (~RESET)
/Power and monitoring/PROT_SENSE: R36.2, R37.1, U11.5 (SENSE)
/Power and monitoring/PWR_STATUS: R35.1, TP14.1, U8.6 (2Y); also elsewhere on the board
/Power and monitoring/SENS_EN: R26.1, U7.3 (EN), U8.12 (1Y)
/Power and monitoring/SENS_NR: C42.1, U7.4 (NR)
/Power and monitoring/START_SENSE: R8.2, R9.1, U3.5 (SENSE)

Notes on the sheet:
FC FC REV A | POWER TREE / PROTECTION / MONITORING | R18
RECOMMENDATION CAPTURE - OPEN / UNTESTED. Physical SOA, stability, EMI, thermal and transients: coupon / Stages 11-13.
01 | POWER1 PROTECTION + HARDWARE STARTUP
Both sources valid + 12..28ms holdoff. RUN controls rails only; never NRST.
02 | 3V3_MAIN - 3A BUCK / 1.5A CONTINUOUS
FSW high: ~1.25MHz; power-save at light load. SS ~47..58ms.
03 | AUX BUCK-BOOST - LOCAL FEEDBACK BEFORE SWITCH
Pin21 EXTVCC left open: internal LDO. MODE=VCC. CDC open.
04 | 5V_AUX - 1A TOTAL / LATCH-OFF LIMITER
AUX load: OpenRX <=0.5A; all other modules share <=0.5A.
680uF effective total POST-switch (includes board cap).
Ramp ~34..54ms; persistent thermal fault latches.
25mOhm boundary path budget at 1A.
No camera/lidar load on FC.
05 | QUIET SENSOR / ANALOG RAILS + ACCESS
SENS_EN = MAIN_PG AND INPUT_HEALTH (U8).
Source removal disables LDO before stored input decays.
Verify abrupt shorts / comparator delays on coupon.
FB1 populated OR R27 only (DNP). Common continuous GND.
3V3_SENS: 25/50mA; reserve100mA. 400mA low-noise RCB LDO.
VBAT_SENSE remains DNP: no conditioning / external conductor.
06 | INFORMATIONAL FAIL-LOW PWR_STATUS
Schmitt inputs. Main PG AND input health AND AUX health; finite delay.
POWER1: physical 1=5V A, 2=GND A, 3=5V B, 4=GND B. 5/6: NO cable terminals; header tails in NPTH clearance holes; NO copper. 43025-0600 housing; 43030-0038 terminals, 18 AWG. RECOMMENDATION / fit, crimp, strain relief and thermal validation OPEN.
