desanv01/Flight-Controller-V1/fabrication/jlcpcb/source/hardware/FC_REV_A.kicad_pcb

## KiCad design fabrication/jlcpcb/source/hardware/FC_REV_A.kicad_pcb (continued)

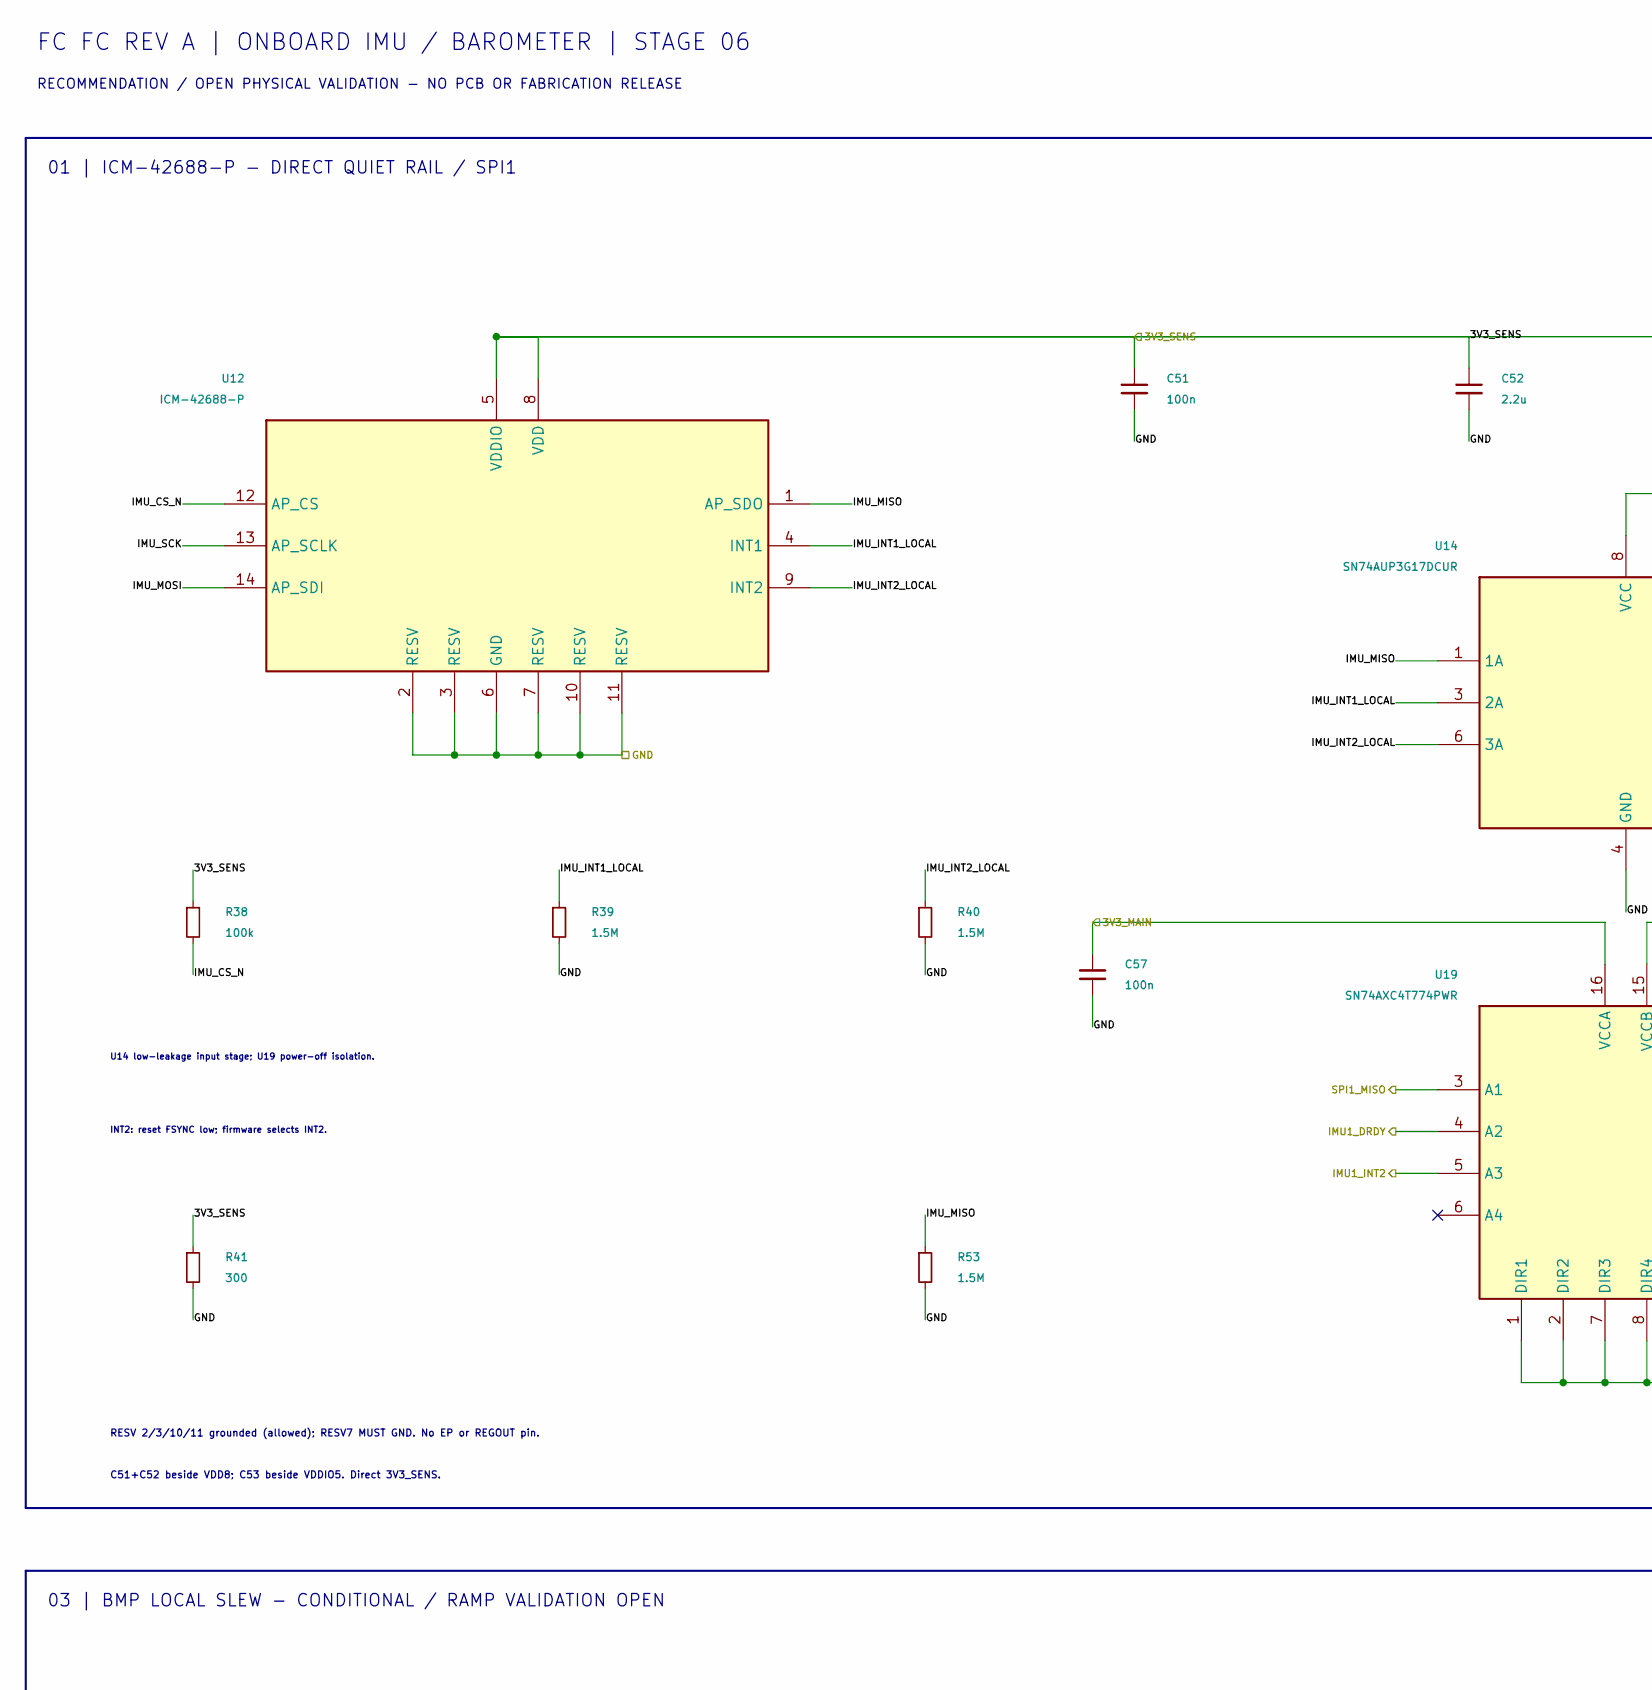
[picture p18: schematic 03_sensors.kicad_sch, FC FC Rev A - IMU / barometer, part in row 1, column 1]

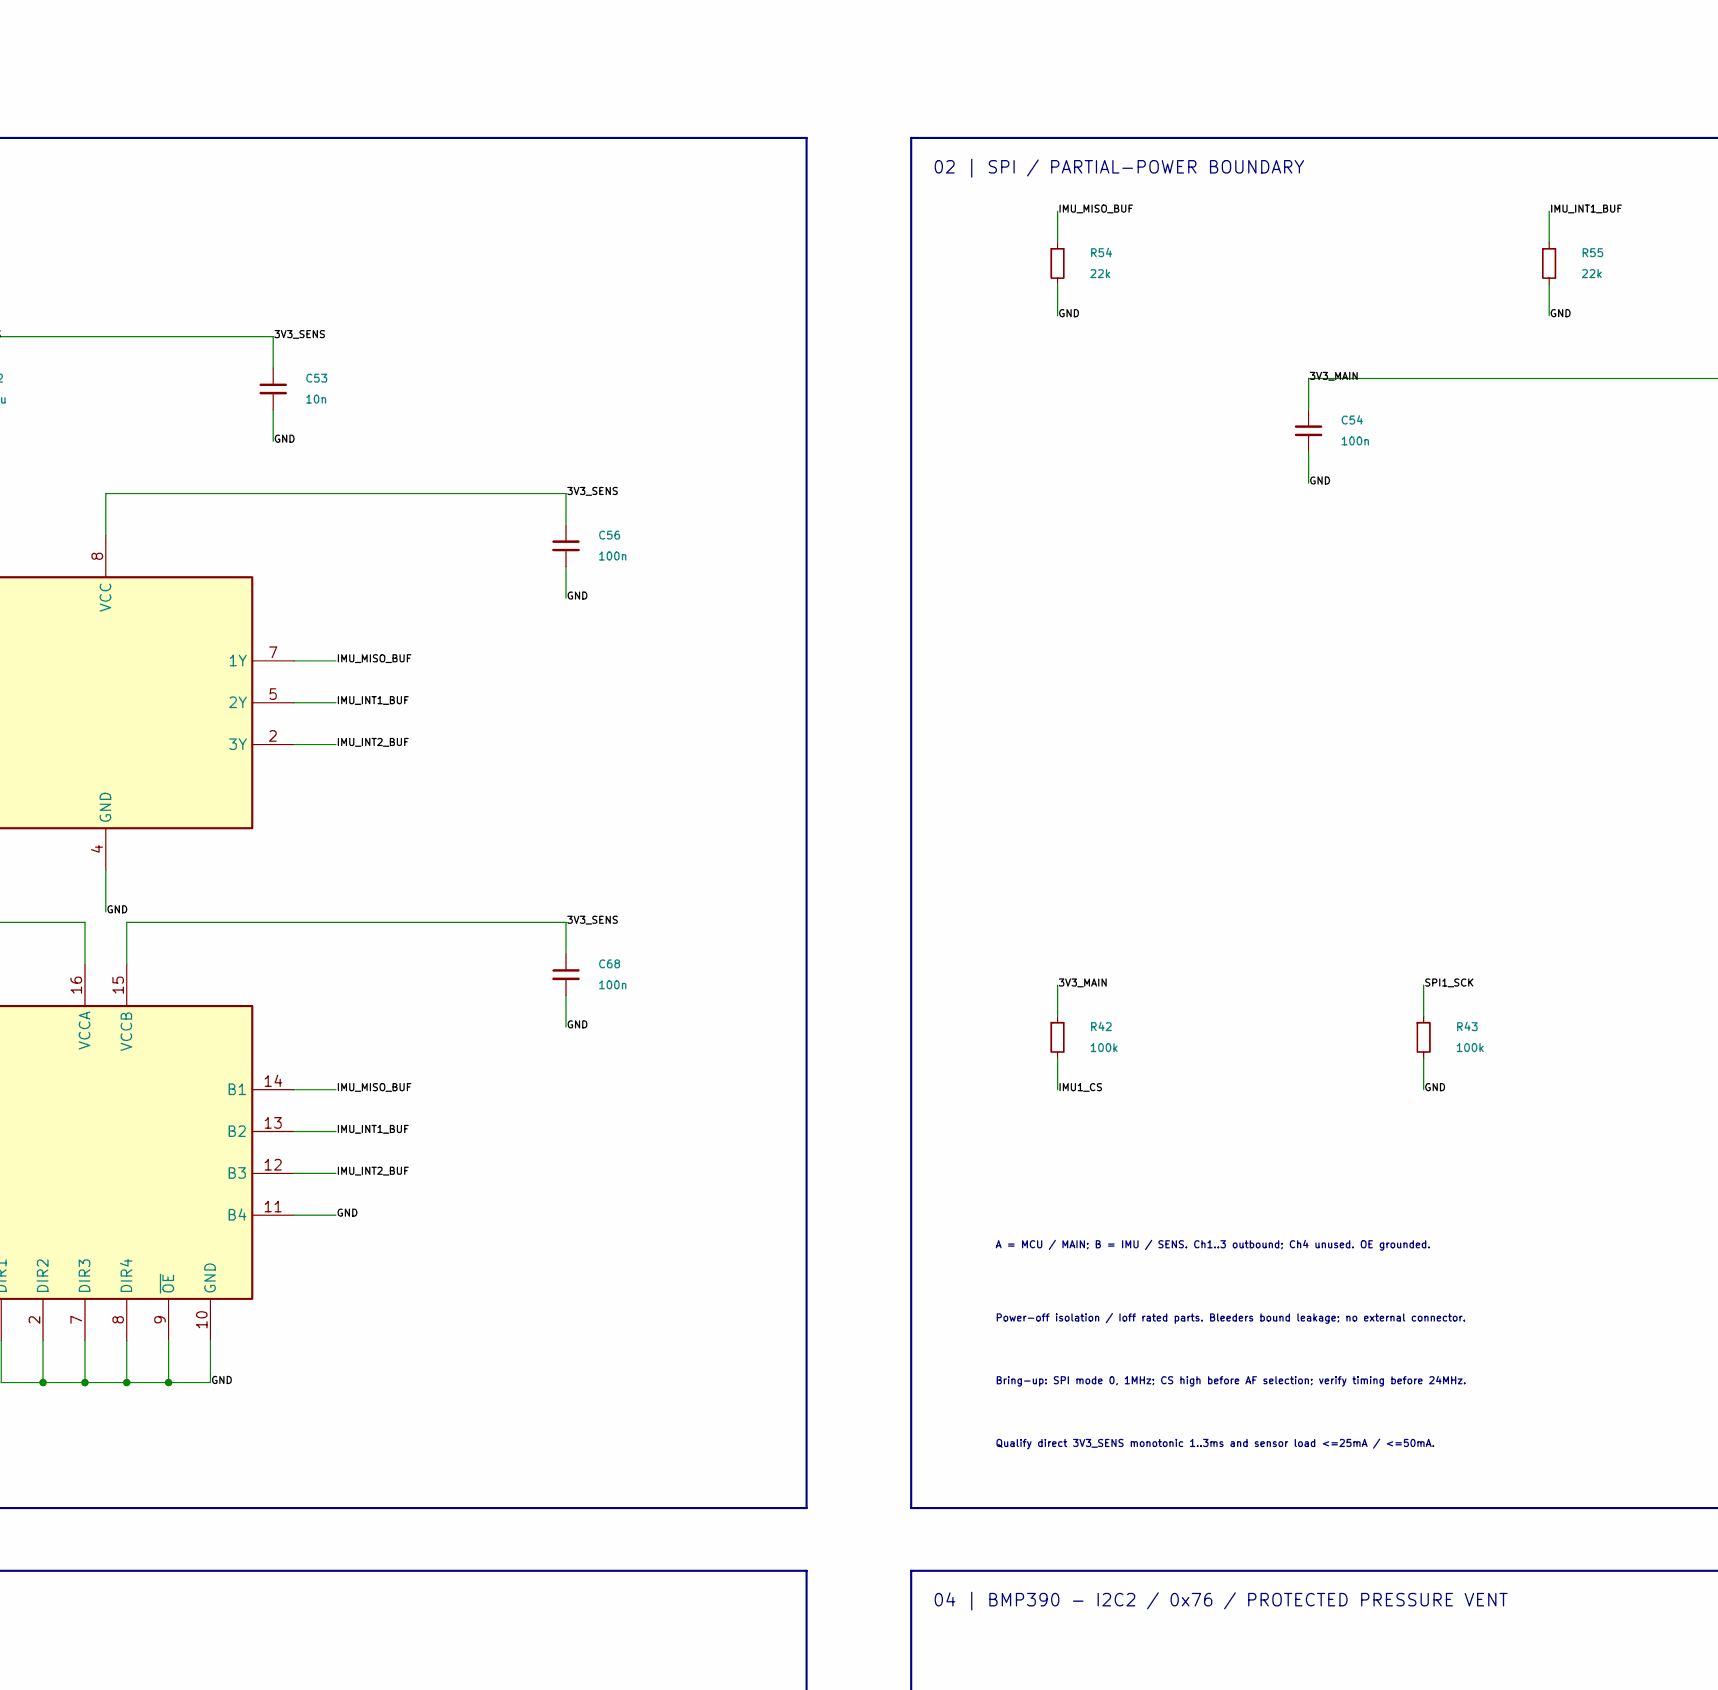
[picture p19: schematic 03_sensors.kicad_sch, FC FC Rev A - IMU / barometer, part in row 1, column 2]

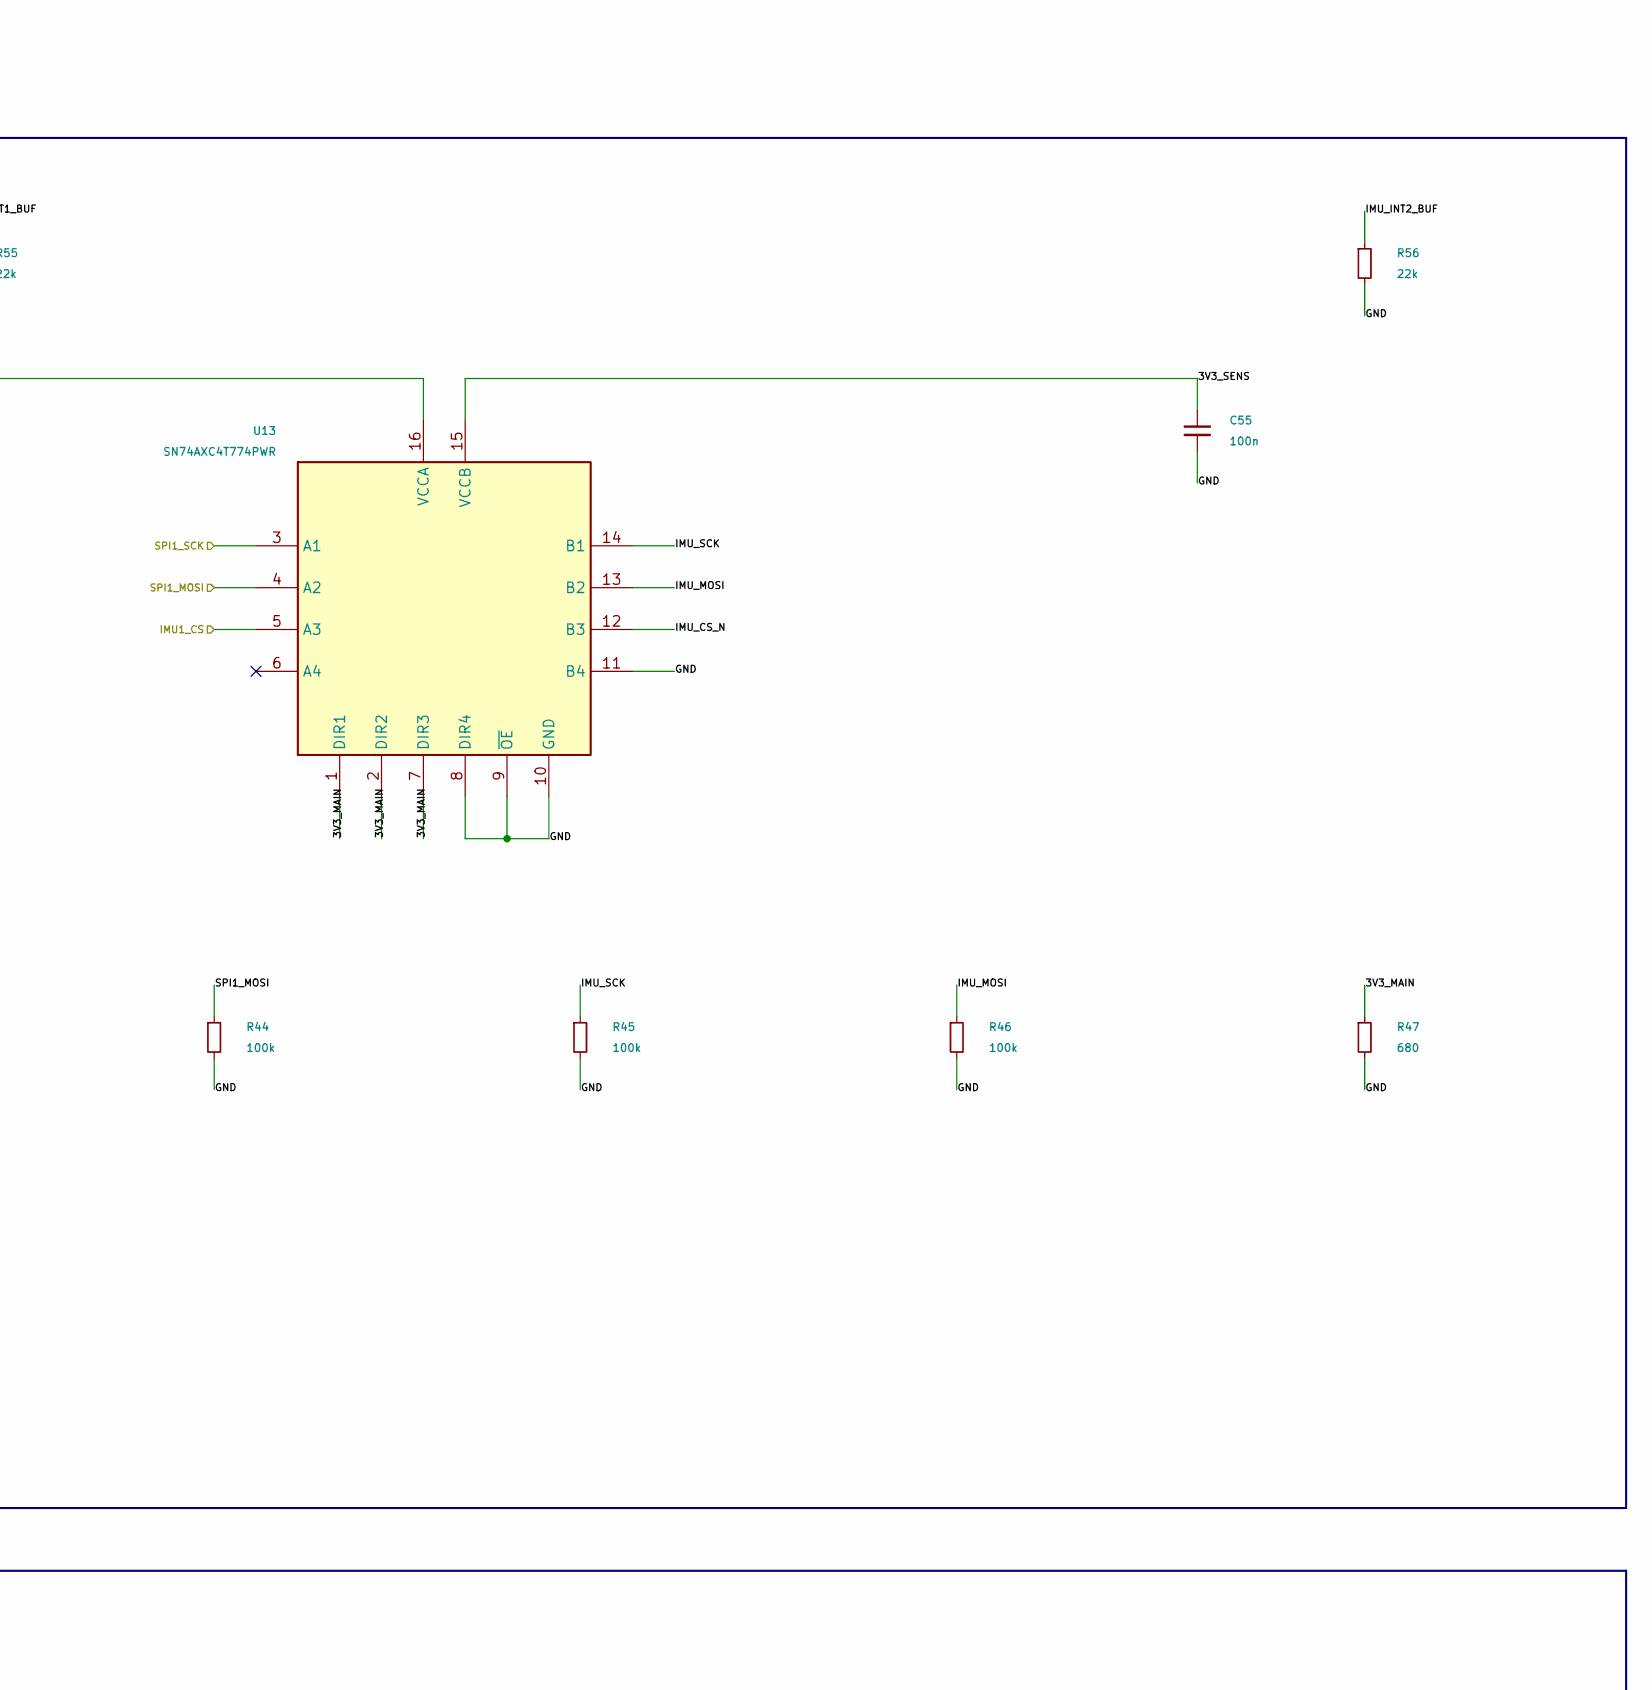
[picture p20: schematic 03_sensors.kicad_sch, FC FC Rev A - IMU / barometer, part in row 1, column 3]

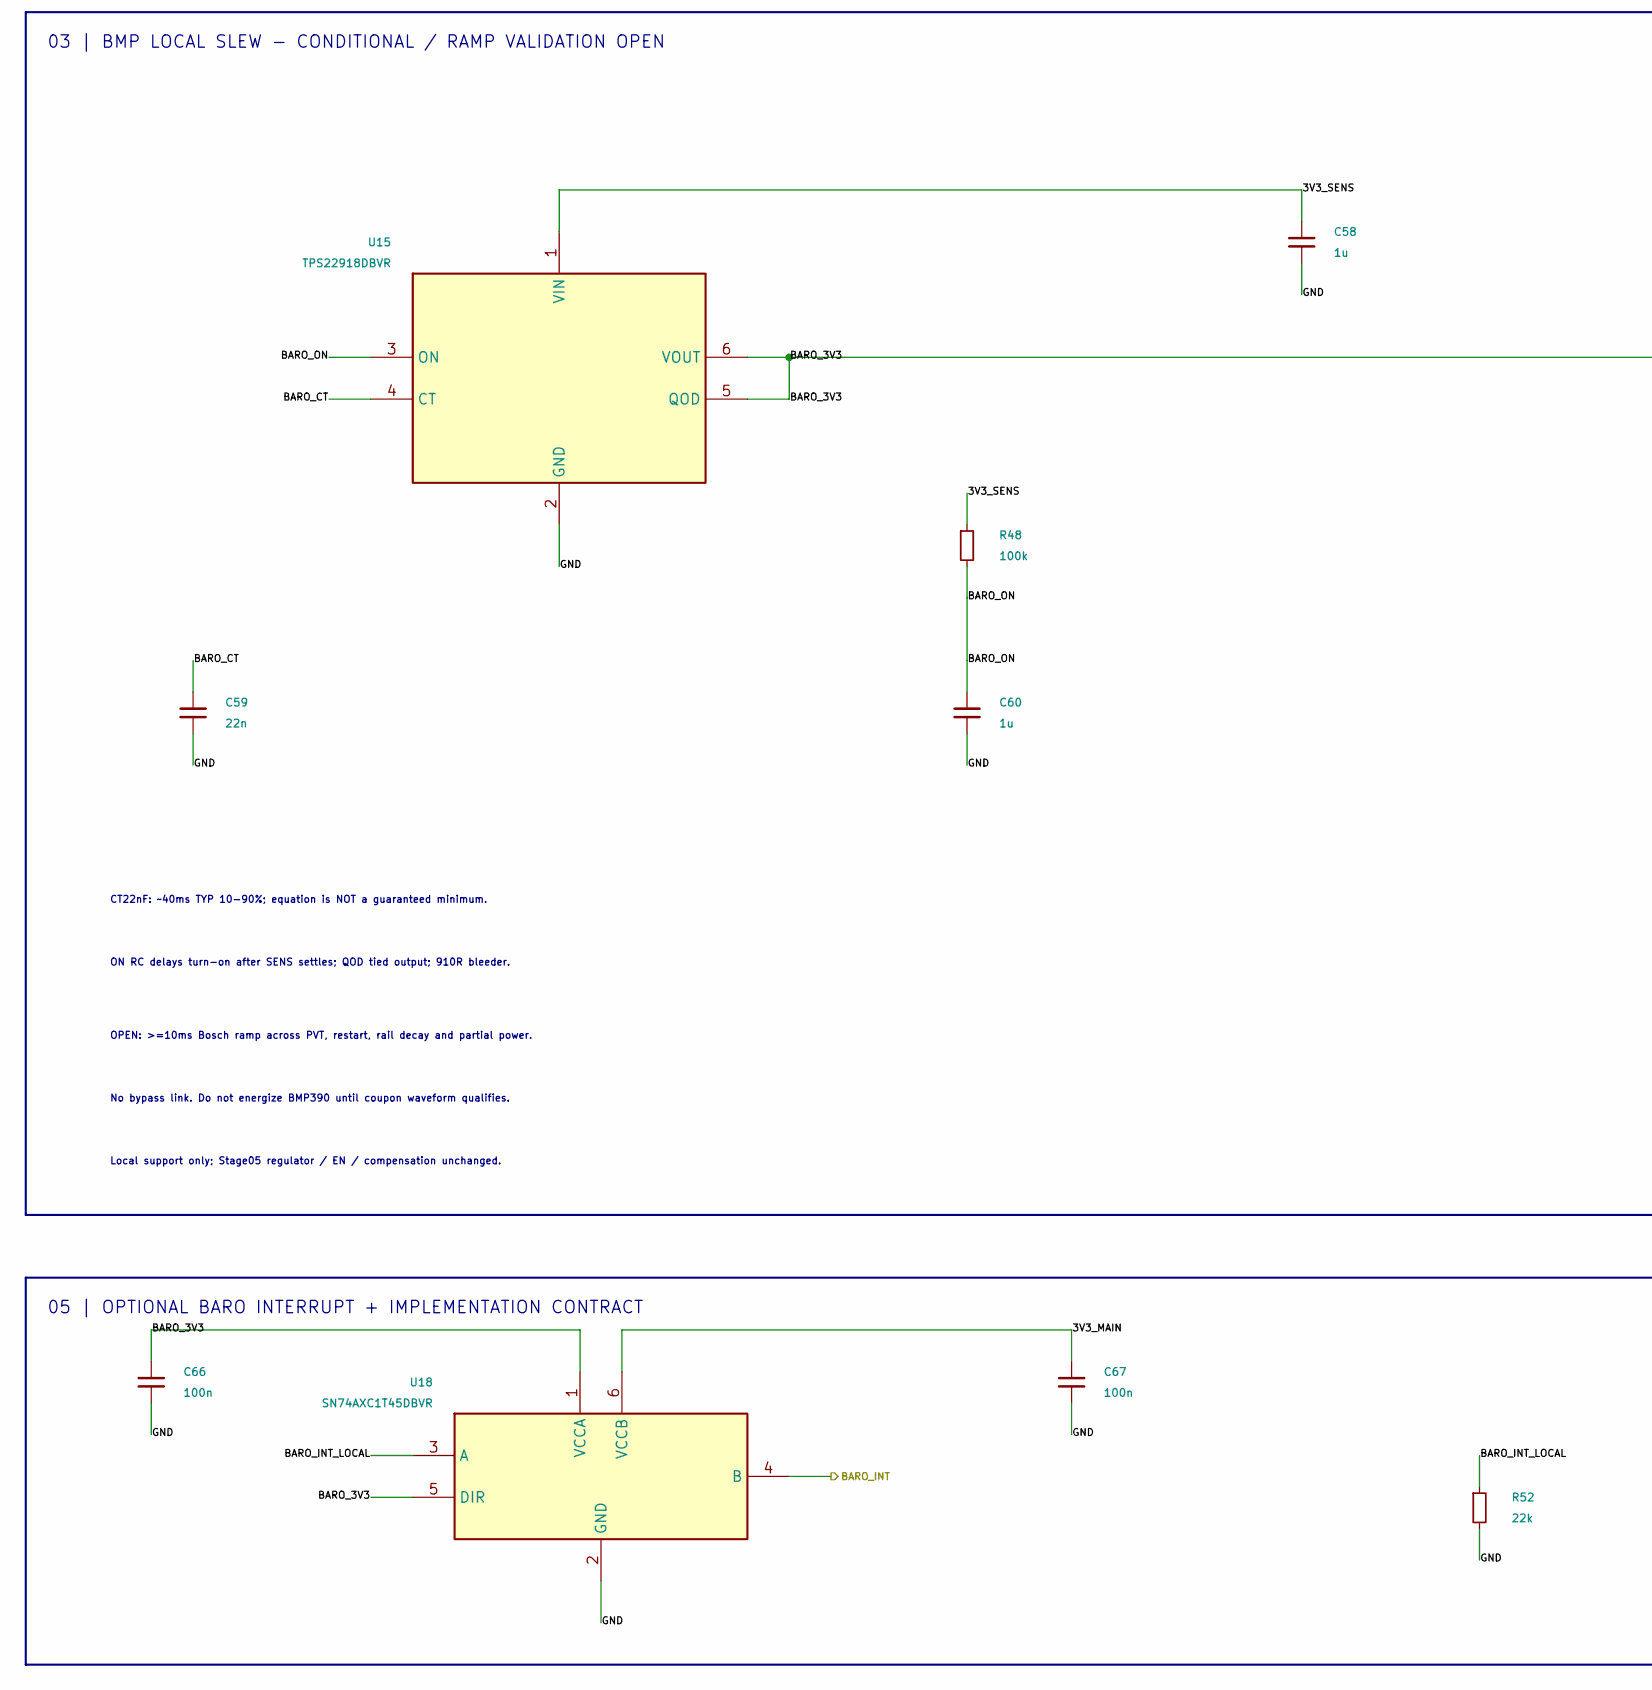
[picture p21: schematic 03_sensors.kicad_sch, FC FC Rev A - IMU / barometer, part in row 2, column 1]

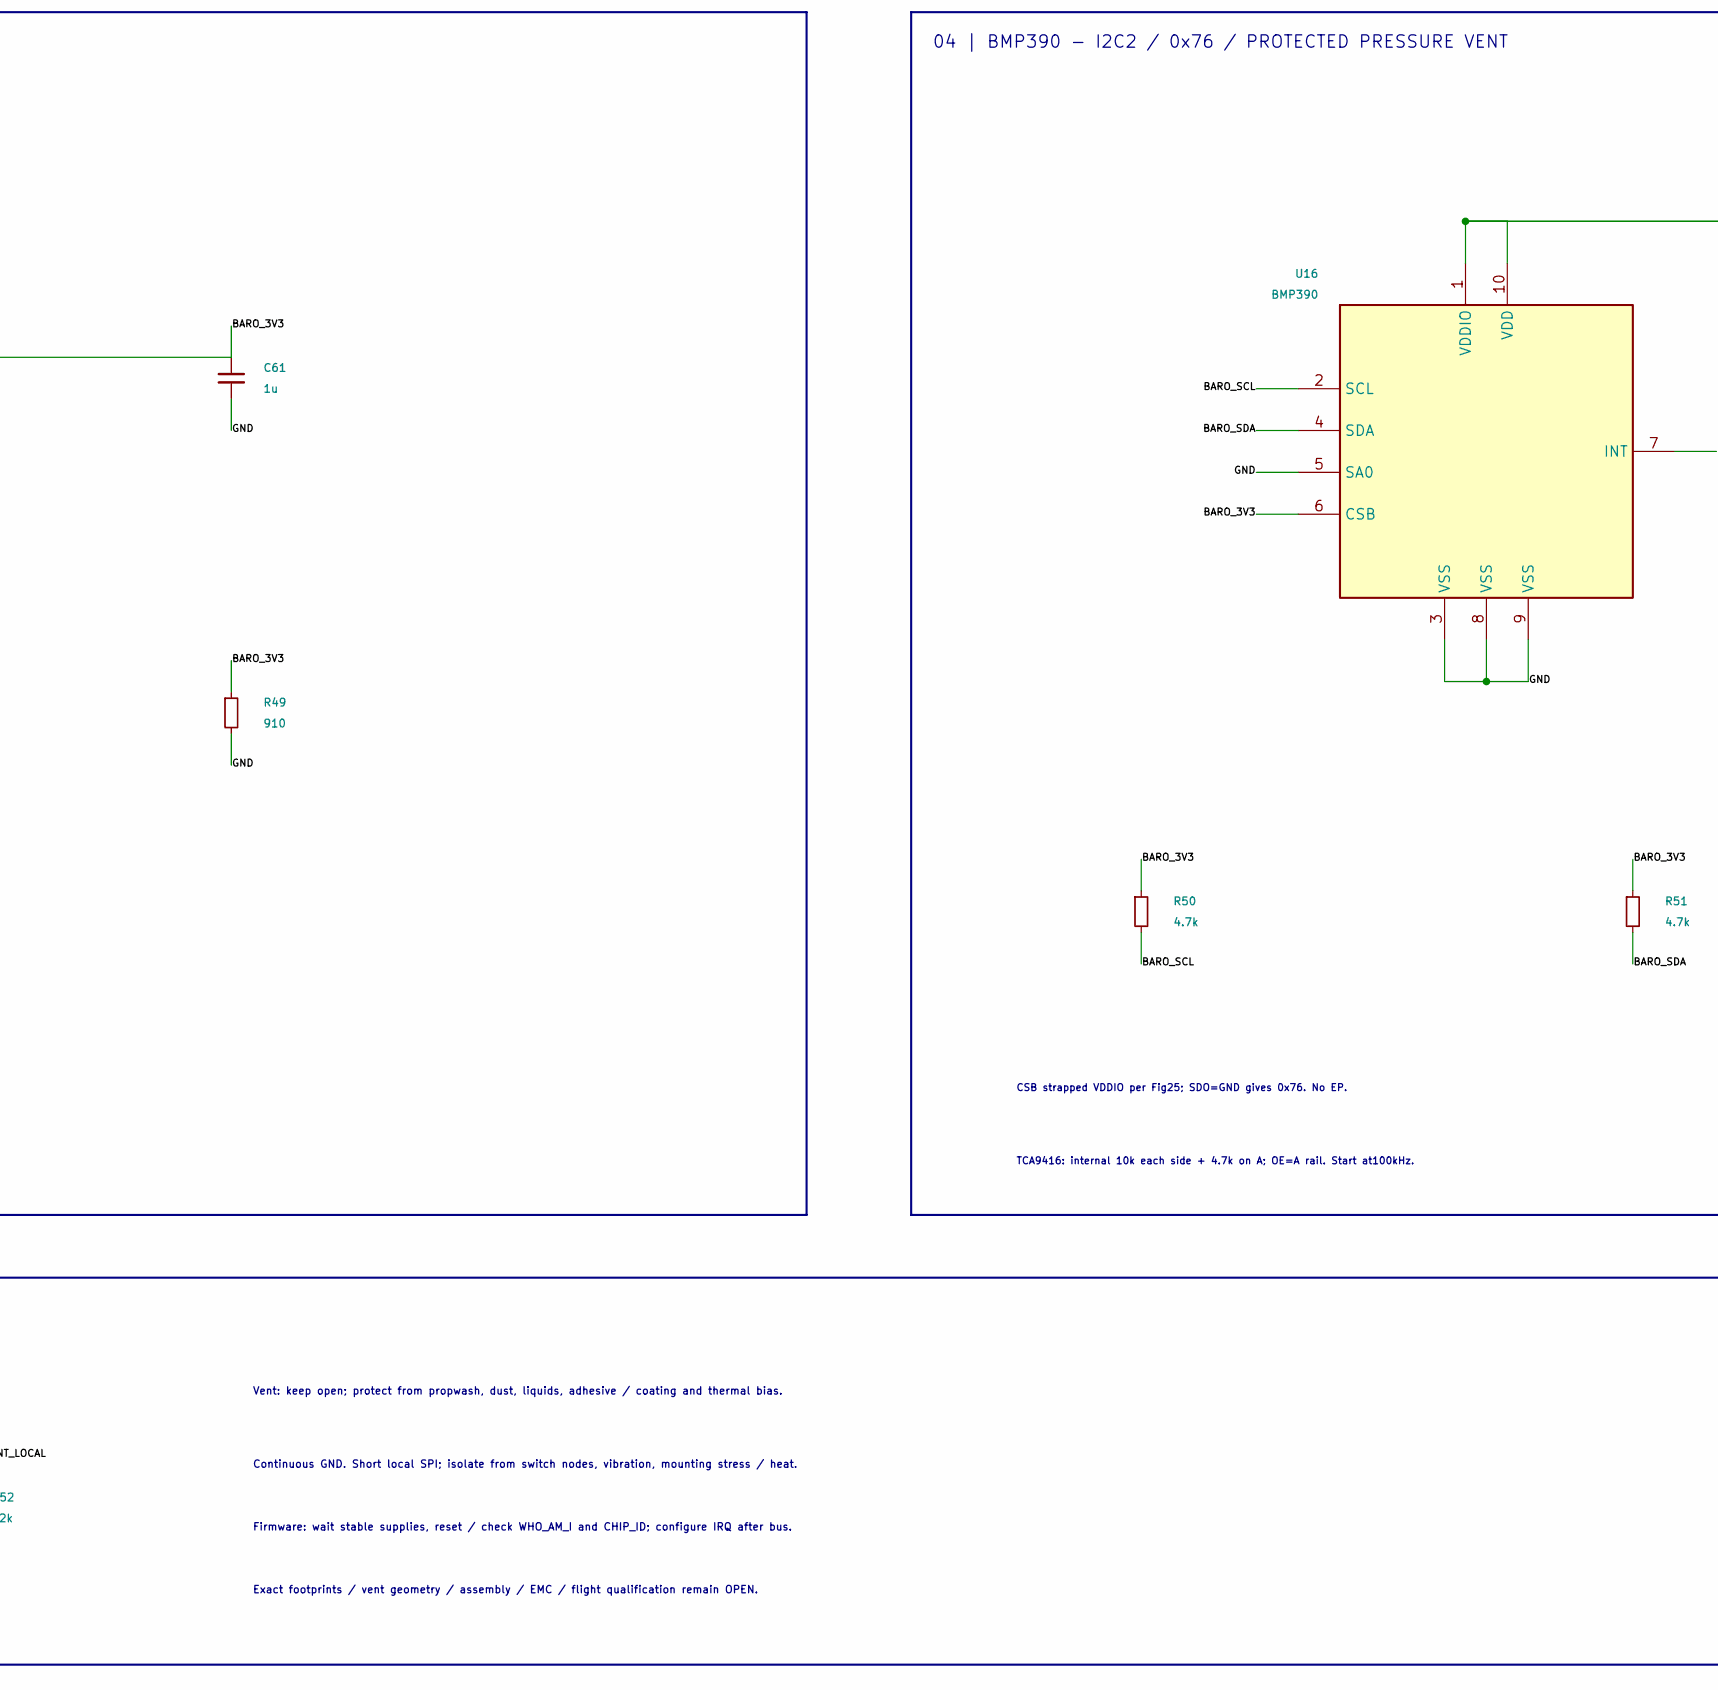
[picture p22: schematic 03_sensors.kicad_sch, FC FC Rev A - IMU / barometer, part in row 2, column 2]

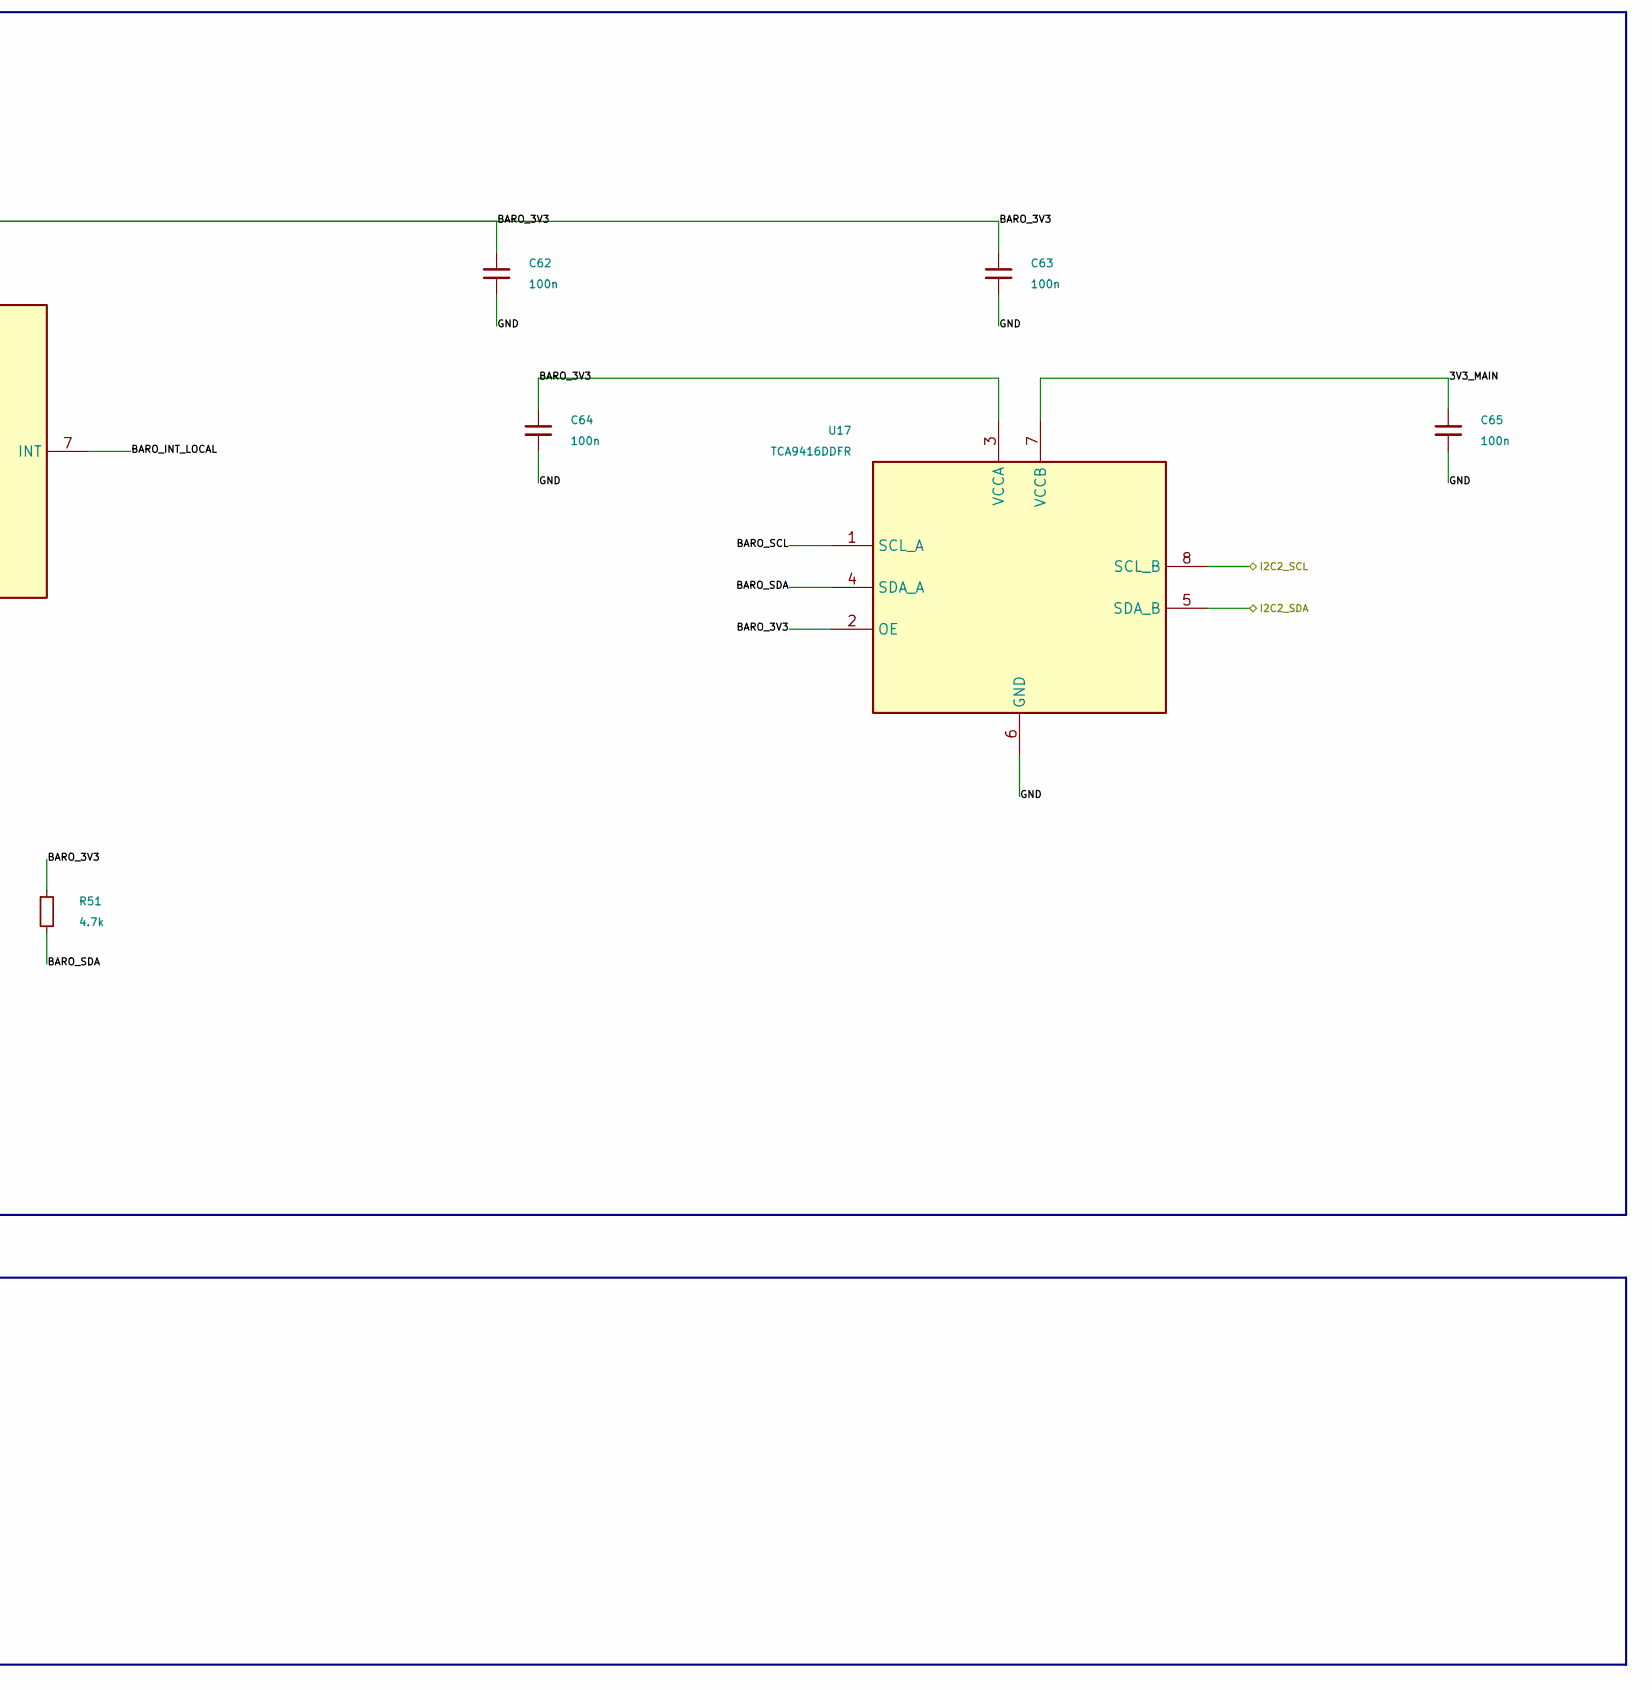
[picture p23: schematic 03_sensors.kicad_sch, FC FC Rev A - IMU / barometer, part in row 2, column 3]

Parts:
C51, C54, C55, C56, C57, C62, C63, C64, C65, C66, C67, C68: 100n; Capacitor_SMD__C_0603_1608Metric; MPN GRM188R71H104KA93D
C52: 2.2u; Capacitor_SMD__C_1206_3216Metric; MPN GRM31CR71H225KA88L
C53: 10n; Capacitor_SMD__C_0603_1608Metric; MPN GRM188R71H103KA01D
C58, C60, C61: 1u; Capacitor_SMD__C_1206_3216Metric; MPN GRM31CR71H105KA61L
C59: 22n; Capacitor_SMD__C_1206_3216Metric; MPN C1206C223J5GACTU
R38, R42, R43, R44, R45, R46, R48: 100k; Resistor_SMD__R_0603_1608Metric; MPN RC0603FR-07100KL
R39, R40, R53: 1.5M; Resistor_SMD__R_0603_1608Metric; MPN RC0603FR-071M5L
R41: 300; Resistor_SMD__R_0603_1608Metric; MPN RC0603FR-07300RL
R47: 680; Resistor_SMD__R_0603_1608Metric; MPN RC0603FR-07680RL
R49: 910; Resistor_SMD__R_0603_1608Metric; MPN RC0603FR-07910RL
R50, R51: 4.7k; Resistor_SMD__R_0603_1608Metric; MPN RC0603FR-074K7L
R52, R54, R55, R56: 22k; Resistor_SMD__R_0603_1608Metric; MPN RC0603FR-0722KL
U12: ICM-42688-P; TDK_ICM42688P_LGA14_3x2.5; MPN ICM-42688-P
U13, U19: SN74AXC4T774PWR; Package_SO__TSSOP-16_4.4x5mm_P0.65mm; MPN SN74AXC4T774PWR
U14: SN74AUP3G17DCUR; Package_SO__VSSOP-8_2.3x2mm_P0.5mm; MPN SN74AUP3G17DCUR
U15: TPS22918DBVR; Package_TO_SOT_SMD__SOT-23-6; MPN TPS22918DBVR
U16: BMP390; Bosch_BMP390_LGA10_2x2; MPN BMP390
U17: TCA9416DDFR; TI_DDF0008_SOT23THIN_8; MPN TCA9416DDFR
U18: SN74AXC1T45DBVR; Package_TO_SOT_SMD__SOT-23-6; MPN SN74AXC1T45DBVR

Connections:
3V3_REF: C54.1, C57.1, C65.1, C67.1, R42.1, R47.1, U13.1 (DIR1), U13.2 (DIR2), U13.7 (DIR3), U13.16 (VCCA), U17.7 (VCCB), U18.6 (VCCB), U19.16 (VCCA); also elsewhere on the board
/3V3_SENS: C51.1, C52.1, C53.1, C55.1, C56.1, C58.1, C68.1, R38.1, R41.1, R48.1, U12.5 (VDDIO), U12.8 (VDD), U13.15 (VCCB), U14.8 (VCC), U15.1 (VIN), U19.15 (VCCB); also elsewhere on the board
/GND: C51.2, C52.2, C53.2, C54.2, C55.2, C56.2, C57.2, C58.2, C59.2, C60.2, C61.2, C62.2, C63.2, C64.2, C65.2, C66.2, C67.2, C68.2, R39.2, R40.2, R41.2, R43.2, R44.2, R45.2, R46.2, R47.2, R49.2, R52.2, R53.2, R54.2, R55.2, R56.2, U12.2 (RESV), U12.3 (RESV), U12.6 (GND), U12.7 (RESV), U12.10 (RESV), U12.11 (RESV), U13.8 (DIR4), U13.9 (~OE), U13.10 (GND), U13.11 (B4), U14.4 (GND), U15.2 (GND), U16.3 (VSS), U16.5 (SA0), U16.8 (VSS), U16.9 (VSS), U17.6 (GND), U18.2 (GND), U19.1 (DIR1), U19.2 (DIR2), U19.7 (DIR3), U19.8 (DIR4), U19.9 (~OE), U19.10 (GND), U19.11 (B4); also elsewhere on the board
/Local sensors/BARO_3V3: C61.1, C62.1, C63.1, C64.1, C66.1, R49.1, R50.1, R51.1, U15.5 (QOD), U15.6 (VOUT), U16.1 (VDDIO), U16.6 (CSB), U16.10 (VDD), U17.2 (OE), U17.3 (VCCA), U18.1 (VCCA), U18.5 (DIR)
/Local sensors/BARO_CT: C59.1, U15.4 (CT)
/Local sensors/BARO_INT_LOCAL: R52.1, U16.7 (INT), U18.3 (A)
/Local sensors/BARO_ON: C60.1, R48.2, U15.3 (ON)
/Local sensors/BARO_SCL: R50.2, U16.2 (SCL), U17.1 (SCL_A)
/Local sensors/BARO_SDA: R51.2, U16.4 (SDA), U17.4 (SDA_A)
/Local sensors/IMU1_CS: R42.2, U13.5 (A3); also elsewhere on the board
/Local sensors/IMU_CS_N: R38.2, U12.12 (AP_CS), U13.12 (B3)
/Local sensors/IMU_INT1_BUF: R55.1, U14.5 (2Y), U19.13 (B2)
/Local sensors/IMU_INT1_LOCAL: R39.1, U12.4 (INT1), U14.3 (2A)
/Local sensors/IMU_INT2_BUF: R56.1, U14.2 (3Y), U19.12 (B3)
/Local sensors/IMU_INT2_LOCAL: R40.1, U12.9 (INT2), U14.6 (3A)
/Local sensors/IMU_MISO: R53.1, U12.1 (AP_SDO), U14.1 (1A)
/Local sensors/IMU_MISO_BUF: R54.1, U14.7 (1Y), U19.14 (B1)
/Local sensors/IMU_MOSI: R46.1, U12.14 (AP_SDI), U13.13 (B2)
/Local sensors/IMU_SCK: R45.1, U12.13 (AP_SCLK), U13.14 (B1)
/Local sensors/SPI1_MOSI: R44.1, U13.4 (A2); also elsewhere on the board
/Local sensors/SPI1_SCK: R43.1, U13.3 (A1); also elsewhere on the board
/STM32H743 core/BARO_INT: U18.4 (B); also elsewhere on the board
/STM32H743 core/I2C2_SCL: U17.8 (SCL_B); also elsewhere on the board
/STM32H743 core/I2C2_SDA: U17.5 (SDA_B); also elsewhere on the board
/STM32H743 core/IMU1_DRDY: U19.4 (A2); also elsewhere on the board
/STM32H743 core/IMU1_INT2: U19.5 (A3); also elsewhere on the board
/STM32H743 core/SPI1_MISO: U19.3 (A1); also elsewhere on the board

Notes on the sheet:
FC FC REV A | ONBOARD IMU / BAROMETER | STAGE 06
RECOMMENDATION / OPEN PHYSICAL VALIDATION - NO PCB OR FABRICATION RELEASE
01 | ICM-42688-P - DIRECT QUIET RAIL / SPI1
U14 low-leakage input stage; U19 power-off isolation.
INT2: reset FSYNC low; firmware selects INT2.
RESV 2/3/10/11 grounded (allowed); RESV7 MUST GND. No EP or REGOUT pin.
C51+C52 beside VDD8; C53 beside VDDIO5. Direct 3V3_SENS.
02 | SPI / PARTIAL-POWER BOUNDARY
A = MCU / MAIN; B = IMU / SENS. Ch1..3 outbound; Ch4 unused. OE grounded.
Power-off isolation / Ioff rated parts. Bleeders bound leakage; no external connector.
Bring-up: SPI mode 0, 1MHz; CS high before AF selection; verify timing before 24MHz.
Qualify direct 3V3_SENS monotonic 1..3ms and sensor load <=25mA / <=50mA.
03 | BMP LOCAL SLEW - CONDITIONAL / RAMP VALIDATION OPEN
CT22nF: ~40ms TYP 10-90%; equation is NOT a guaranteed minimum.
ON RC delays turn-on after SENS settles; QOD tied output; 910R bleeder.
OPEN: >=10ms Bosch ramp across PVT, restart, rail decay and partial power.
No bypass link. Do not energize BMP390 until coupon waveform qualifies.
Local support only; Stage05 regulator / EN / compensation unchanged.
04 | BMP390 - I2C2 / 0x76 / PROTECTED PRESSURE VENT
CSB strapped VDDIO per Fig25; SDO=GND gives 0x76. No EP.
TCA9416: internal 10k each side + 4.7k on A; OE=A rail. Start at100kHz.
05 | OPTIONAL BARO INTERRUPT + IMPLEMENTATION CONTRACT
Vent: keep open; protect from propwash, dust, liquids, adhesive / coating and thermal bias.
Continuous GND. Short local SPI; isolate from switch nodes, vibration, mounting stress / heat.
Firmware: wait stable supplies, reset / check WHO_AM_I and CHIP_ID; configure IRQ after bus.
Exact footprints / vent geometry / assembly / EMC / flight qualification remain OPEN.

Schematic: 04_esc.kicad_sch, FC FC Rev A Stage07 - esc

Parts:
C69: 100n; Capacitor_SMD__C_0603_1608Metric; MPN GRM188R71H104KA93D
C70: 100n; Capacitor_SMD__C_0603_1608Metric; MPN GRM188R71H104KA93D; not fitted
J1: ESC BENCH: positions 1/4 ABSENT; MPN ESC_SPARSE_BENCH
J2: CURR contact J1-3: DNP; MPN DNP_SERVICE_CONTACT; not fitted
J_ESC_FC: SM05B-SRSS-TB; ESC_JST_SH_SM05B_SRSS_TB; MPN SM05B-SRSS-TB
R57, R59, R60, R62, R63, R65, R66, R68: 47k; Resistor_SMD__R_0603_1608Metric; MPN RC0603FR-0747KL
R58, R61, R64, R67: 0; Resistor_SMD__R_0603_1608Metric; MPN RC0603JR-070RL
R69: 100k; Resistor_SMD__R_0603_1608Metric; MPN RC0603FR-07100KL; not fitted
R70: 22k; Resistor_SMD__R_0603_1608Metric; MPN RC0603FR-0722KL; not fitted
R71: 1k; Resistor_SMD__R_0603_1608Metric; MPN RC0603FR-071KL; not fitted
U20: TMUX1511PWR; Package_SO__TSSOP-14_4.4x5mm_P0.65mm; MPN TMUX1511PWR; LCSC C2866750
U21: TPD4E05U06DQAR; Package_SON__USON-10_2.5x1.0mm_P0.5mm; MPN TPD4E05U06DQAR; LCSC C138714
U22: TMUX1511PWR; Package_SO__TSSOP-14_4.4x5mm_P0.65mm; MPN TMUX1511PWR; LCSC C2866750; not fitted
U23: TPD4E05U06DQAR; Package_SON__USON-10_2.5x1.0mm_P0.5mm; MPN TPD4E05U06DQAR; LCSC C138714; not fitted

Connections:
3V3_REF: C69.1, C70.1, U20.1 (SEL1), U20.4 (SEL2), U20.10 (SEL3), U20.13 (SEL4), U20.14 (VDD), U22.1 (SEL1), U22.4 (SEL2), U22.10 (SEL3), U22.13 (SEL4), U22.14 (VDD); also elsewhere on the board
/ESC signal boundary/ESC_CURR_FILTER: R69.2, R70.1, U22.2 (S1)
/ESC signal boundary/ESC_CURR_ISO: R71.1, U22.3 (D1)
/ESC signal boundary/ESC_CURR_RAW: J2.1, R69.1, U23.1 (D1+)
/ESC signal boundary/ESC_M1_ISO: R58.1, U20.3 (D1)
/ESC signal boundary/ESC_M1_PORT: J1.5 (M1), J_ESC_FC.2 (M1), R58.2, R59.1, U21.1 (D1+)
/ESC signal boundary/ESC_M2_ISO: R61.1, U20.6 (D2)
/ESC signal boundary/ESC_M2_PORT: J1.6 (M2), J_ESC_FC.3 (M2), R61.2, R62.1, U21.2 (D1-)
/ESC signal boundary/ESC_M3_ISO: R64.1, U20.8 (D3)
/ESC signal boundary/ESC_M3_PORT: J1.7 (M3), J_ESC_FC.4 (M3), R64.2, R65.1, U21.4 (D2+)
/ESC signal boundary/ESC_M4_ISO: R67.1, U20.11 (D4)
/ESC signal boundary/ESC_M4_PORT: J1.8 (M4), J_ESC_FC.5 (M4), R67.2, R68.1, U21.5 (D2-)
/ESC_CURR_DNP: R71.2; also elsewhere on the board
/ESC_M1: R57.1, U20.2 (S1); also elsewhere on the board
/ESC_M2: R60.1, U20.5 (S2); also elsewhere on the board
/ESC_M3: R63.1, U20.9 (S3); also elsewhere on the board
/ESC_M4: R66.1, U20.12 (S4); also elsewhere on the board
/GND: C69.2, C70.2, J1.2 (GND), J_ESC_FC.1 (GND), R57.2, R59.2, R60.2, R62.2, R63.2, R65.2, R66.2, R68.2, R70.2, U20.7 (GND), U21.3 (GND), U21.8 (GND), U22.5 (S2), U22.7 (GND), U22.9 (S3), U22.12 (S4), U23.2 (D1-), U23.3 (GND), U23.4 (D2+), U23.5 (D2-), U23.8 (GND); also elsewhere on the board

Notes on the sheet:
ESC: sparse bench boundary - Stage07 recommendation / OPEN UNTESTED
3.3V logic. No external 5V direct to MCU. No PCB / footprint release / fabrication authority.
Motor signals / bidirectional DShot
Optional current / NOT a safety input
J1 has ONLY 2,5,6,7,8. No 1/4 pins, pads, wires or nets. Controlled interposer <=150mm; flight harness OPEN.
0R series default; evaluate 22R only after bidirectional waveform test. Both sides 47k low. ESC firmware FT pulls OFF.
Entire optional current branch DNP including contact, divider, switch, bypass and protection. PC1 ADC disabled.
Divider recommendation only: verify upstream CURR range/calibration before any population. No safety dependency.
Physical FC connector: 1=GND, 2=M1, 3=M2, 4=M3, 5=M4. Sparse logical J1 retained; J2 current-sense remains DNP / footprintless. NO ESC battery, power or current-sense conductor on this harness. RECOMMENDATION / unpowered continuity and powered bench validation OPEN.
