desanv01/Flight-Controller-V1/fabrication/jlcpcb/source/hardware/FC_REV_A.kicad_pcb

## KiCad design fabrication/jlcpcb/source/hardware/FC_REV_A.kicad_pcb (continued)

Schematic: 05_external_ports.kicad_sch, FC FC Rev A Stage07 - external_ports

Parts:
C71, C72, C73, C74, C75, C76, C77, C78, C79, C80, C81, C82, C85, C87, C88: 100n; Capacitor_SMD__C_0603_1608Metric; MPN GRM188R71H104KA93D
C83, C84, C86: 100n; Capacitor_SMD__C_0603_1608Metric; MPN GRM188R71H104KA93D; not fitted
J3: RC_IN; Connector_JST__JST_GH_BM04B-GHS-TBT_1x04-1MP_P1.25mm_Vertic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; MPN BM04B-GHS-TBT(LF)(SN)
J4: GPS1; Connector_JST__JST_GH_BM08B-GHS-TBT_1x08-1MP_P1.25mm_Vertic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; MPN BM08B-GHS-TBT(LF)(SN)
J5: TELEM1; Connector_JST__JST_GH_BM06B-GHS-TBT_1x06-1MP_P1.25mm_Vertic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; MPN BM06B-GHS-TBT(LF)(SN)
J6: COMPANION; Connector_JST__JST_GH_BM06B-GHS-TBT_1x06-1MP_P1.25mm_Vertic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; MPN BM06B-GHS-TBT(LF)(SN)
R72, R74, R76, R78, R80, R82, R84, R86, R88, R90, R92, R94, R96, R97: 47k; Resistor_SMD__R_0603_1608Metric; MPN RC0603FR-0747KL
R73, R77, R81, R85, R89, R93: 47; Resistor_SMD__R_0603_1608Metric; MPN RC0603FR-0747RL
R75, R79, R83, R87, R91, R95: 22k; Resistor_SMD__R_0603_1608Metric; MPN RC0603FR-0722KL
R98: 22k; Resistor_SMD__R_0603_1608Metric; MPN RC0603FR-0722KL; not fitted
R99: 3.3k; Resistor_SMD__R_0603_1608Metric; MPN RC0603FR-073K3L
U24, U27, U30, U33: SN74LVC2G07DBVR; Package_TO_SOT_SMD__SOT-23-6; MPN SN74LVC2G07DBVR; LCSC C37708
U25, U28, U31, U34: SN74LVC2G34DBVR; Package_TO_SOT_SMD__SOT-23-6; MPN SN74LVC2G34DBVR; LCSC C347589
U26, U29, U32, U35, U43: TPD4E05U06DQAR; Package_SON__USON-10_2.5x1.0mm_P0.5mm; MPN TPD4E05U06DQAR; LCSC C138714
U36, U37, U45: LM66100DCKR; Package_TO_SOT_SMD__SOT-363_SC-70-6; MPN LM66100DCKR; LCSC C2869734
U38: LM66100DCKR; Package_TO_SOT_SMD__SOT-363_SC-70-6; MPN LM66100DCKR; LCSC C2869734; not fitted
U39, U40, U46: TPD1E05U06DYAR; TI_DYA0002_SOD523; MPN TPD1E05U06DYAR
U41: TPD1E05U06DYAR; TI_DYA0002_SOD523; MPN TPD1E05U06DYAR; not fitted
U42: TMUX1511PWR; Package_SO__TSSOP-14_4.4x5mm_P0.65mm; MPN TMUX1511PWR; LCSC C2866750
U44: SN74LVC2G34DBVR; Package_TO_SOT_SMD__SOT-23-6; MPN SN74LVC2G34DBVR; LCSC C347589; not fitted

Connections:
3V3_REF: C71.1, C72.1, C73.1, C74.1, C75.1, C76.1, C77.1, C78.1, C85.1, C86.1, C87.1, R72.1, R76.1, R80.1, R84.1, R88.1, R92.1, U24.3 (2A), U24.5 (VCC), U25.5 (VCC), U27.3 (2A), U27.5 (VCC), U28.5 (VCC), U30.5 (VCC), U31.5 (VCC), U33.5 (VCC), U34.5 (VCC), U42.1 (SEL1), U42.4 (SEL2), U42.10 (SEL3), U42.13 (SEL4), U42.14 (VDD), U44.5 (VCC), U45.1 (VIN); also elsewhere on the board
/5V_AUX: C79.1, C81.1, C83.1, U36.1 (VIN), U37.1 (VIN), U38.1 (VIN); also elsewhere on the board
/COMPANION_CTS: R95.1, U34.4 (2Y); also elsewhere on the board
/COMPANION_RTS: R92.2, U33.3 (2A); also elsewhere on the board
/COMPANION_RX: R91.1, U34.6 (1Y); also elsewhere on the board
/COMPANION_TX: R88.2, U33.1 (1A); also elsewhere on the board
/External UART and I2C ports/COMPANION_CTS_PORT: J6.5, R94.1, U34.3 (2A), U35.5 (D2-)
/External UART and I2C ports/COMPANION_RTS_OD: R93.1, U33.4 (2Y)
/External UART and I2C ports/COMPANION_RTS_PORT: J6.6, R93.2, U35.4 (D2+)
/External UART and I2C ports/COMPANION_RX_PORT: J6.4, R90.1, U34.1 (1A), U35.2 (D1-)
/External UART and I2C ports/COMPANION_TX_OD: R89.1, U33.6 (1Y)
/External UART and I2C ports/COMPANION_TX_PORT: J6.3, R89.2, U35.1 (D1+)
/External UART and I2C ports/COMP_REF_BLOCK: C88.1, R99.1, U45.3 (~CE), U45.6 (VOUT)
/External UART and I2C ports/COMP_REF_OUT: J6.1, R99.2, U46.1 (I/O)
/External UART and I2C ports/GPS1_PPS_PORT: J4.7, U43.4 (D2+), U44.1 (1A)
/External UART and I2C ports/GPS1_RX_PORT: J4.4, R78.1, U28.1 (1A), U29.2 (D1-)
/External UART and I2C ports/GPS1_SCL_PORT: J4.5, U42.3 (D1), U43.1 (D1+)
/External UART and I2C ports/GPS1_SDA_PORT: J4.6, U42.6 (D2), U43.2 (D1-)
/External UART and I2C ports/GPS1_TX_OD: R77.1, U27.6 (1Y)
/External UART and I2C ports/GPS1_TX_PORT: J4.3, R77.2, U29.1 (D1+)
/External UART and I2C ports/GPS_5V_OUT: C82.1, J4.1, U37.3 (~CE), U37.6 (VOUT), U40.1 (I/O)
/External UART and I2C ports/RC_5V_OUT: C80.1, J3.1, U36.3 (~CE), U36.6 (VOUT), U39.1 (I/O)
/External UART and I2C ports/RC_IN_RX_PORT: J3.4, R74.1, U25.1 (1A), U26.2 (D1-)
/External UART and I2C ports/RC_IN_TX_OD: R73.1, U24.6 (1Y)
/External UART and I2C ports/RC_IN_TX_PORT: J3.3, R73.2, U26.1 (D1+)
/External UART and I2C ports/TELEM1_CTS_PORT: J5.5, R86.1, U31.3 (2A), U32.5 (D2-)
/External UART and I2C ports/TELEM1_RTS_OD: R85.1, U30.4 (2Y)
/External UART and I2C ports/TELEM1_RTS_PORT: J5.6, R85.2, U32.4 (D2+)
/External UART and I2C ports/TELEM1_RX_PORT: J5.4, R82.1, U31.1 (1A), U32.2 (D1-)
/External UART and I2C ports/TELEM1_TX_OD: R81.1, U30.6 (1Y)
/External UART and I2C ports/TELEM1_TX_PORT: J5.3, R81.2, U32.1 (D1+)
/External UART and I2C ports/TELEM_5V_OUT: C84.1, J5.1, U38.3 (~CE), U38.6 (VOUT), U41.1 (I/O)
/GND: C71.2, C72.2, C73.2, C74.2, C75.2, C76.2, C77.2, C78.2, C79.2, C80.2, C81.2, C82.2, C83.2, C84.2, C85.2, C86.2, C87.2, C88.2, J3.2, J4.2, J5.2, J6.2, R74.2, R75.2, R78.2, R79.2, R82.2, R83.2, R86.2, R87.2, R90.2, R91.2, R94.2, R95.2, R96.2, R97.2, R98.2, U24.2 (GND), U25.2 (GND), U25.3 (2A), U26.3 (GND), U26.4 (D2+), U26.5 (D2-), U26.8 (GND), U27.2 (GND), U28.2 (GND), U28.3 (2A), U29.3 (GND), U29.4 (D2+), U29.5 (D2-), U29.8 (GND), U30.2 (GND), U31.2 (GND), U32.3 (GND), U32.8 (GND), U33.2 (GND), U34.2 (GND), U35.3 (GND), U35.8 (GND), U36.2 (GND), U37.2 (GND), U38.2 (GND), U39.2 (GND), U40.2 (GND), U41.2 (GND), U42.7 (GND), U42.9 (S3), U42.12 (S4), U43.3 (GND), U43.5 (D2-), U43.8 (GND), U44.2 (GND), U44.3 (2A), U45.2 (GND), U46.2 (GND); also elsewhere on the board
/GPS1_PPS: R98.1, U44.6 (1Y); also elsewhere on the board
/GPS1_RX: R79.1, U28.6 (1Y); also elsewhere on the board
/GPS1_SCL: R96.1, U42.2 (S1); also elsewhere on the board
/GPS1_SDA: R97.1, U42.5 (S2); also elsewhere on the board
/GPS1_TX: R76.2, U27.1 (1A); also elsewhere on the board
/RC_IN_RX: R75.1, U25.6 (1Y); also elsewhere on the board
/RC_IN_TX: R72.2, U24.1 (1A); also elsewhere on the board
/TELEM1_CTS: R87.1, U31.4 (2Y); also elsewhere on the board
/TELEM1_RTS: R84.2, U30.3 (2A); also elsewhere on the board
/TELEM1_RX: R83.1, U31.6 (1Y); also elsewhere on the board
/TELEM1_TX: R80.2, U30.1 (1A); also elsewhere on the board

Notes on the sheet:
External UART / I2C contracts - Stage07 recommendation / OPEN UNTESTED
3.3V logic. No external 5V direct to MCU. No PCB / footprint release / fabrication authority.
RC_IN - OpenRX Lite-UFL / full CRSF
GPS1 - MAX-M10S + IST8310 carrier
TELEM1 - RFD900x / full handshake
COMPANION - CM5 separate power / advisory only
REMOTE REQUIREMENT: 2.2k pull-up on each FC TX / RTS at remote OWN 3.3V. No FC pull-up on exposed outputs.
Remote TX / RTS >=2.0V high, <=0.8V low. Remote adapter is required; this is not an unqualified bare-cable contract.
Port power reverse blocking / shared AUX budget
AUX <=1A total / <=680uF total post-switch. RC reserve 0.5A, GPS allocation 0.15A. TELEM power DNP.
Each powered module must obey Stage05 ramp/startup envelope. No independent 5V backfeed through diode paths.
GPS open-drain I2C / optional PPS
Remote owns 2.2k pulls to remote 3.3V.
<=400kHz, <=300mm, total C <=100pF.
Companion reference only / inactive resources
Sense only >=100k load; <=1.1mA short.
No FC power to CM5, camera or lidar.
LIDAR_FC retired: PA0/PA1 reserved.
AUX_UART PE1/PE0 disabled / unassigned.
BOOT receiver service: remote-side only.
CRSF 420k; GNSS UART 115200.
TELEM initial 57600; 921600 needs test.
CM5 UART7: explicit UART/flow config.

Schematic: 06_can.kicad_sch, FC FC Rev A Stage07 - can

Parts:
C89: 100n; Capacitor_SMD__C_0603_1608Metric; MPN GRM188R71H104KA93D
C90, C91, C92, C93, C94: 100n; Capacitor_SMD__C_0603_1608Metric; MPN GRM188R71H104KA93D; not fitted
J7: CAN1; Connector_JST__JST_GH_BM04B-GHS-TBT_1x04-1MP_P1.25mm_Vertic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; MPN BM04B-GHS-TBT(LF)(SN)
J8: CAN2_EVAL; Connector_JST__JST_GH_BM04B-GHS-TBT_1x04-1MP_P1.25mm_Vertic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; MPN BM04B-GHS-TBT(LF)(SN); not fitted
R100: 10k; Resistor_SMD__R_0603_1608Metric; MPN RC0603FR-0710KL
R101, R102: 0; Resistor_SMD__R_0603_1608Metric; MPN RC0603JR-070RL
R103, R107: 120; Resistor_SMD__R_2010_5025Metric; MPN RC2010FK-07120RL; not fitted
R104: 10k; Resistor_SMD__R_0603_1608Metric; MPN RC0603FR-0710KL; not fitted
R105, R106: 0; Resistor_SMD__R_0603_1608Metric; MPN RC0603JR-070RL; not fitted
U47: TCAN332DCNR; Package_TO_SOT_SMD__SOT-23-8; MPN TCAN332DCNR; LCSC C544741
U48, U51: LM66100DCKR; Package_TO_SOT_SMD__SOT-363_SC-70-6; MPN LM66100DCKR; LCSC C2869734; not fitted
U49, U52: TPD1E05U06DYAR; TI_DYA0002_SOD523; MPN TPD1E05U06DYAR; not fitted
U50: TCAN332DCNR; Package_TO_SOT_SMD__SOT-23-8; MPN TCAN332DCNR; LCSC C544741; not fitted

Connections:
3V3_REF: C89.1, C92.1, R100.1, R104.1, U47.3 (VCC), U50.3 (VCC); also elsewhere on the board
/5V_AUX: C90.1, C93.1, U48.1 (VIN), U51.1 (VIN); also elsewhere on the board
/CAN1_RX: U47.4 (RXD); also elsewhere on the board
/CAN1_TX: R100.2, U47.1 (TXD); also elsewhere on the board
/CAN2_EVAL_RX: U50.4 (RXD); also elsewhere on the board
/CAN2_EVAL_TX: R104.2, U50.1 (TXD); also elsewhere on the board
/CAN interfaces/CAN1_5V_OUT: C91.1, J7.1, U48.3 (~CE), U48.6 (VOUT), U49.1 (I/O)
/CAN interfaces/CAN1_CANH: J7.3, R101.2, R103.1
/CAN interfaces/CAN1_CANL: J7.4, R102.2, R103.2
/CAN interfaces/CAN1_H_INT: R101.1, U47.7 (CANH)
/CAN interfaces/CAN1_L_INT: R102.1, U47.6 (CANL)
/CAN interfaces/CAN2_EVAL_5V_OUT: C94.1, J8.1, U51.3 (~CE), U51.6 (VOUT), U52.1 (I/O)
/CAN interfaces/CAN2_EVAL_CANH: J8.3, R105.2, R107.1
/CAN interfaces/CAN2_EVAL_CANL: J8.4, R106.2, R107.2
/CAN interfaces/CAN2_EVAL_H_INT: R105.1, U50.7 (CANH)
/CAN interfaces/CAN2_EVAL_L_INT: R106.1, U50.6 (CANL)
/GND: C89.2, C90.2, C91.2, C92.2, C93.2, C94.2, J7.2, J8.2, U47.2 (GND), U48.2 (GND), U49.2 (GND), U50.2 (GND), U51.2 (GND), U52.2 (GND); also elsewhere on the board

Notes on the sheet:
Classic CAN - Stage07 recommendation / OPEN UNTESTED
3.3V logic. No external 5V direct to MCU. No PCB / footprint release / fabrication authority.
CAN1 - populated 1Mbit/s <=1m
CAN2_EVAL - ENTIRE PATH DNP
Integrated bus ESD: +/-12kV IEC contact. 0R bypasses; CMC option requires reviewed EMI change.
120R termination DNP: fit ONLY at bus end. 5V output DNP. Nominal common mode +/-12V; abs +/-14V.

Schematic: 07_usb_debug.kicad_sch, FC FC Rev A Stage07 - usb_debug

Parts:
C95, C96, C97, C98, C99: 100n; Capacitor_SMD__C_0603_1608Metric; MPN GRM188R71H104KA93D
J9: USB-C GCT USB4105; GCT_USB4105_GF_A_095_S1_S4; MPN USB4105-GF-A
J10: SWD probe / target powered; Connector_JST__JST_GH_BM06B-GHS-TBT_1x06-1MP_P1.25mm_Vertic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; MPN BM06B-GHS-TBT(LF)(SN)
J11: BOOT service shunt DNP; Connector_JST__JST_GH_BM02B-GHS-TBT_1x02-1MP_P1.25mm_Vertic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; MPN BM02B-GHS-TBT(LF)(SN); not fitted
R108: 1k; Resistor_SMD__R_0603_1608Metric; MPN RC0603FR-071KL
R109: 47k; Resistor_SMD__R_0603_1608Metric; MPN RC0603FR-0747KL
R110: 22k; Resistor_SMD__R_0603_1608Metric; MPN RC0603FR-0722KL
R111, R112: 5.1k; Resistor_SMD__R_0603_1608Metric; MPN RC0603FR-075K1L
R113: 0; Resistor_SMD__R_0603_1608Metric; MPN RC0603JR-070RL
R114: 0; Resistor_SMD__R_0603_1608Metric; MPN RC0603JR-070RL; not fitted
R115: 3.3k; Resistor_SMD__R_0603_1608Metric; MPN RC0603FR-073K3L
R116: 1k; Resistor_SMD__R_0603_1608Metric; MPN RC0603FR-071KL; not fitted
R117: 680; Resistor_SMD__R_0603_1608Metric; MPN RC0603FR-07680RL
U53, U58: TPD4E05U06DQAR; Package_SON__USON-10_2.5x1.0mm_P0.5mm; MPN TPD4E05U06DQAR; LCSC C138714
U54, U57: TMUX1511PWR; Package_SO__TSSOP-14_4.4x5mm_P0.65mm; MPN TMUX1511PWR; LCSC C2866750
U55: SN74LVC2G34DBVR; Package_TO_SOT_SMD__SOT-23-6; MPN SN74LVC2G34DBVR; LCSC C347589
U56, U60: TPD1E05U06DYAR; TI_DYA0002_SOD523; MPN TPD1E05U06DYAR
U59: LM66100DCKR; Package_TO_SOT_SMD__SOT-363_SC-70-6; MPN LM66100DCKR; LCSC C2869734

Connections:
3V3_REF: C95.1, C96.1, C97.1, C98.1, J11.1, R117.1, U54.1 (SEL1), U54.4 (SEL2), U54.10 (SEL3), U54.13 (SEL4), U54.14 (VDD), U55.5 (VCC), U57.1 (SEL1), U57.4 (SEL2), U57.10 (SEL3), U57.13 (SEL4), U57.14 (VDD), U59.1 (VIN); also elsewhere on the board
/BOOT0: R116.2; also elsewhere on the board
/GND: C95.2, C96.2, C97.2, C98.2, C99.2, J9.A1 (GND), J9.A12 (GND), J9.B1 (GND), J9.B12 (GND), J10.2, R109.2, R110.2, R111.2, R112.2, R113.2, R117.2, U53.3 (GND), U53.8 (GND), U54.7 (GND), U54.9 (S3), U54.12 (S4), U55.2 (GND), U55.3 (2A), U56.2 (GND), U57.7 (GND), U58.3 (GND), U58.8 (GND), U59.2 (GND), U60.2 (GND); also elsewhere on the board
/NRST: U57.8 (D3); also elsewhere on the board
/SWCLK: U57.6 (D2); also elsewhere on the board
/SWDIO: U57.3 (D1); also elsewhere on the board
/SWO: R114.2; also elsewhere on the board
/USB and debug/BOOT_SERVICE: J11.2, R116.1
/USB and debug/NRST_PORT: J10.5, U57.9 (S3), U58.4 (D2+)
/USB and debug/SWCLK_PORT: J10.4, U57.5 (S2), U58.2 (D1-)
/USB and debug/SWDIO_PORT: J10.3, U57.2 (S1), U58.1 (D1+)
/USB and debug/SWD_REF_BLOCK: C99.1, R115.1, U59.3 (~CE), U59.6 (VOUT)
/USB and debug/SWD_REF_OUT: J10.1, R115.2, U60.1 (I/O)
/USB and debug/SWO_OPT: R114.1, U57.11 (D4)
/USB and debug/SWO_PORT: J10.6, U57.12 (S4), U58.5 (D2-)
/USB and debug/USB_CC1: J9.A5 (CC1), R111.1, U53.4 (D2+)
/USB and debug/USB_CC2: J9.B5 (CC2), R112.1, U53.5 (D2-)
/USB and debug/USB_DM_PORT: J9.A7 (D-1), J9.B7 (D-2), U53.2 (D1-), U54.5 (S2)
/USB and debug/USB_DP_PORT: J9.A6 (D+1), J9.B6 (D+2), U53.1 (D1+), U54.2 (S1)
/USB and debug/USB_SHIELD: J9.S1 (SHIELD), J9.S2 (SHIELD), J9.S3 (SHIELD), J9.S4 (SHIELD), R113.1
/USB and debug/USB_VBUS_LIMIT: R108.2, R109.1, U55.1 (1A)
/USB and debug/USB_VBUS_PORT: J9.A4 (VBUS), J9.A9 (VBUS), J9.B4 (VBUS), J9.B9 (VBUS), R108.1, U56.1 (I/O)
/USB_DM: U54.6 (D2); also elsewhere on the board
/USB_DP: U54.3 (D1); also elsewhere on the board
/USB_VBUS: R110.1, U55.6 (1Y); also elsewhere on the board

Notes on the sheet:
USB data-only / SWD recovery - Stage07 recommendation / OPEN UNTESTED
3.3V logic. No external 5V direct to MCU. No PCB / footprint release / fabrication authority.
USB-C self-powered FS / VBUS sense only
SWD and boot recovery / reference only
No VBUS-to-rail path. Ground-referenced TVS replaces USBLC steering array. No PD source/sink controller.
680R MAIN bleed: <=5.2mA
No reset button / new supervisor. Existing NRST network retained. BOOT shunt local only; USB DFU firmware validation OPEN.

Schematic: 08_storage_status.kicad_sch, FC FC Rev A Stage07 - storage_status

Parts:
C100: 22u; Capacitor_SMD__C_1210_3225Metric; MPN GRM32ER71E226KE15L
C101: 100n; Capacitor_SMD__C_0603_1608Metric; MPN GRM188R71H104KA93D
D1: GREEN optional; LED_SMD__LED_0603_1608Metric; MPN APT1608LZGCK; not fitted
J12: microSD GCT MEM2075; GCT_MEM2075_00_140_01_A; MPN MEM2075-00-140-01-A
R118: 22; Resistor_SMD__R_0603_1608Metric; MPN RC0603FR-0722RL
R119, R121, R123, R125, R127: 0; Resistor_SMD__R_0603_1608Metric; MPN RC0603JR-070RL
R120, R122, R124, R126, R128, R129: 47k; Resistor_SMD__R_0603_1608Metric; MPN RC0603FR-0747KL
R130: 1k; Resistor_SMD__R_0603_1608Metric; MPN RC0603FR-071KL; not fitted
U61, U62: TPD4E05U06DQAR; Package_SON__USON-10_2.5x1.0mm_P0.5mm; MPN TPD4E05U06DQAR; LCSC C138714

Connections:
3V3_REF: C100.1, C101.1, J12.4 (VDD), R120.1, R122.1, R124.1, R126.1, R128.1, R129.1; also elsewhere on the board
/GND: C100.2, C101.2, D1.1 (K), J12.6 (VSS), J12.SH (SHELL), U61.3 (GND), U61.8 (GND), U62.3 (GND), U62.5 (D2-), U62.8 (GND); also elsewhere on the board
/SDMMC1_CLK: R118.1; also elsewhere on the board
/SDMMC1_CMD: R119.1; also elsewhere on the board
/SDMMC1_D0: R121.1; also elsewhere on the board
/SDMMC1_D1: R123.1; also elsewhere on the board
/SDMMC1_D2: R125.1; also elsewhere on the board
/SDMMC1_D3: R127.1; also elsewhere on the board
/SD_CARD_DETECT: J12.CD (DETECT), R129.2, U62.4 (D2+); also elsewhere on the board
/STATUS_LED: R130.1; also elsewhere on the board
/Storage and status/LED_A: D1.2 (A), R130.2
/Storage and status/SD_CLK_PORT: J12.5 (CLK), R118.2, U61.1 (D1+)
/Storage and status/SD_CMD_PORT: J12.3 (CMD), R119.2, R120.2, U61.2 (D1-)
/Storage and status/SD_D0_PORT: J12.7 (DAT0), R121.2, R122.2, U61.4 (D2+)
/Storage and status/SD_D1_PORT: J12.8 (DAT1), R123.2, R124.2, U61.5 (D2-)
/Storage and status/SD_D2_PORT: J12.1 (DAT2), R125.2, R126.2, U62.1 (D1+)
/Storage and status/SD_D3_PORT: J12.2 (CD/DAT3), R127.2, R128.2, U62.2 (D1-)

Notes on the sheet:
Removable microSD / optional status - Stage07 recommendation / OPEN UNTESTED
3.3V logic. No external 5V direct to MCU. No PCB / footprint release / fabrication authority.
SDMMC1 4-bit / 3V3_MAIN only
Status and insertion policy
CD switch closes to grounded shell on insertion: active LOW. DAT3 is a data contact, not the mechanical detect.
SD startup allocation 300mA including insertion charging. Card selection, I(V,t), signal integrity and firmware remain OPEN.
Bring-up 400kHz then conservative clock; 4-bit operation test required. Never power a card from an external adapter.
PE6 LED DNP, ~1mA nominal. No new load on 3V3_SENS. No buzzer circuit in this stage.

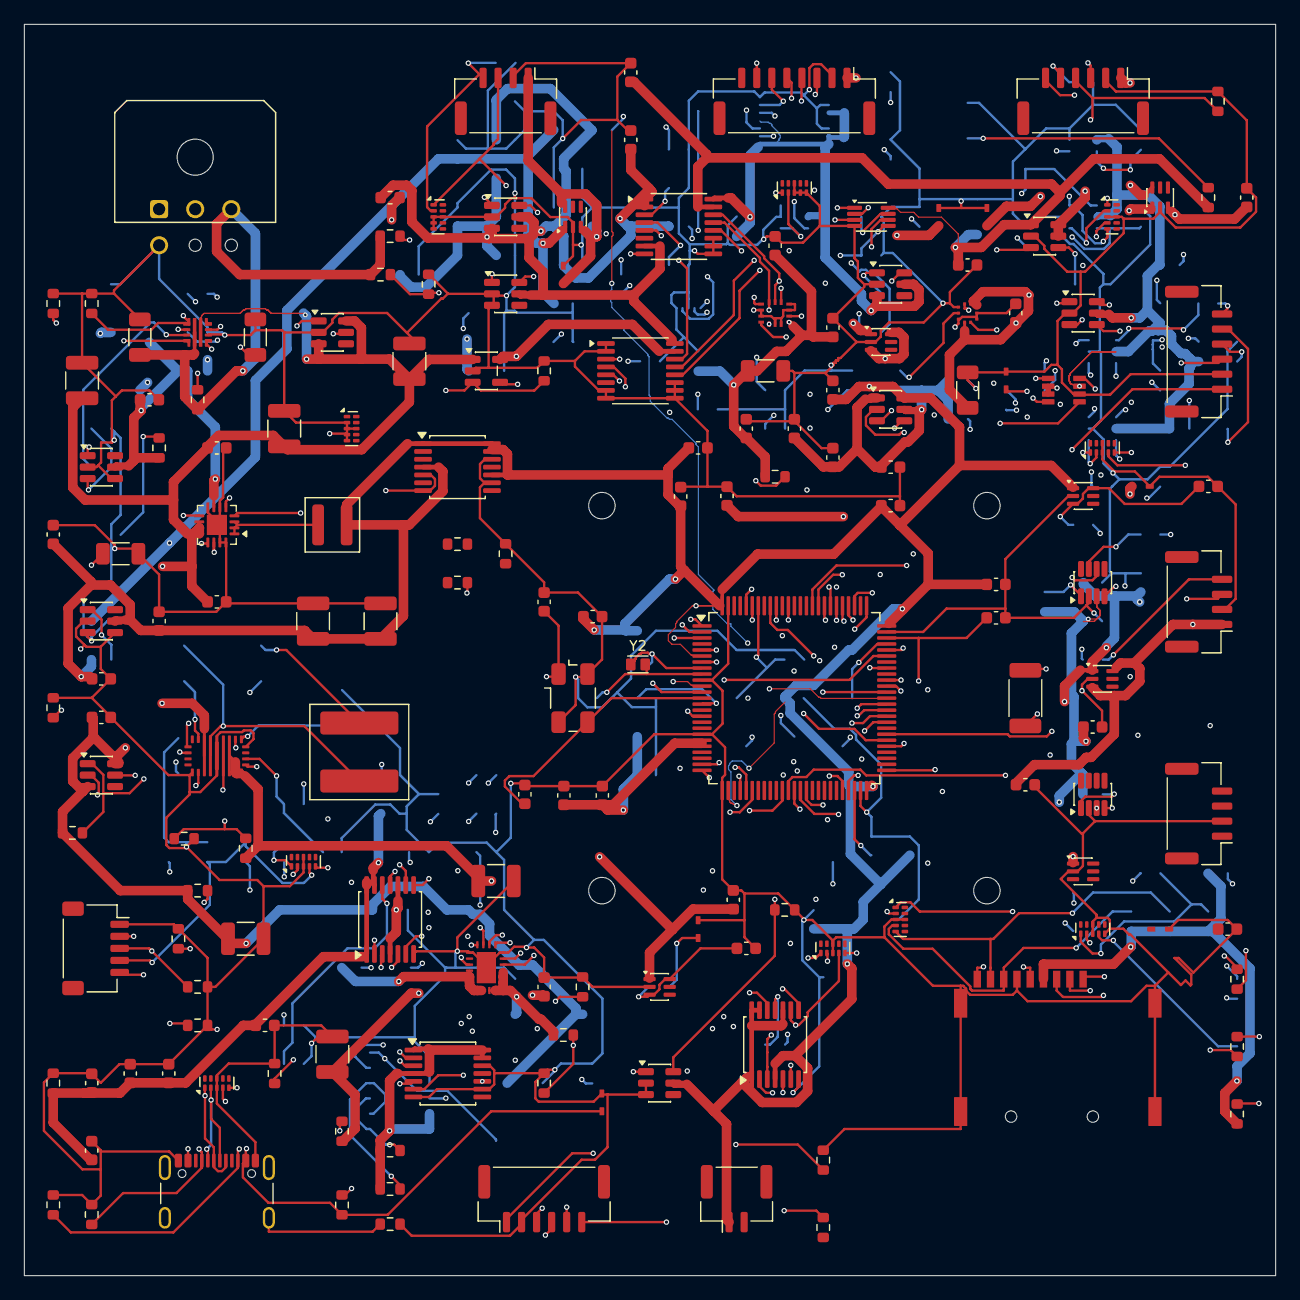
[picture p24: board FC_REV_A.kicad_pcb from above]

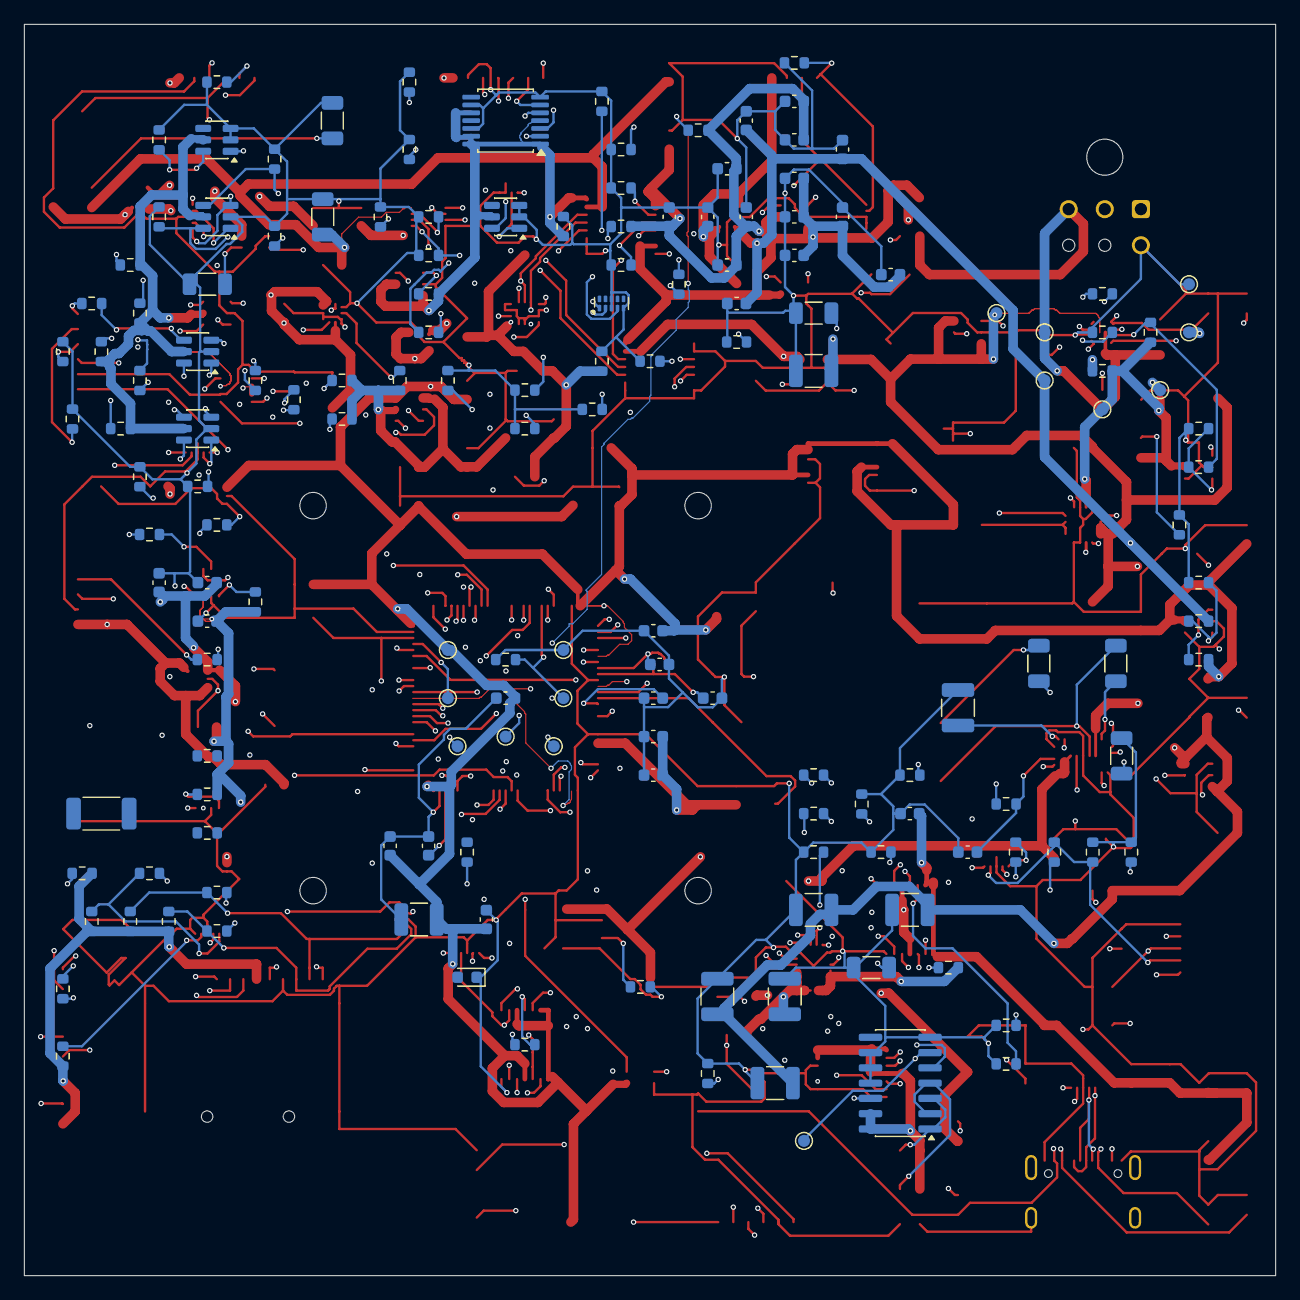
[picture p25: board FC_REV_A.kicad_pcb from below]

Board: 6 copper layers, 104.0 x 104.0 mm, 330 parts (159 on the bottom side), 181 nets.

Other parts of the board:
H1, H2, H3, H4: M2_2.2mm_PROVISIONAL
