desanv01/Flight-Controller-V1/(commit log)

2026-10-14 docs: circuit selection and subsystem boundaries
2026-10-14 docs: kicad foundation
2026-10-14 docs: stm32h743 core capture
2026-10-14 docs: power tree and correction sequence
2026-10-14 docs: imu and barometer capture
2026-10-14 docs: schematic, footprint and bom review
2026-10-14 hardware: recover pre-interface schematic entry snapshot
    [01_mcu_core.kicad_sch, 02_power.kicad_sch, 03_sensors.kicad_sch, 04_esc.kicad_sch, 05_external_ports.kicad_sch, 06_can.kicad_sch, 07_usb_debug.kicad_sch, 08_storage_status.kicad_sch]
2026-10-14 hardware: import six-layer routing and parity closeout
    [01_mcu_core.kicad_sch, 02_power.kicad_sch, 03_sensors.kicad_sch, 04_esc.kicad_sch, 05_external_ports.kicad_sch, 06_can.kicad_sch, 07_usb_debug.kicad_sch, 08_storage_status.kicad_sch]
2026-10-14 archive: index unique source experiments and reference links
    [reference-links.csv]
2026-10-14 hardware: reconcile descriptive metadata without geometry changes
    [01_mcu_core.kicad_sch, 02_power.kicad_sch, 03_sensors.kicad_sch, 04_esc.kicad_sch, 05_external_ports.kicad_sch, 06_can.kicad_sch, 07_usb_debug.kicad_sch, 08_storage_status.kicad_sch]
2026-10-14 docs: publish neutral engineering source, manufacturing and portfolio overview
    [FC_REV_A-BOM-PCBWay.csv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]
2026-10-14 docs: refine wiring display and validate local links
2026-10-14 docs: synchronize portfolio verification hashes and classify CAD data
