desanv01/Flight-Controller-V1/(notices)

Notices in the files:
docs/development/records/01-research/FC_REV_A_MASTER_RESEARCH_AND_DECISION_RECORD_2026-08-27.md:
7.3 Open-source and licensing rules:
Relevant sources include PX4, ArduPilot, Betaflight, Pixhawk hardware standards, OpenFC, OpenESC/AM32, Shirley-FC and the Udayate educational repositories.
Before copying code, schematics, footprints or artwork:
- record the repository commit/tag used;
- read the license and preserve required notices;
- distinguish hardware license from firmware/software license;
- do not imply official Pixhawk compatibility or branding without meeting the applicable standard;
- do not treat a forum, video or repository as a certification or production guarantee;
- note that `pixhawk2.1` contains mixed lic
